ccirone2/LoRa-GateLink/docs/development.md

# Development

How changes are made, verified and released. The behavioural invariants that every change must keep are in
[CLAUDE.md](../CLAUDE.md), and how each firmware layer and the web console are built (and why) in
[architecture.md](architecture.md); read both before touching the firmware.

## Toolchain

`arduino-cli` (not PlatformIO). CI builds with these versions; match them locally when chasing a build
difference:

| Package | Version |
|---|---|
| `arduino-cli` | 1.5.1 |
| `arduino:samd` core | 1.8.14 |
| `arduino:avr` core (GateSim) | 1.8.8 |
| `LoRa` (sandeepmistry) | 0.8.0 |
| `Crypto` (rweather) | 0.4.0 |
| `FlashStorage` (cmaglie) | 1.0.0 |
| `ArduinoJson` | 7.4.3 |

When updating one, change it here, in `.github/workflows/ci.yml` (every job), `release.yml`, `fuzz.yml` and
`mutate.yml` (arduino-cli: each `setup-arduino-cli` step's `version`), and in `tools/agent/cloud_setup.sh`
(arduino-cli with its SHA-256; `tests/tools/test_agent_tooling.py` checks the last against the workflows and this
table).

The formal verification (`tools/verify`, [architecture.md](architecture.md#verification)) runs on these, as CI's
`verify` job installs them; `tools/verify/docker/Dockerfile` has them all for a machine without them (Windows,
macOS). Change a version there, in `ci.yml` (with its SHA-256) and here together (`tests/tools/test_verify.py`
checks):

| Tool | Version |
|---|---|
| ESBMC | 8.5 |
| TLC (`tla2tools.jar`) | 1.7.4 |
| Java | the runner's (17 or newer) |

The web console is plain JS (ES modules) with no build step; its lint and tests need Node.js 22 and `npm ci`
(`package.json`).

The Python tools, their tests and the bench suite share one environment, locked with hashes so every machine and CI
run the same versions: `pyproject.toml` lists the dependencies (ruff 0.17.0 in its `dev` group) and `uv.lock` pins
them. Install uv 0.12.24 or newer ([docs.astral.sh/uv](https://docs.astral.sh/uv/); `pyproject.toml` refuses an
older one), then:

```sh
uv sync                        # builds .venv from uv.lock (Python 3.12, from .python-version; uv fetches it if needed)
uv run pytest tests/tools -q   # any command, run in that environment (syncing it first)
uv add 'pkg>=1.2'              # a new dependency; `uv add --dev` for tooling. Both update uv.lock: commit it
uv lock --upgrade-package pkg  # a newer version within the bounds (Dependabot proposes these weekly)
```

`uv run` is how the commands in these docs are meant to be run; with `.venv` activated they also run as written
(`pytest ...`, `python tools/...`). The tools that use only the standard library (`docgen.py`, `check_contract.py`,
`release_evidence.py`, `fw_size.py`, `bench-wiring/serve.py`, the agent hooks) run under any Python 3.10 or newer
too; `gatelink.py` and `flash.py` need the environment (pyserial), and so does `logic.py` for its `--at` actions.

## Other commands

The routine ones (compile, flash, tests, the bench suite, `tools/gatelink.py` essentials) are in
[CLAUDE.md](../CLAUDE.md). The rest:

```sh
arduino-cli upload --fqbn arduino:samd:mkrwan1310 -p COMx firmware/GateLink   # plain upload (uv run tools/flash.py bounds the waits)
arduino-cli compile --fqbn arduino:avr:uno --warnings all tools/GateSim   # bench opener simulator (tools/GateSim/README.md)
python -m http.server 8000 -d web              # serve the web console at http://localhost:8000 (Chrome/Edge; not from file://)
GATELINK_HA_URL=https://<ha>:8123 uv run pytest tests/e2e -m power   # real power cuts through the power rig (LiPo in or out; tests chosen per state)
uv run tools/gatelink.py house hist --csv f.csv   # link quality history (hourly buckets) as CSV
uv run tools/gatelink.py rftest                # radio preflight for a new MKR board (bench-testing.md)
python tools/bench-wiring/serve.py             # the bench wiring record at http://localhost:8001 (never another server)
```

`make -C tests/native` needs g++ (without it, the Docker recipe in `tests/native/README.md`), and the fuzz targets
clang (`tests/native/fuzz/README.md`).

## Where things are tracked

| What | Where |
|---|---|
| Released changes (changelog) | [GitHub Releases](https://github.com/ccirone2/LoRa-GateLink/releases), one per firmware version |
| Open bugs, investigations, bench and field tasks | [TODO.md](../TODO.md) |
| Desired features and ideas | [ROADMAP.md](../ROADMAP.md) |
| Work in progress | A branch and pull request per change |

When an item is done, remove it from TODO.md / ROADMAP.md and describe it in the pull request; the release notes
are built from the pull requests since the last tag.

## Making a change

1. Branch from `main`.
2. Make the change. Things that must change together:
   - Console protocol (`console.cpp`) ↔ the web console (`web/js/`, and the fake board in `tests/web/`) ↔
     `tools/gatelink_client/` and `tests/e2e/` ↔ [docs/console.md](console.md).
   - Log events (`log.h`/`log.cpp`) ↔ the suite ↔ docs/console.md.
   - STATUS/DIAG wire format (`roles.h`) ↔ `role_house.cpp` / `console.cpp`; both boards need the new firmware.
   - Pins or role behaviour (`pins.h`) ↔ the `WIRING` table in `web/js/wiring.js` ↔ [docs/hardware.md](hardware.md).
   - A new setting: field in `Config` + default + `PARAMS` row with a new, never reused id + group, help text and
     label in `web/js/settings.js`, then `python tools/docgen.py --write` ([config.md](config.md)). Saved config is
     stored by param id, so a changed meaning or unit needs a new id; bump `CFG_VERSION` (it only guards the
     program-flash fallback) if the struct layout changes.
3. Bump `FW_VERSION` in `firmware/GateLink/config.h` for any firmware change (see Versioning).
4. Verify:
   ```sh
   arduino-cli compile --fqbn arduino:samd:mkrwan1310 --warnings all firmware/GateLink   # no warnings in GateLink/
   npm ci && npm test         # web console: lint, unit tests, browser tests (tests/web/README.md)
   uv run ruff check tests tools     # rules in ruff.toml
   uv run tools/check_contract.py   # firmware enums, log events and console commands vs the suite and docs
   python tools/docgen.py     # reference docs vs the source (--write regenerates the generated tables)
   make -C tests/native       # host tests: link/config, and both boards' firmware in a simulated site (tests/native/README.md)
   make -C tests/native cppcheck tidy coverage   # static analysis and coverage (in Docker on Windows, as the README says)
   uv run pytest tests/tools -q   # unit tests for the tools (release_evidence.py, docgen.py, the agent hooks, key backups, the bench suite's LiPo check)
   uv run pytest tests/e2e -v        # on the bench; see tests/e2e/README.md
   ```
5. Open a pull request with a summary and the bench results (suite pass count, anything new it found). CI
   compiles the firmware and GateSim (failing on warnings in project files) and checks the firmware's size budget
   (`tools/fw_size.py`: 160 KB flash, 24 KB static RAM; raising it is a decision for the pull request), runs the host
   unit tests, lints and tests the web console (ESLint, `node --test`, Playwright), installs the locked Python
   environment (`uv sync --locked`, which fails if `uv.lock` is out of step with `pyproject.toml`), byte-compiles and
   lints the Python (`uv run ruff check tests tools`), runs the tools' unit tests (`tests/tools`), collects the e2e suite (`pytest
   --collect-only`, which catches import and fixture errors without the bench), checks the docs against the source
   (`check_contract.py`, `docgen.py`), fails a pull request that changes the firmware without bumping `FW_VERSION`,
   lints the workflows (actionlint, with shellcheck), runs cppcheck and clang-tidy (`firmware/GateLink/.clang-tidy`)
   on the firmware and reports the host tests' coverage of it (failing below 85 % of lines; tests/native/README.md):
   `make -C tests/native cppcheck tidy coverage`.
6. Merge to `main`. Once CI has passed on `main`, the web console is deployed to GitHub Pages (`pages.yml`; also
   after each release build, to bundle its `.bin`, and by hand with `gh workflow run pages.yml`).

`main` is protected by a ruleset (repository settings): changes only through a pull request, merged as a merge
commit, with CI's `firmware`, `static`, `coverage`, `web`, `python` and `workflows` jobs passing; no force pushes or
deletion. The required checks are listed by job name in the ruleset, not here: rename or split one of those jobs and
every pull request waits for the old name until the ruleset is changed with it. The fuzz and mutation jobs aren't
required (they run only when their paths change). `v*` tags can't be moved or deleted (a second ruleset).

CI's actions are pinned by commit SHA and its runners by image (`ubuntu-24.04`); Dependabot
(`.github/dependabot.yml`) proposes action, npm and Python (`uv.lock`, ruff included) updates weekly, and the nightly deps-check routine
covers the Arduino cores and libraries, arduino-cli, uv and gcovr (CI runs gcovr 8.6).

## Test suites

- **Compile:** clean, with no warnings in project files (filter the output with `grep GateLink[\\/]`); CI fails on
  them.
- **Host tests** (`tests/native`, `make -C tests/native`, run by CI; [tests/native/README.md](../tests/native/README.md)):
  `link.cpp`, `config.cpp` and `histlog.cpp` against fakes, and the system tests: both boards' whole firmware in a
  simulated site (opener, controller, power, radio channel) with monitors that check every behavioural invariant
  each simulated millisecond, each test tagged with the invariants it covers. Extend them with any behaviour change,
  especially for paths the bench can't reach (replays, restarts, wraps, power cuts mid-save, races); `XFAIL_TEST`
  marks a known open bug.
- **Mutations:** `tests/native/mutations.json` breaks each invariant in a copy of the firmware and `tools/mutate.py`
  (weekly in CI) checks a test catches it; a firmware change that moves a mutation's text fails
  `tests/tools/test_mutate.py` until the catalog follows.
- **Fuzzing:** `tests/native/fuzz` fuzzes the frame, console and config parsers with the whole firmware under
  ASan/UBSan and the relay invariants; `make -C tests/native` replays its corpus, and `fuzz/crashes/` holds
  reproducers of known bugs that must keep crashing until fixed. CI (`fuzz.yml`) searches for new crashes a minute
  per target on pull requests that touch the firmware or `tests/native`, and half an hour per target nightly.
- **Bench end-to-end suite** (`tests/e2e`, pytest; [tests/e2e/README.md](../tests/e2e/README.md)): drives both
  boards, the GateSim and the Shelly (via Home Assistant) and checks the behavioural invariants after every scenario.
  It parses console replies, log event names/values and status fields (`tests/e2e/gatelink/`, and the console client
  `tools/gatelink_client/` it shares with `tools/gatelink.py`: `board.py`, `timeline.py`, wire enums in `wire.py`), so
  change it together with `console.cpp`/`log.cpp`/`roles.h`, like the web console; `tools/check_contract.py` (run by
  CI) checks the enums, log event names and console commands against the suite and [console.md](console.md).
  Scenario timings assume its test profile (`tests/e2e/gatelink/bench.py`).

## Reference docs from source

`tools/docgen.py` keeps the reference docs provably in step with the code (stdlib Python; it reads the web
console's tables by importing `web/js/settings.js`, `wiring.js` and `logdecode.js` in Node.js):

```sh
python tools/docgen.py           # check, as CI does: exit 1 listing every drift and how to fix it
python tools/docgen.py --write   # regenerate the generated sections in place, then check the rest
```

- **Generated** (between `<!-- docgen:NAME begin -->` and `<!-- docgen:NAME end -->`; edit the source, never the
  section): [config.md](config.md), every setting with its id, range, default, when it applies and its help text
  (`PARAMS`, `configDefaults()`, `paramValid()` in `config.cpp`; `GROUPS`, `HELP`, `MUST_MATCH`, `SELECTS` in
  `web/js/settings.js`; a setting missing from `GROUPS` or `HELP` fails, as the Config tab would hide it); and the
  message types, ACK results, STATUS and DIAG layouts in [protocol.md](protocol.md) "Wire formats" (`link.h`,
  `roles.h`). Descriptions `roles.h` lacks are in `ST_MEANING`/`STI_MEANING` in `docgen.py`.
- **Checked** (hand-written, compared with the source): the status fields `appFillStatus`, `houseStatus` and
  `gateStatus` write and the console events' fields, against [console.md](console.md), with the names an
  enumerated field can take; the link history fields (`FIELDS`); each command's arguments (`req["..."]`), the
  keys its reply carries and whether it is house or gate only, and the commands held while a relay pulses
  (`blocksLoop()`, also in CLAUDE.md); log events in `log.h` order, `log.cpp` and `logdecode.js` (and against
  console.md in `check_contract.py`); pins (`pins.h`) against every doc, the bench wiring record and
  `WIRING`/`IO_LABELS`; the frame layout; the radio settings that must match; the e2e profile's "firmware
  defaults". Every backticked snake_case name in the docs (`ctrl_confirm_ms`, `link_up`,
  `test_power_loss_at_rest`) must still be a setting, field, argument, log event, e2e test or release criterion,
  so a rename can't live on in the prose (`OTHER_NAMES` in `docgen.py` takes any other kind).
- **Facts:** `FACTS` in `docgen.py` lists the constants and setting defaults the docs quote (`INTERLOCK_MS`,
  `BOOT_SETTLE_MS`, the watchdog, the radio defaults, toolchain versions, ...). Each reads its value from the
  source with one regex and finds every quote of it with another, converting units (`s` turns ms into s). Two
  kinds of quote are checked without an entry: a setting's default ("`setting` (default X)", "`setting`, default
  on", "`setting` is X by default", "`setting` defaults to X", "the default `setting` of X") against
  `configDefaults()`, and a time constant next to its name ("`INTERLOCK_MS` (100 ms)", "100 ms (`INTERLOCK_MS`)").
  When a doc quotes a new value another way, add a fact next to the similar ones:

  ```python
  D("TXQ_LEN", f"{FW}/link.cpp", Q(PRO, r"queued (\w+) deep"), Q(ARCH, r"wait in a (\d+)-deep queue")),
  ```

  A space in a doc pattern matches any whitespace, line breaks included; a quote's first group is the value
  (digits, `0x..`, or a word such as "four"). A reworded doc fails with "no quote of ...": fix the pattern.

## Versioning

`FW_VERSION` is `MAJOR.MINOR.PATCH`, reported by `info`, `status` and the remote diagnostics.

- **PATCH:** fixes and small additions that keep the config layout and the radio wire format.
- **MINOR:** a new feature or input, a `CFG_VERSION` bump, or a change that needs both boards updated together
  (STATUS/DIAG layout, frame format).
- **MAJOR:** reserved for a protocol break with no upgrade path, or 1.0 at the install.

Saved config survives uploads (from 0.5.0) and is matched by param id, so an added setting takes its default
and a removed one is ignored (log event `cfg`, b; from 0.13.3 an older firmware's saves keep it in the record,
so it's back after the next upgrade). Say so in the release notes when that happens, and when a
config exported from the old version may not import cleanly.

## Releasing

After the pull request carrying a new `FW_VERSION` is merged (`/release` in Claude Code walks through this):

1. Run the bench on the merged version as [release-criteria.md](release-criteria.md) asks for its kind (PATCH:
   the full suite and a soak; MINOR adds the power runs with LiPos out and in, a 60-minute long soak and a full
   suite at 17 dBm; MAJOR adds a 24-hour soak and the install checks).
2. `python tools/release_evidence.py collect vX.Y.Z` writes the evidence, `docs/releases/vX.Y.Z.md`, from the
   runs' `summary.json` (exit 1 while a criterion is unmet). Merge it in a pull request with the bench results in
   its body.
3. Once CI has passed on that merge commit, `python tools/release_evidence.py check vX.Y.Z --ci`, then create a
   draft release with notes on the merge commit and run the release workflow:
   ```sh
   gh release create vX.Y.Z --draft --target <merge-commit-sha> --title "vX.Y.Z — <one-line summary>" --notes-file notes.md
   gh workflow run release.yml -f tag=vX.Y.Z
   ```
   Releases are immutable once published (a repository setting since v0.17.0): the tag can't move, and files can't be
   added, replaced or removed. So a release is never published by hand while its files aren't attached.
4. The `release` workflow checks the draft (its target a full SHA on `main`, the tag still free), `FW_VERSION` and
   the evidence (`check --ci`), builds the firmware at that commit with a read-only token, attaches
   `GateLink-vX.Y.Z.bin`, `GateLink-vX.Y.Z.bin.sha256` and the evidence as `GateLink-vX.Y.Z-evidence.md` to the draft,
   and publishes it, which creates the tag. GitHub attests an immutable release (`gh release verify`). Anything that
   fails before it publishes leaves the draft unpublished; it is fixed and the workflow started again. When it succeeds the `pages` workflow checks the `.bin` against that `.sha256` and redeploys the
   web console with it and a `firmware/latest.json` (version, file, sha256, size) bundled in (the page can't fetch release assets from github.com: no CORS), so **Board →
   Firmware update** offers it. They are never committed (`web/firmware/` is ignored).

The web console flashes over Web Serial by speaking the Arduino SAM-BA bootloader protocol itself (`SamBa` in
`web/js/samba.js`, driven by `web/js/firmware.js`): a 1200-baud open/close resets the board into the bootloader (USB PID 0x0059, a separate port
grant), then erase from 0x2000 (`X`), 4 KB chunks staged in RAM and written (`S` + `Y`), CRC-16 check (`Z`)
and a reset. The touch itself erases the application's first flash row (the vector table: the SAMD core's `banzai()`
in `Reset.cpp`, so the bootloader stays in charge), so a board reset into its bootloader that way boots again only
once an image is written; a double-tap of the reset button enters it without erasing anything. It recognises GateLink images by the `GATELINK_FW=x.y.z` marker (`FW_MARKER`, `config.cpp`; the
version reported by `info`/`status` is read from it so the linker keeps it).

Release notes template:

```markdown
**Upgrade:** <flash both boards | gate only | ...>. <Config layout changed (CFG_VERSION n): re-apply config.>

## Firmware
- ...

## Web console
- ...

## Tests and tools
- ...

## Bench results
<KIND> release, all criteria met: [evidence](https://github.com/ccirone2/LoRa-GateLink/blob/vX.Y.Z/docs/releases/vX.Y.Z.md).
- Full suite: N passed. Soak: 20 cycles, <latencies>. <Power, long soak, 17 dBm runs for MINOR.> <Reruns.>
  <Anything notable.>

PRs: #n
```

## Claude Code skills

Project skills live in `.claude/skills/` (`/implement`, `/flash`, `/bench`, `/release`, `/doc-audit`,
`/pr-followup`); [agent-tooling.md](agent-tooling.md) describes each, with the hooks and the nightly routines.
