ccirone2/LoRa-GateLink/docs/config.md

# Settings reference

Every setting a board keeps in its saved config, by the name `config.get` returns and `config.set` and
`remote.set` take ([console.md](console.md)), in the groups of the web console's Config tab. Values are integers
in the unit the name ends with (`_ms`, `_s`, `_hz`; `tx_power` in dBm); a 0/1 setting is an off/on toggle. Apply
sets a value at once and Save keeps it across reboots. The saved config survives firmware uploads and is stored
by id, so an id is never reused: a setting whose meaning or unit changes gets a new one.

The tables below are generated from the firmware (`PARAMS[]`, `configDefaults()` and `paramValid()` in
`firmware/GateLink/config.cpp`) and the Config tab's own tables (`web/js/settings.js`) by `tools/docgen.py`.

<!-- docgen:params begin -->
<!-- Generated by tools/docgen.py from firmware/GateLink/config.cpp (PARAMS, configDefaults, paramValid) and web/js/settings.js (GROUPS, HELP, MUST_MATCH, SELECTS): edit the source, then run python tools/docgen.py --write. -->

**Range** is what `config.set` accepts. **Applies:** *at once*; *radio restart* (applied at once, the radio
re-initialises); *after reboot* (the board keeps running as before until it restarts). *remote*: the house can
write the gate's over LoRa (`remote.set`). *both boards*: must be the same on both boards (marked * on the Config
tab). **What it does** is the Config tab's help text.

## General

| Setting | Id | Range | Default | Applies | What it does |
|---|---|---|---|---|---|
| `role` | 1 | 0 (unset), 1 (house), 2 (gate) | 0 (unset) | after reboot | Which end this board is: house (next to the controller) or gate (at the opener). Takes effect after Save and reboot. |
| `net_id` | 2 | 0–255 | 66 (0x42) | at once, both boards | Both boards must match. Change it only if another GateLink pair shares the channel nearby. |

## Radio

| Setting | Id | Range | Default | Applies | What it does |
|---|---|---|---|---|---|
| `freq_hz` | 3 | 862000000–928000000 (862–928 MHz) | 915000000 (915 MHz) | radio restart, both boards | Both boards must match. US 902–928 MHz, EU 863–870 MHz. Move off the default only if Link history shows a high noise floor. |
| `sf` | 4 | 7–12 | 9 | radio restart, both boards | Both boards must match. Raise it a step at a time if the link is weak or drops; each step roughly doubles airtime, so replies get slower. Lower it for faster replies on a strong link. |
| `bw_hz` | 5 | 125000 (125 kHz), 250000 (250 kHz), 500000 (500 kHz) | 500000 (500 kHz) | radio restart, both boards | Both boards must match. Keep 500 kHz in the US (keeps a single-channel link within FCC rules). Narrower reaches further but every frame takes longer. |
| `cr` | 6 | 5–8 | 5 | radio restart, both boards | Both boards must match. Extra error correction, 4/5 to 4/8. Raise it if Link history shows CRC errors with a decent signal; frames get longer. |
| `tx_power` | 7 | 2–20 | 17 | radio restart | Transmit power in dBm; may differ between the boards. Lower it on USB power or at short range (full power can brown out a weak supply); raise it if the link is marginal. |
| `sync_word` | 8 | 0–255 | 18 (0x12) | radio restart, both boards | Both boards must match. Rarely changed: it filters out other LoRa networks on the same channel. |

## Link

| Setting | Id | Range | Default | Applies | What it does |
|---|---|---|---|---|---|
| `retries` | 9 | 0–10 | 8 | at once, remote | Resends of an unacknowledged message, spread over its lifetime. Raise it on a lossy link; lower it to keep the channel quieter. |
| `heartbeat_s` | 10 | 5–3600 | 30 | at once, remote | Gate: how often it reports status when nothing changes. Shorter spots a dead link sooner but uses more airtime. The house waits at least 2.5 heartbeats before calling the link lost. |
| `link_timeout_s` | 11 | 15–10800 | 100 | at once, remote | House: no status report from the gate this long = link lost (the contact sensor then reads open). Raise it if short dropouts cause false alarms; it is never shorter than 2.5 gate heartbeats. Gate: nothing heard from the house this long (at least 2.5 of its own heartbeats) = link down, for its LED and fault output. |
| `cmd_ttl_s` | 12 | 2–120 | 10 | at once | House: how long a gate command keeps being retried before it is dropped (never fired late). Raise it if commands give up during short dropouts; lower it so a stale command isn’t delivered seconds later. |

## Inputs

| Setting | Id | Range | Default | Applies | What it does |
|---|---|---|---|---|---|
| `debounce_ms` | 13 | 10–1000 | 50 | at once, remote | How long an input must hold steady before it counts. Raise it if long field wires or a bouncy contact show up as flicker in the log. |

## Gate node

| Setting | Id | Range | Default | Applies | What it does |
|---|---|---|---|---|---|
| `pulse_ms` | 16 | 100–5000 (0.1–5 s) | 500 (0.5 s) | at once, remote | Gate: how long the OPEN/CLOSE contact closes. Raise it if the opener misses short presses; keep it short, as other devices share these inputs. |
| `travel_timeout_s` | 17 | 5–300 | 60 | at once, remote | Longest a full open or close should take. Set it a little above your gate’s real travel time; past it, the gate counts as stuck. Set it on the gate (here or with a remote write): the house follows the gate’s value. |
| `power_sense` | 26 | 0–1 | 1 (on) | at once, remote | Gate: IN3 watches the AC-powered 24 V supply. Without AC, commands run only while a limit reads; a limit that still reads (the opener runs on its battery) is trusted, and with none the gate reads “no power” instead of between. Turn off only if IN3 isn’t wired. |
| `closed_sense` | 34 | 0–1 | 0 (off) | at once | Gate: IN4 is a second closed sensor on the gate leaf (a magnetic contact), so a failed closed-limit relay can’t make an open gate read closed. The gate reads closed only while the sensor and the closed limit agree; if they disagree for 5 s it reads fault. Turn on only once the sensor is fitted and wired: without one the gate never reads closed. |

## House node

| Setting | Id | Range | Default | Applies | What it does |
|---|---|---|---|---|---|
| `ctrl_sync` | 18 | 0–1 | 1 (on) | at once | House: K1 drives the controller’s switch input so the controller always shows the real gate state. Turn off only if the controller has no switch input. |
| `sync_window_ms` | 19 | 500–10000 (0.5–10 s) | 3000 (3 s) | at once | House: after K1 changes, controller changes count as its echo, not a command, for this long. Raise it if a slow controller’s echo turns into an unwanted gate command. |
| `resync_ms` | 20 | 200–5000 (0.2–5 s) | 1000 (1 s) | at once | House: how long K1 is released when re-syncing a controller that is out of step. Raise it if the controller doesn’t notice a short blip. |
| `mismatch_timeout_s` | 21 | 10–600 | 75 | at once | House: how long the controller may disagree with the gate before K1 re-syncs it (at once after boot or power return). Lower it for faster correction; raise it if re-syncs fight someone using the controller. |
| `sensor_invert` | 22 | 0–1 | 0 (off) | at once | House: flips the contact sensor output (K2). Use it if the alarm shows open while the gate is closed. |
| `linkloss_open` | 23 | 0–1 | 1 (on) | at once | House: the contact sensor reads open while the link is lost, so the alarm never trusts a stale “closed”. Turn off only if dropouts cause too many false alerts. |
| `ctrl_power_sense` | 27 | 0–1 | 1 (on) | at once | House: IN2 watches the controller’s supply, so a power cut (which drops its relay) isn’t mistaken for a close command. Turn off only if IN2 isn’t wired. |
| `ctrl_power_pmic` | 31 | 0–1 | 1 (on) | at once | House: the board’s own supply counts as controller power too, since both run off the same supply (the board through its 5 V converter). It notices a cut or a short dip within milliseconds, before the controller’s relay drops, where the IN2 opto lags ~1.7 s and can miss short dips. Turn off if the board has its own supply, or while it runs on a USB cable that carries power. |
| `ctrl_confirm_ms` | 28 | 0–5000 (0–5 s) | 500 (0.5 s) | at once | House: a controller switch-OFF waits this long before it becomes a CLOSE, so one caused by the controller losing power (its relay drops before the power sense notices) can be discarded. Switch-ON (OPEN) goes at once: a power loss can’t cause it. With `ctrl_power_pmic` the board’s supply drops first, so 0.5 s is plenty; with IN2 alone keep it above the opto’s lag (~1.7 s on the bench, so 3000). |
| `ctrl_settle_ms` | 29 | 0–60000 (0–60 s) | 10000 (10 s) | at once | House: after the controller powers up (or the house boots), its changes count as sync for at least this long. Raise it if the controller takes longer to settle after power returns. |

## Fault output

| Setting | Id | Range | Default | Applies | What it does |
|---|---|---|---|---|---|
| `fault_out` | 32 | 0–1 | 0 (off) | at once | Use D5 as a “needs attention” output for the alarm system: high while this board is healthy (radio working, link up and, as the gate sees or reports it, AC power present, no limit fault and no reboot loop), low otherwise, and low after a restart until the board has started up. A dead board or a cut wire reads as a fault too. 3.3 V, a few mA: wire it to an opto or a relay module input, never a relay coil. Off: D5 stays an unused input. Takes effect at once; set it on each board that has D5 wired. |
| `fault_hold_s` | 33 | 0–600 | 10 | at once, remote | How long a problem must last before D5 goes low, so a short dropout or blip doesn’t trip the alarm. Recovery raises D5 at once. 0 = low as soon as a problem appears. |

## Advanced

| Setting | Id | Range | Default | Applies | What it does |
|---|---|---|---|---|---|
| `in1_invert` | 14 | 0–1 | 0 (off) | at once | IN1 (house: controller output; gate: open limit). Leave off. Inverted, a dead opto or cut wire reads as active; fix a reversed signal in the wiring instead. |
| `in2_invert` | 15 | 0–1 | 0 (off) | at once | IN2 (house: controller power; gate: closed limit). Leave off. Inverted, a dead opto or cut wire reads as active; fix a reversed signal in the wiring instead. |
| `in3_invert` | 24 | 0–1 | 0 (off) | at once | IN3 (house: spare; gate: AC power). Leave off. Inverted, a dead opto or cut wire reads as active; fix a reversed signal in the wiring instead. |
| `in4_invert` | 25 | 0–1 | 0 (off) | at once | IN4 (house: spare; gate: closed sensor, or spare). Leave off. Inverted, a dead opto or cut wire reads as active; fix a reversed signal in the wiring instead. |
| `uart_console` | 30 | 0–1 | 0 (off) | at once | Also run this console on the board’s serial pins (13 RX, 14 TX; 3.3 V, 250 kbaud) for a USB-to-UART adapter. Bench power testing only: the adapter keeps its port while the board is unpowered. Leave off at the install. |

<!-- docgen:params end -->
