ccirone2/LoRa-GateLink/docs/releases/v0.20.7.md

# GateLink v0.20.7: release evidence

**PATCH** release (previous release: v0.20.1), commit `63a90f0810`, firmware tree `34c4a9f282`. Written by `python tools/release_evidence.py collect v0.20.7` on 2026-10-30; the criteria are in [docs/release-criteria.md](../release-criteria.md).

**All criteria for this release are met.**

## Criteria

| Criterion | Required for | Met | Evidence |
|---|---|---|---|
| `ci`: CI green on the release commit (all jobs) | every release | yes | [ci.yml run](https://github.com/ccirone2/LoRa-GateLink/actions/runs/41081198402): success (coverage success, verify success, static success, web success, python success, workflows success, firmware success) |
| `full_suite`: Full suite: default selection, GATELINK_KEY set, the bench's own tx_power | every release | yes | run 20261030-080208: 70 passed |
| `soak`: Soak: -m soak, at least 20 cycles | every release | yes | run 20261030-082420: 1 passed |
| `power_lipo_out`: Power: -m power with both LiPos out | MINOR, MAJOR | no (not required) | no run yet: `pytest tests/e2e -m power` |
| `power_lipo_in`: Power: -m power with both LiPos in | MINOR, MAJOR | no (not required) | no run yet: `pytest tests/e2e -m power` |
| `longsoak_60m`: Long soak: -m longsoak, at least 60 min | MINOR, MAJOR | no (not required) | no run yet: `pytest tests/e2e -m longsoak --soak-minutes 60` |
| `full_suite_17dbm`: Full suite at --tx-power 17 on the install-like supplies | MINOR, MAJOR | no (not required) | no run yet: `GATELINK_KEY=<key> pytest tests/e2e -v --tx-power 17`; other runs of its tests: 20261030-080208 |
| `longsoak_24h`: Long soak: -m longsoak, at least 24 h | MAJOR | no (not required) | no run yet: `pytest tests/e2e -m longsoak --soak-minutes 1440` |
| `install_rf`: Real RF at the install site (TODO.md: Real RF) | MAJOR | no (not required) | not ticked in the install notes (`- [x] install_rf: <what was done, when, numbers>`) |
| `install_full_power`: Full power at the install for days (TODO.md: Full power at the install) | MAJOR | no (not required) | not ticked in the install notes (`- [x] install_full_power: <what was done, when, numbers>`) |

## Runs

### 20261030-080208

- **When:** 2026-10-30 08:02 to 08:24 -0500 (22 min)
- **Command:** `pytest tests/e2e -v`
- **Options:** the boards' saved tx_power (5 dBm or less), GATELINK_KEY set
- **Commit:** `986732ab3f`, firmware tree `34c4a9f282`
- **Boards:** house 0.20.7 (…183013, COM5), gate 0.20.7 (…0C301C, COM21)
- **Results:** 70 passed
- **Counts for:** full_suite
- **Facts:**
  - consoles: house USB COM5 + UART tap COM17, gate USB COM21 + UART tap COM12
  - controller power: wired (in2_invert fakes a loss)
  - key id: 16b5da85
  - firmware: 0.20.7
  - config store: house spi, gate spi
  - free_ram after hist.get, config.get and log.get (house): 2267 B
  - free_ram after hist.get, config.get and log.get (gate): 2267 B
  - ping RTT: 152 ms
  - RSSI/SNR at house: -45 dBm / 7.5 dB
  - RSSI/SNR at gate: -44 dBm / 5 dB
  - controller SW mode: follows the SW level
  - closest relay interlock gap (ms): 100
  - noise floor (house / gate): -104 / -103 dBm
- **Anomalies:** none

### 20261030-082420

- **When:** 2026-10-30 08:24 to 08:32 -0500 (8 min)
- **Command:** `pytest tests/e2e -m soak --cycles 20 -v`
- **Options:** the boards' saved tx_power (5 dBm or less), --cycles 20, no GATELINK_KEY
- **Commit:** `986732ab3f`, firmware tree `34c4a9f282`
- **Boards:** house 0.20.7 (…183013, COM5), gate 0.20.7 (…0C301C, COM21)
- **Results:** 1 passed
- **Counts for:** soak
- **Facts:**
  - consoles: house USB COM5 + UART tap COM17, gate USB COM21 + UART tap COM12
  - controller power: wired (in2_invert fakes a loss)
- **Anomalies:** none

## Install notes

<!-- notes:start -->
Hand-written, and kept when the file is collected again: anything a reviewer should know.
<!-- notes:end -->

<!-- release-evidence
{
 "version": "0.20.7",
 "kind": "patch",
 "previous": "0.20.1",
 "commit": "63a90f0810767cfd521c10463e4b180c60cb3afb",
 "firmware_tree": "34c4a9f282c5740eae42be06d689e2ec99d66b49",
 "collected": "2026-10-30T15:23:36-05:00",
 "schema": 1,
 "criteria": [
  {
   "id": "ci",
   "title": "CI green on the release commit (all jobs)",
   "required_for": "patch",
   "required": true,
   "manual": false,
   "met": true,
   "evidence": "[ci.yml run](https://github.com/ccirone2/LoRa-GateLink/actions/runs/41081198402): success (coverage success, verify success, static success, web success, python success, workflows success, firmware success)",
   "runs": []
  },
  {
   "id": "full_suite",
   "title": "Full suite: default selection, GATELINK_KEY set, the bench's own tx_power",
   "required_for": "patch",
   "required": true,
   "manual": false,
   "met": true,
   "evidence": "run 20261030-080208: 70 passed",
   "runs": [
    "20261030-080208"
   ]
  },
  {
   "id": "soak",
   "title": "Soak: -m soak, at least 20 cycles",
   "required_for": "patch",
   "required": true,
   "manual": false,
   "met": true,
   "evidence": "run 20261030-082420: 1 passed",
   "runs": [
    "20261030-082420"
   ]
  },
  {
   "id": "power_lipo_out",
   "title": "Power: -m power with both LiPos out",
   "required_for": "minor",
   "required": false,
   "manual": false,
   "met": false,
   "evidence": "no run yet: `pytest tests/e2e -m power`",
   "runs": []
  },
  {
   "id": "power_lipo_in",
   "title": "Power: -m power with both LiPos in",
   "required_for": "minor",
   "required": false,
   "manual": false,
   "met": false,
   "evidence": "no run yet: `pytest tests/e2e -m power`",
   "runs": []
  },
  {
   "id": "longsoak_60m",
   "title": "Long soak: -m longsoak, at least 60 min",
   "required_for": "minor",
   "required": false,
   "manual": false,
   "met": false,
   "evidence": "no run yet: `pytest tests/e2e -m longsoak --soak-minutes 60`",
   "runs": []
  },
  {
   "id": "full_suite_17dbm",
   "title": "Full suite at --tx-power 17 on the install-like supplies",
   "required_for": "minor",
   "required": false,
   "manual": false,
   "met": false,
   "evidence": "no run yet: `GATELINK_KEY=<key\u003e pytest tests/e2e -v --tx-power 17`; other runs of its tests: 20261030-080208",
   "runs": []
  },
  {
   "id": "longsoak_24h",
   "title": "Long soak: -m longsoak, at least 24 h",
   "required_for": "major",
   "required": false,
   "manual": false,
   "met": false,
   "evidence": "no run yet: `pytest tests/e2e -m longsoak --soak-minutes 1440`",
   "runs": []
  },
  {
   "id": "install_rf",
   "title": "Real RF at the install site (TODO.md: Real RF)",
   "required_for": "major",
   "required": false,
   "manual": true,
   "met": false,
   "evidence": "not ticked in the install notes (`- [x] install_rf: <what was done, when, numbers\u003e`)",
   "runs": []
  },
  {
   "id": "install_full_power",
   "title": "Full power at the install for days (TODO.md: Full power at the install)",
   "required_for": "major",
   "required": false,
   "manual": true,
   "met": false,
   "evidence": "not ticked in the install notes (`- [x] install_full_power: <what was done, when, numbers\u003e`)",
   "runs": []
  }
 ],
 "reruns": [],
 "runs": [
  {
   "run": "20261030-080208",
   "start": "2026-10-30T08:02:04-05:00",
   "end": "2026-10-30T08:24:14-05:00",
   "minutes": 22.2,
   "command": "pytest tests/e2e -v",
   "selection": {
    "markexpr": "not soak and not longsoak and not rf and not power",
    "keyword": "",
    "paths": [
     "tests/e2e"
    ]
   },
   "commit": "986732ab3fbe94ba0d7cdb67ad7f618ca40e0768",
   "firmware_tree": "34c4a9f282c5740eae42be06d689e2ec99d66b49",
   "dirty_paths": [],
   "boards": {
    "gate": {
     "fw": "0.20.7",
     "usb_serial": "B86085DB5031344E432E3120FF0C301C",
     "port": "COM21",
     "cfg_store": "spi",
     "flash_id": "ef4015"
    },
    "house": {
     "fw": "0.20.7",
     "usb_serial": "066322EE5030534D4D2E3120FF183013",
     "port": "COM5",
     "cfg_store": "spi",
     "flash_id": "ef4015"
    }
   },
   "options": {
    "tx_power": null,
    "cycles": 20,
    "soak_minutes": 120,
    "rf_cycles": 5,
    "gatelink_key": true,
    "ha_power_entity": null,
    "no_uart": false
   },
   "counts": {
    "passed": 70
   },
   "counts_for": [
    "full_suite"
   ],
   "failed": [],
   "skipped": [],
   "latencies": [
    {
     "name": "controller edge -\u003e power sense drop (must be < ctrl_confirm_ms)",
     "n": 1,
     "min": 0.10699999999999932,
     "median": 0.10699999999999932,
     "max": 0.10699999999999932
    },
    {
     "name": "IN2 dark -\u003e health ctrl_sense (30 s)",
     "n": 1,
     "min": 30.235460499301553,
     "median": 30.235460499301553,
     "max": 30.235460499301553
    },
    {
     "name": "outage -\u003e house link_down",
     "n": 1,
     "min": 11.211250200763345,
     "median": 11.211250200763345,
     "max": 11.211250200763345
    },
    {
     "name": "link restored -\u003e house link_up",
     "n": 1,
     "min": 4.964531700506825,
     "median": 4.964531700506825,
     "max": 4.964531700506825
    },
    {
     "name": "cmd_sent -\u003e cmd_dropped (dead link)",
     "n": 1,
     "min": 10.009999999999991,
     "median": 10.009999999999991,
     "max": 10.009999999999991
    },
    {
     "name": "cmd_sent -\u003e gate cmd_rx (after short outage)",
     "n": 1,
     "min": 2.36099999999999,
     "median": 2.36099999999999,
     "max": 2.36099999999999
    },
    {
     "name": "cmd_sent -\u003e gate cmd_rx (after 4 s outage)",
     "n": 1,
     "min": 4.126999999999953,
     "median": 4.126999999999953,
     "max": 4.126999999999953
    },
    {
     "name": "link restored -\u003e house learns missed move",
     "n": 1,
     "min": 4.703220000177623,
     "median": 4.703220000177623,
     "max": 4.703220000177623
    },
    {
     "name": "link restored -\u003e house shows the hidden move",
     "n": 1,
     "min": 4.676850800655757,
     "median": 4.676850800655757,
     "max": 4.676850800655757
    },
    {
     "name": "missed move: K2 open (polled)",
     "n": 1,
     "min": 5.272418799556817,
     "median": 5.272418799556817,
     "max": 5.272418799556817
    },
    {
     "name": "replayed HELLO -\u003e held command released",
     "n": 1,
     "min": 1.3999999999999773,
     "median": 1.3999999999999773,
     "max": 1.3999999999999773
    },
    {
     "name": "controller -\u003e house cmd_sent",
     "n": 2,
     "min": 0.2794953002854754,
     "median": 0.3257570000365604,
     "max": 0.3257570000365604
    },
    {
     "name": "cmd_sent -\u003e gate pulse (LoRa)",
     "n": 2,
     "min": 0.12400000000002365,
     "median": 0.1710000000000491,
     "max": 0.1710000000000491
    },
    {
     "name": "gate pulse -\u003e opener moving",
     "n": 2,
     "min": 0.03099999999994907,
     "median": 0.12400000000002365,
     "max": 0.12400000000002365
    },
    {
     "name": "gate state -\u003e house state (LoRa)",
     "n": 2,
     "min": 0.06700000000000728,
     "median": 0.10900000000003729,
     "max": 0.10900000000003729
    },
    {
     "name": "controller -\u003e house shows open (incl. 8s travel)",
     "n": 1,
     "min": 8.643495300285508,
     "median": 8.643495300285508,
     "max": 8.643495300285508
    },
    {
     "name": "controller -\u003e house shows closed (incl. 8s travel)",
     "n": 1,
     "min": 8.57975700003658,
     "median": 8.57975700003658,
     "max": 8.57975700003658
    },
    {
     "name": "command -\u003e travel timeout reported",
     "n": 1,
     "min": 15.02800000000002,
     "median": 15.02800000000002,
     "max": 15.02800000000002
    },
    {
     "name": "travel timeout -\u003e house resync",
     "n": 1,
     "min": 0.17000000000007276,
     "median": 0.17000000000007276,
     "max": 0.17000000000007276
    },
    {
     "name": "gate reboot -\u003e session re-established",
     "n": 1,
     "min": 3.175450200214982,
     "median": 3.175450200214982,
     "max": 3.175450200214982
    },
    {
     "name": "house reboot -\u003e controller resynced",
     "n": 1,
     "min": 13.621373599395156,
     "median": 13.621373599395156,
     "max": 13.621373599395156
    }
   ],
   "facts": {
    "consoles": "house USB COM5 + UART tap COM17, gate USB COM21 + UART tap COM12",
    "controller power": "wired (in2_invert fakes a loss)",
    "key id": "16b5da85",
    "firmware": "0.20.7",
    "config store": "house spi, gate spi",
    "free_ram after hist.get, config.get and log.get (house)": "2267 B",
    "free_ram after hist.get, config.get and log.get (gate)": "2267 B",
    "ping RTT": "152 ms",
    "RSSI/SNR at house": "-45 dBm / 7.5 dB",
    "RSSI/SNR at gate": "-44 dBm / 5 dB",
    "controller SW mode": "follows the SW level",
    "closest relay interlock gap (ms)": "100",
    "noise floor (house / gate)": "-104 / -103 dBm"
   },
   "anomalies": []
  },
  {
   "run": "20261030-082420",
   "start": "2026-10-30T08:24:17-05:00",
   "end": "2026-10-30T08:32:25-05:00",
   "minutes": 8.1,
   "command": "pytest tests/e2e -m soak --cycles 20 -v",
   "selection": {
    "markexpr": "soak",
    "keyword": "",
    "paths": [
     "tests/e2e"
    ]
   },
   "commit": "986732ab3fbe94ba0d7cdb67ad7f618ca40e0768",
   "firmware_tree": "34c4a9f282c5740eae42be06d689e2ec99d66b49",
   "dirty_paths": [],
   "boards": {
    "gate": {
     "fw": "0.20.7",
     "usb_serial": "B86085DB5031344E432E3120FF0C301C",
     "port": "COM21",
     "cfg_store": "spi",
     "flash_id": "ef4015"
    },
    "house": {
     "fw": "0.20.7",
     "usb_serial": "066322EE5030534D4D2E3120FF183013",
     "port": "COM5",
     "cfg_store": "spi",
     "flash_id": "ef4015"
    }
   },
   "options": {
    "tx_power": null,
    "cycles": 20,
    "soak_minutes": 120,
    "rf_cycles": 5,
    "gatelink_key": false,
    "ha_power_entity": null,
    "no_uart": false
   },
   "counts": {
    "passed": 1
   },
   "counts_for": [
    "soak"
   ],
   "failed": [],
   "skipped": [],
   "latencies": [
    {
     "name": "controller -\u003e house cmd_sent",
     "n": 40,
     "min": 0.16959969979524203,
     "median": 0.3231089997664043,
     "max": 0.6480593000575823
    },
    {
     "name": "cmd_sent -\u003e gate pulse (LoRa)",
     "n": 40,
     "min": 0.014999999999986358,
     "median": 0.047000000000025466,
     "max": 0.1560000000000059
    },
    {
     "name": "gate pulse -\u003e opener moving",
     "n": 40,
     "min": 0.03099999999994907,
     "median": 0.10899999999999466,
     "max": 0.1260000000000332
    },
    {
     "name": "gate state -\u003e house state (LoRa)",
     "n": 40,
     "min": 0.047000000000025466,
     "median": 0.09200000000001296,
     "max": 0.15000000000000568
    },
    {
     "name": "controller -\u003e house shows open (incl. 8s travel)",
     "n": 20,
     "min": 8.510963299661881,
     "median": 8.547267199330037,
     "max": 8.678418900102372
    },
    {
     "name": "controller -\u003e house shows closed (incl. 8s travel)",
     "n": 20,
     "min": 8.424632199645032,
     "median": 8.5553572996929,
     "max": 8.908059300057573
    }
   ],
   "facts": {
    "consoles": "house USB COM5 + UART tap COM17, gate USB COM21 + UART tap COM12",
    "controller power": "wired (in2_invert fakes a loss)"
   },
   "anomalies": []
  }
 ],
 "not_counted": []
}
-->
