ccirone2/LoRa-GateLink/docs/releases/v0.17.0.md

# GateLink v0.17.0: release evidence

**MINOR** release (previous release: v0.15.2), commit `9a053cc3de`, firmware tree `430bcbeca7`. Written by `python tools/release_evidence.py collect v0.17.0` on 2026-10-14; the criteria are in [docs/release-criteria.md](../release-criteria.md).

**All criteria for this release are met.**

## Criteria

| Criterion | Required for | Met | Evidence |
|---|---|---|---|
| `ci`: CI green on the release commit (all jobs) | every release | yes | [ci.yml run](https://github.com/ccirone2/LoRa-GateLink/actions/runs/38679564495): success (static success, firmware success, coverage success, web success, python success, workflows success) |
| `full_suite`: Full suite: default selection, GATELINK_KEY set, the bench's own tx_power | every release | yes | run 20261014-074854: 67 passed |
| `soak`: Soak: -m soak, at least 20 cycles | every release | yes | run 20261014-080901: 1 passed |
| `power_lipo_out`: Power: -m power with both LiPos out | MINOR, MAJOR | yes | run 20261014-081726: 24 passed, 6 skipped |
| `power_lipo_in`: Power: -m power with both LiPos in | MINOR, MAJOR | yes | run 20261014-230651: 6 passed, 24 skipped |
| `longsoak_60m`: Long soak: -m longsoak, at least 60 min | MINOR, MAJOR | yes | run 20261014-205704: 1 passed |
| `full_suite_17dbm`: Full suite at --tx-power 17 on the install-like supplies | MINOR, MAJOR | yes | run 20261014-231116: 66 passed, 1 failed; `test_history_outage` failed (AssertionError: gate down_s 0); passed its one rerun 20261014-233421 |
| `longsoak_24h`: Long soak: -m longsoak, at least 24 h | MAJOR | no (not required) | no run yet: `pytest tests/e2e -m longsoak --soak-minutes 1440`; other runs of its tests: 20261014-205704 |
| `install_rf`: Real RF at the install site (TODO.md: Real RF) | MAJOR | no (not required) | not ticked in the install notes (`- [x] install_rf: <what was done, when, numbers>`) |
| `install_full_power`: Full power at the install for days (TODO.md: Full power at the install) | MAJOR | no (not required) | not ticked in the install notes (`- [x] install_full_power: <what was done, when, numbers>`) |

## Reruns

One failed scenario per criterion may be rerun once (docs/release-criteria.md).

| Run | Scenario | Failure | Rerun |
|---|---|---|---|
| 20261014-231116 | `test_history.py::test_history_outage` | AssertionError: gate down_s 0 | 20261014-233421 |

## Runs

### 20261014-074854

- **When:** 2026-10-14 07:48 to 08:08 -0500 (20 min)
- **Command:** `pytest tests/e2e -v`
- **Options:** the boards' saved tx_power (5 dBm or less), GATELINK_KEY set
- **Commit:** `d0a71983c0`, firmware tree `430bcbeca7`
- **Boards:** house 0.17.0 (…183013, COM5), gate 0.17.0 (…0C301C, COM21)
- **Results:** 67 passed
- **Counts for:** full_suite
- **Facts:**
  - consoles: house USB COM5 + UART tap COM17, gate USB COM21 + UART tap COM12
  - controller power: wired (in2_invert fakes a loss)
  - key id: 16b5da85
  - firmware: 0.17.0
  - config store: house spi, gate spi
  - free_ram after hist.get and config.get (house): 1587 B
  - free_ram after hist.get and config.get (gate): 1587 B
  - ping RTT: 153 ms
  - RSSI/SNR at house: -46 dBm / 7.75 dB
  - RSSI/SNR at gate: -46 dBm / 8 dB
  - controller SW mode: follows the SW level
  - noise floor (house / gate): -106 / -109.75 dBm
- **Anomalies:** none

### 20261014-080901

- **When:** 2026-10-14 08:08 to 08:17 -0500 (8 min)
- **Command:** `pytest tests/e2e -m soak --cycles 20 -v`
- **Options:** the boards' saved tx_power (5 dBm or less), --cycles 20, GATELINK_KEY set
- **Commit:** `d0a71983c0`, firmware tree `430bcbeca7`
- **Boards:** house 0.17.0 (…183013, COM5), gate 0.17.0 (…0C301C, COM21)
- **Results:** 1 passed
- **Counts for:** soak
- **Facts:**
  - consoles: house USB COM5 + UART tap COM17, gate USB COM21 + UART tap COM12
  - controller power: wired (in2_invert fakes a loss)
- **Anomalies:** none

### 20261014-081726

- **When:** 2026-10-14 08:17 to 08:28 -0500 (11 min)
- **Command:** `pytest tests/e2e -m power -v`
- **Options:** the boards' saved tx_power (5 dBm or less), GATELINK_KEY set
- **Commit:** `d0a71983c0`, firmware tree `430bcbeca7`
- **Boards:** house 0.17.0 (…183013, COM5), gate 0.17.0 (…0C301C, COM21)
- **Results:** 24 passed, 6 skipped
  - skipped: `test_gate_supply_cut_rides_through` (needs the gate LiPo plugged in)
  - skipped: `test_ac_loss_board_on_ac_supply` (needs the gate LiPo plugged in)
  - skipped: `test_opener_dead_board_on_accessory_supply` (needs the gate LiPo plugged in)
  - skipped: `test_house_supply_cut_rides_through` (needs the house LiPo plugged in)
  - skipped: `test_house_supply_dips_ride_through` (needs the house LiPo plugged in)
  - skipped: `test_both_supplies_cut_ride_through` (needs the gate LiPo plugged in)
- **Counts for:** power_lipo_out
- **Facts:**
  - consoles: house USB COM5 + UART tap COM17, gate USB COM21 + UART tap COM12
  - controller power: wired (in2_invert fakes a loss)
  - LiPos: gate out, house out
- **Anomalies:** none

### 20261014-205704

- **When:** 2026-10-14 20:57 to 21:57 -0500 (61 min)
- **Command:** `pytest tests/e2e -m longsoak --soak-minutes 60 -v`
- **Options:** the boards' saved tx_power (5 dBm or less), --soak-minutes 60.0, GATELINK_KEY set
- **Commit:** `84e2ef3bd9`, firmware tree `430bcbeca7`
- **Boards:** house 0.17.0 (…183013, COM5), gate 0.17.0 (…0C301C, COM21)
- **Results:** 1 passed
- **Counts for:** longsoak_60m
- **Facts:**
  - consoles: house USB COM5 + UART tap COM17, gate USB COM21 + UART tap COM12
  - controller power: wired (in2_invert fakes a loss)
  - long soak: 168 scenarios in 60 min, counters in soak_counters.csv
- **Anomalies:** none

### 20261014-230651

- **When:** 2026-10-14 23:06 to 23:10 -0500 (4 min)
- **Command:** `pytest tests/e2e -m power -v`
- **Options:** the boards' saved tx_power (5 dBm or less), GATELINK_KEY set
- **Commit:** `9a053cc3de`, firmware tree `430bcbeca7`
- **Boards:** house 0.17.0 (…183013, COM5), gate 0.17.0 (…0C301C, COM21)
- **Results:** 6 passed, 24 skipped
  - skipped: `test_gate_power_cut_at_rest` (needs the gate LiPo out)
  - skipped: `test_gate_power_cut_beyond_link_timeout` (needs the gate LiPo out)
  - skipped: `test_gate_power_cut_mid_pulse` (needs the gate LiPo out)
  - skipped: `test_gate_power_bounce` (needs the gate LiPo out)
  - skipped: `test_gate_power_cut_during_config_save[450]` (needs the gate LiPo out)
  - skipped: `test_gate_power_cut_during_config_save[400]` (needs the gate LiPo out)
  - skipped: `test_gate_power_cut_during_config_save[350]` (needs the gate LiPo out)
  - skipped: `test_gate_power_cut_during_config_save[300]` (needs the gate LiPo out)
  - skipped: `test_gate_power_cut_during_config_save[150]` (needs the gate LiPo out)
  - skipped: `test_gate_power_cut_during_config_save[0]` (needs the gate LiPo out)
  - skipped: `test_gate_power_cut_keeps_history` (needs the gate LiPo out)
  - skipped: `test_gate_unpowered_opener_moved_by_hand[back_mid_travel]` (needs the gate LiPo out)
  - skipped: `test_gate_unpowered_opener_moved_by_hand[beyond_link_timeout]` (needs the gate LiPo out)
  - skipped: `test_ac_loss_board_on_ac_supply_no_lipo` (needs the gate LiPo out)
  - skipped: `test_house_power_cut_with_command_pending` (needs the house LiPo out)
  - skipped: `test_house_power_cut_during_config_save[-40]` (needs the house LiPo out)
  - skipped: `test_house_power_cut_during_config_save[0]` (needs the house LiPo out)
  - skipped: `test_house_power_cut_during_config_save[40]` (needs the house LiPo out)
  - skipped: `test_house_power_cut_during_config_save[80]` (needs the house LiPo out)
  - skipped: `test_house_power_cut_during_config_save[150]` (needs the house LiPo out)
  - skipped: `test_house_power_cut_during_config_save[300]` (needs the house LiPo out)
  - skipped: `test_house_power_cut_gate_open` (needs the house LiPo out)
  - skipped: `test_house_supply_dips` (needs the house LiPo out)
  - skipped: `test_both_sites_power_cut` (needs the gate LiPo out)
- **Counts for:** power_lipo_in
- **Facts:**
  - consoles: house USB COM5 + UART tap COM17, gate USB COM21 + UART tap COM12
  - controller power: wired (in2_invert fakes a loss)
  - LiPos: gate in, house in
- **Anomalies:** none

### 20261014-231116

- **When:** 2026-10-14 23:11 to 23:30 -0500 (20 min)
- **Command:** `pytest tests/e2e -v --tx-power 17`
- **Options:** tx_power 17 dBm (--tx-power), GATELINK_KEY set
- **Commit:** `9a053cc3de`, firmware tree `430bcbeca7`
- **Boards:** house 0.17.0 (…183013, COM5), gate 0.17.0 (…0C301C, COM21)
- **Results:** 66 passed, 1 failed
  - failed: `test_history_outage` (AssertionError: gate down_s 0)
- **Counts for:** full_suite_17dbm
- **Facts:**
  - consoles: house USB COM5 + UART tap COM17, gate USB COM21 + UART tap COM12
  - controller power: wired (in2_invert fakes a loss)
  - key id: 16b5da85
  - firmware: 0.17.0
  - config store: house spi, gate spi
  - tx_power: 17 dBm (--tx-power)
  - free_ram after hist.get and config.get (house): 1587 B
  - free_ram after hist.get and config.get (gate): 1587 B
  - ping RTT: 153 ms
  - RSSI/SNR at house: -36 dBm / 8.25 dB
  - RSSI/SNR at gate: -36 dBm / 8 dB
  - controller SW mode: follows the SW level
  - noise floor (house / gate): -106.25 / -107 dBm
- **Anomalies:** none

### 20261014-233421

- **When:** 2026-10-14 23:34 to 23:34 -0500 (1 min)
- **Command:** `pytest tests/e2e -k test_history_outage -v --tx-power 17`
- **Options:** tx_power 17 dBm (--tx-power), GATELINK_KEY set
- **Commit:** `9a053cc3de`, firmware tree `430bcbeca7`
- **Boards:** house 0.17.0 (…183013, COM5), gate 0.17.0 (…0C301C, COM21)
- **Results:** 1 passed
- **Counts for:** full_suite_17dbm
- **Facts:**
  - consoles: house USB COM5 + UART tap COM17, gate USB COM21 + UART tap COM12
  - controller power: wired (in2_invert fakes a loss)
- **Anomalies:** none

### Not counted

| Run | Why |
|---|---|
| 20261014-074709 | local changes in tests/e2e/README.md, tests/e2e/test_link_faults.py |

## Install notes

<!-- notes:start -->
Hand-written, and kept when the file is collected again: anything a reviewer should know.
<!-- notes:end -->

<!-- release-evidence
{
 "version": "0.17.0",
 "kind": "minor",
 "previous": "0.15.2",
 "commit": "9a053cc3def988b54de4d3dd30fedfe13e259952",
 "firmware_tree": "430bcbeca7eb76a452f2b256b55205bad5178717",
 "collected": "2026-10-14T23:35:22-05:00",
 "schema": 1,
 "criteria": [
  {
   "id": "ci",
   "title": "CI green on the release commit (all jobs)",
   "required_for": "patch",
   "required": true,
   "manual": false,
   "met": true,
   "evidence": "[ci.yml run](https://github.com/ccirone2/LoRa-GateLink/actions/runs/38679564495): success (static success, firmware success, coverage success, web success, python success, workflows success)",
   "runs": []
  },
  {
   "id": "full_suite",
   "title": "Full suite: default selection, GATELINK_KEY set, the bench's own tx_power",
   "required_for": "patch",
   "required": true,
   "manual": false,
   "met": true,
   "evidence": "run 20261014-074854: 67 passed",
   "runs": [
    "20261014-074854"
   ]
  },
  {
   "id": "soak",
   "title": "Soak: -m soak, at least 20 cycles",
   "required_for": "patch",
   "required": true,
   "manual": false,
   "met": true,
   "evidence": "run 20261014-080901: 1 passed",
   "runs": [
    "20261014-080901"
   ]
  },
  {
   "id": "power_lipo_out",
   "title": "Power: -m power with both LiPos out",
   "required_for": "minor",
   "required": true,
   "manual": false,
   "met": true,
   "evidence": "run 20261014-081726: 24 passed, 6 skipped",
   "runs": [
    "20261014-081726"
   ]
  },
  {
   "id": "power_lipo_in",
   "title": "Power: -m power with both LiPos in",
   "required_for": "minor",
   "required": true,
   "manual": false,
   "met": true,
   "evidence": "run 20261014-230651: 6 passed, 24 skipped",
   "runs": [
    "20261014-230651"
   ]
  },
  {
   "id": "longsoak_60m",
   "title": "Long soak: -m longsoak, at least 60 min",
   "required_for": "minor",
   "required": true,
   "manual": false,
   "met": true,
   "evidence": "run 20261014-205704: 1 passed",
   "runs": [
    "20261014-205704"
   ]
  },
  {
   "id": "full_suite_17dbm",
   "title": "Full suite at --tx-power 17 on the install-like supplies",
   "required_for": "minor",
   "required": true,
   "manual": false,
   "met": true,
   "evidence": "run 20261014-231116: 66 passed, 1 failed; `test_history_outage` failed (AssertionError: gate down_s 0); passed its one rerun 20261014-233421",
   "runs": [
    "20261014-231116",
    "20261014-233421"
   ]
  },
  {
   "id": "longsoak_24h",
   "title": "Long soak: -m longsoak, at least 24 h",
   "required_for": "major",
   "required": false,
   "manual": false,
   "met": false,
   "evidence": "no run yet: `pytest tests/e2e -m longsoak --soak-minutes 1440`; other runs of its tests: 20261014-205704",
   "runs": []
  },
  {
   "id": "install_rf",
   "title": "Real RF at the install site (TODO.md: Real RF)",
   "required_for": "major",
   "required": false,
   "manual": true,
   "met": false,
   "evidence": "not ticked in the install notes (`- [x] install_rf: <what was done, when, numbers\u003e`)",
   "runs": []
  },
  {
   "id": "install_full_power",
   "title": "Full power at the install for days (TODO.md: Full power at the install)",
   "required_for": "major",
   "required": false,
   "manual": true,
   "met": false,
   "evidence": "not ticked in the install notes (`- [x] install_full_power: <what was done, when, numbers\u003e`)",
   "runs": []
  }
 ],
 "reruns": [
  {
   "run": "20261014-231116",
   "test": "test_history.py::test_history_outage",
   "reason": "AssertionError: gate down_s 0",
   "rerun": "20261014-233421"
  }
 ],
 "runs": [
  {
   "run": "20261014-074854",
   "start": "2026-10-14T07:48:51-05:00",
   "end": "2026-10-14T08:08:30-05:00",
   "minutes": 19.6,
   "command": "pytest tests/e2e -v",
   "selection": {
    "markexpr": "not soak and not longsoak and not rf and not power",
    "keyword": "",
    "paths": [
     "tests/e2e"
    ]
   },
   "commit": "d0a71983c095778849f06efad93d05f1da4a121a",
   "firmware_tree": "430bcbeca7eb76a452f2b256b55205bad5178717",
   "dirty_paths": [],
   "boards": {
    "gate": {
     "fw": "0.17.0",
     "usb_serial": "B86085DB5031344E432E3120FF0C301C",
     "port": "COM21",
     "cfg_store": "spi",
     "flash_id": "ef4015"
    },
    "house": {
     "fw": "0.17.0",
     "usb_serial": "066322EE5030534D4D2E3120FF183013",
     "port": "COM5",
     "cfg_store": "spi",
     "flash_id": "ef4015"
    }
   },
   "options": {
    "tx_power": null,
    "cycles": 20,
    "soak_minutes": 120,
    "rf_cycles": 5,
    "gatelink_key": true,
    "ha_power_entity": null,
    "no_uart": false
   },
   "counts": {
    "passed": 67
   },
   "counts_for": [
    "full_suite"
   ],
   "failed": [],
   "skipped": [],
   "latencies": [
    {
     "name": "controller edge -\u003e power sense drop (must be < ctrl_confirm_ms)",
     "n": 1,
     "min": 0.1110000000000042,
     "median": 0.1110000000000042,
     "max": 0.1110000000000042
    },
    {
     "name": "outage -\u003e house link_down",
     "n": 1,
     "min": 11.680254100151387,
     "median": 11.680254100151387,
     "max": 11.680254100151387
    },
    {
     "name": "link restored -\u003e house link_up",
     "n": 1,
     "min": 5.026806500006444,
     "median": 5.026806500006444,
     "max": 5.026806500006444
    },
    {
     "name": "cmd_sent -\u003e cmd_dropped (dead link)",
     "n": 1,
     "min": 9.98599999999999,
     "median": 9.98599999999999,
     "max": 9.98599999999999
    },
    {
     "name": "cmd_sent -\u003e gate cmd_rx (after short outage)",
     "n": 1,
     "min": 2.680999999999983,
     "median": 2.680999999999983,
     "max": 2.680999999999983
    },
    {
     "name": "cmd_sent -\u003e gate cmd_rx (after 4 s outage)",
     "n": 1,
     "min": 5.317000000000007,
     "median": 5.317000000000007,
     "max": 5.317000000000007
    },
    {
     "name": "link restored -\u003e house learns missed move",
     "n": 1,
     "min": 4.667963899791232,
     "median": 4.667963899791232,
     "max": 4.667963899791232
    },
    {
     "name": "link restored -\u003e house shows the hidden move",
     "n": 1,
     "min": 4.657624899856728,
     "median": 4.657624899856728,
     "max": 4.657624899856728
    },
    {
     "name": "missed move: K2 open (polled)",
     "n": 1,
     "min": 5.194223199989665,
     "median": 5.194223199989665,
     "max": 5.194223199989665
    },
    {
     "name": "replayed HELLO -\u003e held command released",
     "n": 1,
     "min": 1.6289999999999623,
     "median": 1.6289999999999623,
     "max": 1.6289999999999623
    },
    {
     "name": "controller -\u003e house cmd_sent",
     "n": 2,
     "min": 0.32395740008723806,
     "median": 0.32622170004253803,
     "max": 0.32622170004253803
    },
    {
     "name": "cmd_sent -\u003e gate pulse (LoRa)",
     "n": 2,
     "min": 0.014999999999986358,
     "median": 0.21699999999998454,
     "max": 0.21699999999998454
    },
    {
     "name": "gate pulse -\u003e opener moving",
     "n": 2,
     "min": 0.06200000000001182,
     "median": 0.12399999999990996,
     "max": 0.12399999999990996
    },
    {
     "name": "gate state -\u003e house state (LoRa)",
     "n": 2,
     "min": 0.047000000000025466,
     "median": 0.09299999999996089,
     "max": 0.09299999999996089
    },
    {
     "name": "controller -\u003e house shows open (incl. 8s travel)",
     "n": 1,
     "min": 8.664957400087246,
     "median": 8.664957400087246,
     "max": 8.664957400087246
    },
    {
     "name": "controller -\u003e house shows closed (incl. 8s travel)",
     "n": 1,
     "min": 8.528221700042536,
     "median": 8.528221700042536,
     "max": 8.528221700042536
    },
    {
     "name": "command -\u003e travel timeout reported",
     "n": 1,
     "min": 15.125,
     "median": 15.125,
     "max": 15.125
    },
    {
     "name": "travel timeout -\u003e house resync",
     "n": 1,
     "min": 0.20199999999999818,
     "median": 0.20199999999999818,
     "max": 0.20199999999999818
    },
    {
     "name": "gate reboot -\u003e session re-established",
     "n": 1,
     "min": 3.1551577001810074,
     "median": 3.1551577001810074,
     "max": 3.1551577001810074
    },
    {
     "name": "house reboot -\u003e controller resynced",
     "n": 1,
     "min": 13.976500999648124,
     "median": 13.976500999648124,
     "max": 13.976500999648124
    }
   ],
   "facts": {
    "consoles": "house USB COM5 + UART tap COM17, gate USB COM21 + UART tap COM12",
    "controller power": "wired (in2_invert fakes a loss)",
    "key id": "16b5da85",
    "firmware": "0.17.0",
    "config store": "house spi, gate spi",
    "free_ram after hist.get and config.get (house)": "1587 B",
    "free_ram after hist.get and config.get (gate)": "1587 B",
    "ping RTT": "153 ms",
    "RSSI/SNR at house": "-46 dBm / 7.75 dB",
    "RSSI/SNR at gate": "-46 dBm / 8 dB",
    "controller SW mode": "follows the SW level",
    "noise floor (house / gate)": "-106 / -109.75 dBm"
   },
   "anomalies": []
  },
  {
   "run": "20261014-080901",
   "start": "2026-10-14T08:08:58-05:00",
   "end": "2026-10-14T08:17:05-05:00",
   "minutes": 8.1,
   "command": "pytest tests/e2e -m soak --cycles 20 -v",
   "selection": {
    "markexpr": "soak",
    "keyword": "",
    "paths": [
     "tests/e2e"
    ]
   },
   "commit": "d0a71983c095778849f06efad93d05f1da4a121a",
   "firmware_tree": "430bcbeca7eb76a452f2b256b55205bad5178717",
   "dirty_paths": [],
   "boards": {
    "gate": {
     "fw": "0.17.0",
     "usb_serial": "B86085DB5031344E432E3120FF0C301C",
     "port": "COM21",
     "cfg_store": "spi",
     "flash_id": "ef4015"
    },
    "house": {
     "fw": "0.17.0",
     "usb_serial": "066322EE5030534D4D2E3120FF183013",
     "port": "COM5",
     "cfg_store": "spi",
     "flash_id": "ef4015"
    }
   },
   "options": {
    "tx_power": null,
    "cycles": 20,
    "soak_minutes": 120,
    "rf_cycles": 5,
    "gatelink_key": true,
    "ha_power_entity": null,
    "no_uart": false
   },
   "counts": {
    "passed": 1
   },
   "counts_for": [
    "soak"
   ],
   "failed": [],
   "skipped": [],
   "latencies": [
    {
     "name": "controller -\u003e house cmd_sent",
     "n": 40,
     "min": 0.20108669992163186,
     "median": 0.3112131996974341,
     "max": 0.3271462997756771
    },
    {
     "name": "cmd_sent -\u003e gate pulse (LoRa)",
     "n": 40,
     "min": 0.014000000000010004,
     "median": 0.045000000000001705,
     "max": 0.14000000000000057
    },
    {
     "name": "gate pulse -\u003e opener moving",
     "n": 40,
     "min": 0.03100000000000591,
     "median": 0.12299999999999045,
     "max": 0.1400000000000432
    },
    {
     "name": "gate state -\u003e house state (LoRa)",
     "n": 40,
     "min": 0.03100000000000591,
     "median": 0.07499999999998863,
     "max": 0.11100000000001842
    },
    {
     "name": "controller -\u003e house shows open (incl. 8s travel)",
     "n": 20,
     "min": 8.426294899739332,
     "median": 8.533433899804947,
     "max": 8.559630399953562
    },
    {
     "name": "controller -\u003e house shows closed (incl. 8s travel)",
     "n": 20,
     "min": 8.421531600013374,
     "median": 8.534571899943046,
     "max": 8.553696599826196
    }
   ],
   "facts": {
    "consoles": "house USB COM5 + UART tap COM17, gate USB COM21 + UART tap COM12",
    "controller power": "wired (in2_invert fakes a loss)"
   },
   "anomalies": []
  },
  {
   "run": "20261014-081726",
   "start": "2026-10-14T08:17:23-05:00",
   "end": "2026-10-14T08:28:06-05:00",
   "minutes": 10.7,
   "command": "pytest tests/e2e -m power -v",
   "selection": {
    "markexpr": "power",
    "keyword": "",
    "paths": [
     "tests/e2e"
    ]
   },
   "commit": "d0a71983c095778849f06efad93d05f1da4a121a",
   "firmware_tree": "430bcbeca7eb76a452f2b256b55205bad5178717",
   "dirty_paths": [],
   "boards": {
    "gate": {
     "fw": "0.17.0",
     "usb_serial": "B86085DB5031344E432E3120FF0C301C",
     "port": "COM21",
     "cfg_store": "spi",
     "flash_id": "ef4015"
    },
    "house": {
     "fw": "0.17.0",
     "usb_serial": "066322EE5030534D4D2E3120FF183013",
     "port": "COM5",
     "cfg_store": "spi",
     "flash_id": "ef4015"
    }
   },
   "options": {
    "tx_power": null,
    "cycles": 20,
    "soak_minutes": 120,
    "rf_cycles": 5,
    "gatelink_key": true,
    "ha_power_entity": null,
    "no_uart": false
   },
   "counts": {
    "passed": 24,
    "skipped": 6
   },
   "counts_for": [
    "power_lipo_out"
   ],
   "failed": [],
   "skipped": [
    {
     "test": "test_power.py::test_gate_supply_cut_rides_through",
     "reason": "needs the gate LiPo plugged in"
    },
    {
     "test": "test_power.py::test_ac_loss_board_on_ac_supply",
     "reason": "needs the gate LiPo plugged in"
    },
    {
     "test": "test_power.py::test_opener_dead_board_on_accessory_supply",
     "reason": "needs the gate LiPo plugged in"
    },
    {
     "test": "test_power.py::test_house_supply_cut_rides_through",
     "reason": "needs the house LiPo plugged in"
    },
    {
     "test": "test_power.py::test_house_supply_dips_ride_through",
     "reason": "needs the house LiPo plugged in"
    },
    {
     "test": "test_power.py::test_both_supplies_cut_ride_through",
     "reason": "needs the gate LiPo plugged in"
    }
   ],
   "latencies": [],
   "facts": {
    "consoles": "house USB COM5 + UART tap COM17, gate USB COM21 + UART tap COM12",
    "controller power": "wired (in2_invert fakes a loss)",
    "LiPos": "gate out, house out"
   },
   "anomalies": []
  },
  {
   "run": "20261014-205704",
   "start": "2026-10-14T20:57:02-05:00",
   "end": "2026-10-14T21:57:36-05:00",
   "minutes": 60.6,
   "command": "pytest tests/e2e -m longsoak --soak-minutes 60 -v",
   "selection": {
    "markexpr": "longsoak",
    "keyword": "",
    "paths": [
     "tests/e2e"
    ]
   },
   "commit": "84e2ef3bd9a1b41775fc79d318a5a807aca6c810",
   "firmware_tree": "430bcbeca7eb76a452f2b256b55205bad5178717",
   "dirty_paths": [],
   "boards": {
    "gate": {
     "fw": "0.17.0",
     "usb_serial": "B86085DB5031344E432E3120FF0C301C",
     "port": "COM21",
     "cfg_store": "spi",
     "flash_id": "ef4015"
    },
    "house": {
     "fw": "0.17.0",
     "usb_serial": "066322EE5030534D4D2E3120FF183013",
     "port": "COM5",
     "cfg_store": "spi",
     "flash_id": "ef4015"
    }
   },
   "options": {
    "tx_power": null,
    "cycles": 20,
    "soak_minutes": 60.0,
    "rf_cycles": 5,
    "gatelink_key": true,
    "ha_power_entity": null,
    "no_uart": false
   },
   "counts": {
    "passed": 1
   },
   "counts_for": [
    "longsoak_60m"
   ],
   "failed": [],
   "skipped": [],
   "latencies": [
    {
     "name": "controller -\u003e house cmd_sent",
     "n": 168,
     "min": 0.26171469987184537,
     "median": 0.32317039999367125,
     "max": 0.43343929970274075
    },
    {
     "name": "cmd_sent -\u003e gate pulse (LoRa)",
     "n": 168,
     "min": 0.01499999999987267,
     "median": 0.03199999999992542,
     "max": 0.14099999999984902
    },
    {
     "name": "gate pulse -\u003e opener moving",
     "n": 168,
     "min": 0.02999999999974534,
     "median": 0.12199999999995725,
     "max": 0.1390000000001237
    },
    {
     "name": "gate state -\u003e house state (LoRa)",
     "n": 168,
     "min": 0.03099999999994907,
     "median": 0.07300000000032014,
     "max": 0.3709999999998672
    },
    {
     "name": "controller -\u003e house shows open (incl. 8s travel)",
     "n": 84,
     "min": 8.50968680009246,
     "median": 8.53713469964623,
     "max": 8.848208499863631
    },
    {
     "name": "controller -\u003e house shows closed (incl. 8s travel)",
     "n": 84,
     "min": 8.51014799999075,
     "median": 8.537028799660504,
     "max": 8.613439299702577
    }
   ],
   "facts": {
    "consoles": "house USB COM5 + UART tap COM17, gate USB COM21 + UART tap COM12",
    "controller power": "wired (in2_invert fakes a loss)",
    "long soak": "168 scenarios in 60 min, counters in soak_counters.csv"
   },
   "anomalies": []
  },
  {
   "run": "20261014-230651",
   "start": "2026-10-14T23:06:48-05:00",
   "end": "2026-10-14T23:10:53-05:00",
   "minutes": 4.1,
   "command": "pytest tests/e2e -m power -v",
   "selection": {
    "markexpr": "power",
    "keyword": "",
    "paths": [
     "tests/e2e"
    ]
   },
   "commit": "9a053cc3def988b54de4d3dd30fedfe13e259952",
   "firmware_tree": "430bcbeca7eb76a452f2b256b55205bad5178717",
   "dirty_paths": [],
   "boards": {
    "gate": {
     "fw": "0.17.0",
     "usb_serial": "B86085DB5031344E432E3120FF0C301C",
     "port": "COM21",
     "cfg_store": "spi",
     "flash_id": "ef4015"
    },
    "house": {
     "fw": "0.17.0",
     "usb_serial": "066322EE5030534D4D2E3120FF183013",
     "port": "COM5",
     "cfg_store": "spi",
     "flash_id": "ef4015"
    }
   },
   "options": {
    "tx_power": null,
    "cycles": 20,
    "soak_minutes": 120,
    "rf_cycles": 5,
    "gatelink_key": true,
    "ha_power_entity": null,
    "no_uart": false
   },
   "counts": {
    "skipped": 24,
    "passed": 6
   },
   "counts_for": [
    "power_lipo_in"
   ],
   "failed": [],
   "skipped": [
    {
     "test": "test_power.py::test_gate_power_cut_at_rest",
     "reason": "needs the gate LiPo out"
    },
    {
     "test": "test_power.py::test_gate_power_cut_beyond_link_timeout",
     "reason": "needs the gate LiPo out"
    },
    {
     "test": "test_power.py::test_gate_power_cut_mid_pulse",
     "reason": "needs the gate LiPo out"
    },
    {
     "test": "test_power.py::test_gate_power_bounce",
     "reason": "needs the gate LiPo out"
    },
    {
     "test": "test_power.py::test_gate_power_cut_during_config_save[450]",
     "reason": "needs the gate LiPo out"
    },
    {
     "test": "test_power.py::test_gate_power_cut_during_config_save[400]",
     "reason": "needs the gate LiPo out"
    },
    {
     "test": "test_power.py::test_gate_power_cut_during_config_save[350]",
     "reason": "needs the gate LiPo out"
    },
    {
     "test": "test_power.py::test_gate_power_cut_during_config_save[300]",
     "reason": "needs the gate LiPo out"
    },
    {
     "test": "test_power.py::test_gate_power_cut_during_config_save[150]",
     "reason": "needs the gate LiPo out"
    },
    {
     "test": "test_power.py::test_gate_power_cut_during_config_save[0]",
     "reason": "needs the gate LiPo out"
    },
    {
     "test": "test_power.py::test_gate_power_cut_keeps_history",
     "reason": "needs the gate LiPo out"
    },
    {
     "test": "test_power.py::test_gate_unpowered_opener_moved_by_hand[back_mid_travel]",
     "reason": "needs the gate LiPo out"
    },
    {
     "test": "test_power.py::test_gate_unpowered_opener_moved_by_hand[beyond_link_timeout]",
     "reason": "needs the gate LiPo out"
    },
    {
     "test": "test_power.py::test_ac_loss_board_on_ac_supply_no_lipo",
     "reason": "needs the gate LiPo out"
    },
    {
     "test": "test_power.py::test_house_power_cut_with_command_pending",
     "reason": "needs the house LiPo out"
    },
    {
     "test": "test_power.py::test_house_power_cut_during_config_save[-40]",
     "reason": "needs the house LiPo out"
    },
    {
     "test": "test_power.py::test_house_power_cut_during_config_save[0]",
     "reason": "needs the house LiPo out"
    },
    {
     "test": "test_power.py::test_house_power_cut_during_config_save[40]",
     "reason": "needs the house LiPo out"
    },
    {
     "test": "test_power.py::test_house_power_cut_during_config_save[80]",
     "reason": "needs the house LiPo out"
    },
    {
     "test": "test_power.py::test_house_power_cut_during_config_save[150]",
     "reason": "needs the house LiPo out"
    },
    {
     "test": "test_power.py::test_house_power_cut_during_config_save[300]",
     "reason": "needs the house LiPo out"
    },
    {
     "test": "test_power.py::test_house_power_cut_gate_open",
     "reason": "needs the house LiPo out"
    },
    {
     "test": "test_power.py::test_house_supply_dips",
     "reason": "needs the house LiPo out"
    },
    {
     "test": "test_power.py::test_both_sites_power_cut",
     "reason": "needs the gate LiPo out"
    }
   ],
   "latencies": [],
   "facts": {
    "consoles": "house USB COM5 + UART tap COM17, gate USB COM21 + UART tap COM12",
    "controller power": "wired (in2_invert fakes a loss)",
    "LiPos": "gate in, house in"
   },
   "anomalies": []
  },
  {
   "run": "20261014-231116",
   "start": "2026-10-14T23:11:13-05:00",
   "end": "2026-10-14T23:30:57-05:00",
   "minutes": 19.7,
   "command": "pytest tests/e2e -v --tx-power 17",
   "selection": {
    "markexpr": "not soak and not longsoak and not rf and not power",
    "keyword": "",
    "paths": [
     "tests/e2e"
    ]
   },
   "commit": "9a053cc3def988b54de4d3dd30fedfe13e259952",
   "firmware_tree": "430bcbeca7eb76a452f2b256b55205bad5178717",
   "dirty_paths": [],
   "boards": {
    "gate": {
     "fw": "0.17.0",
     "usb_serial": "B86085DB5031344E432E3120FF0C301C",
     "port": "COM21",
     "cfg_store": "spi",
     "flash_id": "ef4015"
    },
    "house": {
     "fw": "0.17.0",
     "usb_serial": "066322EE5030534D4D2E3120FF183013",
     "port": "COM5",
     "cfg_store": "spi",
     "flash_id": "ef4015"
    }
   },
   "options": {
    "tx_power": 17,
    "cycles": 20,
    "soak_minutes": 120,
    "rf_cycles": 5,
    "gatelink_key": true,
    "ha_power_entity": null,
    "no_uart": false
   },
   "counts": {
    "passed": 66,
    "failed": 1
   },
   "counts_for": [
    "full_suite_17dbm"
   ],
   "failed": [
    {
     "test": "test_history.py::test_history_outage",
     "reason": "AssertionError: gate down_s 0"
    }
   ],
   "skipped": [],
   "latencies": [
    {
     "name": "controller edge -\u003e power sense drop (must be < ctrl_confirm_ms)",
     "n": 1,
     "min": 0.10900000000000176,
     "median": 0.10900000000000176,
     "max": 0.10900000000000176
    },
    {
     "name": "outage -\u003e house link_down",
     "n": 1,
     "min": 11.59514449987563,
     "median": 11.59514449987563,
     "max": 11.59514449987563
    },
    {
     "name": "link restored -\u003e house link_up",
     "n": 1,
     "min": 4.557061100069461,
     "median": 4.557061100069461,
     "max": 4.557061100069461
    },
    {
     "name": "cmd_sent -\u003e cmd_dropped (dead link)",
     "n": 1,
     "min": 9.96999999999997,
     "median": 9.96999999999997,
     "max": 9.96999999999997
    },
    {
     "name": "cmd_sent -\u003e gate cmd_rx (after short outage)",
     "n": 1,
     "min": 2.647000000000048,
     "median": 2.647000000000048,
     "max": 2.647000000000048
    },
    {
     "name": "cmd_sent -\u003e gate cmd_rx (after 4 s outage)",
     "n": 1,
     "min": 5.13900000000001,
     "median": 5.13900000000001,
     "max": 5.13900000000001
    },
    {
     "name": "link restored -\u003e house learns missed move",
     "n": 1,
     "min": 4.655743700176458,
     "median": 4.655743700176458,
     "max": 4.655743700176458
    },
    {
     "name": "link restored -\u003e house shows the hidden move",
     "n": 1,
     "min": 4.6831230999380296,
     "median": 4.6831230999380296,
     "max": 4.6831230999380296
    },
    {
     "name": "missed move: K2 open (polled)",
     "n": 1,
     "min": 5.214693099871283,
     "median": 5.214693099871283,
     "max": 5.214693099871283
    },
    {
     "name": "replayed HELLO -\u003e held command released",
     "n": 1,
     "min": 1.728999999999985,
     "median": 1.728999999999985,
     "max": 1.728999999999985
    },
    {
     "name": "controller -\u003e house cmd_sent",
     "n": 2,
     "min": 0.29277479992811095,
     "median": 0.32277929990743814,
     "max": 0.32277929990743814
    },
    {
     "name": "cmd_sent -\u003e gate pulse (LoRa)",
     "n": 2,
     "min": 0.04499999999995907,
     "median": 0.34199999999998454,
     "max": 0.34199999999998454
    },
    {
     "name": "gate pulse -\u003e opener moving",
     "n": 2,
     "min": 0.06299999999998818,
     "median": 0.125,
     "max": 0.125
    },
    {
     "name": "gate state -\u003e house state (LoRa)",
     "n": 2,
     "min": 0.09300000000007458,
     "median": 0.1169999999999618,
     "max": 0.1169999999999618
    },
    {
     "name": "controller -\u003e house shows open (incl. 8s travel)",
     "n": 1,
     "min": 8.790779299907399,
     "median": 8.790779299907399,
     "max": 8.790779299907399
    },
    {
     "name": "controller -\u003e house shows closed (incl. 8s travel)",
     "n": 1,
     "min": 8.533774799928096,
     "median": 8.533774799928096,
     "max": 8.533774799928096
    },
    {
     "name": "command -\u003e travel timeout reported",
     "n": 1,
     "min": 15.103000000000065,
     "median": 15.103000000000065,
     "max": 15.103000000000065
    },
    {
     "name": "travel timeout -\u003e house resync",
     "n": 1,
     "min": 0.23200000000008458,
     "median": 0.23200000000008458,
     "max": 0.23200000000008458
    },
    {
     "name": "gate reboot -\u003e session re-established",
     "n": 1,
     "min": 3.7589211999438703,
     "median": 3.7589211999438703,
     "max": 3.7589211999438703
    },
    {
     "name": "house reboot -\u003e controller resynced",
     "n": 1,
     "min": 13.266564299818128,
     "median": 13.266564299818128,
     "max": 13.266564299818128
    }
   ],
   "facts": {
    "consoles": "house USB COM5 + UART tap COM17, gate USB COM21 + UART tap COM12",
    "controller power": "wired (in2_invert fakes a loss)",
    "key id": "16b5da85",
    "firmware": "0.17.0",
    "config store": "house spi, gate spi",
    "tx_power": "17 dBm (--tx-power)",
    "free_ram after hist.get and config.get (house)": "1587 B",
    "free_ram after hist.get and config.get (gate)": "1587 B",
    "ping RTT": "153 ms",
    "RSSI/SNR at house": "-36 dBm / 8.25 dB",
    "RSSI/SNR at gate": "-36 dBm / 8 dB",
    "controller SW mode": "follows the SW level",
    "noise floor (house / gate)": "-106.25 / -107 dBm"
   },
   "anomalies": []
  },
  {
   "run": "20261014-233421",
   "start": "2026-10-14T23:34:18-05:00",
   "end": "2026-10-14T23:34:50-05:00",
   "minutes": 0.5,
   "command": "pytest tests/e2e -k test_history_outage -v --tx-power 17",
   "selection": {
    "markexpr": "not soak and not longsoak and not rf and not power",
    "keyword": "test_history_outage",
    "paths": [
     "tests/e2e"
    ]
   },
   "commit": "9a053cc3def988b54de4d3dd30fedfe13e259952",
   "firmware_tree": "430bcbeca7eb76a452f2b256b55205bad5178717",
   "dirty_paths": [],
   "boards": {
    "gate": {
     "fw": "0.17.0",
     "usb_serial": "B86085DB5031344E432E3120FF0C301C",
     "port": "COM21",
     "cfg_store": "spi",
     "flash_id": "ef4015"
    },
    "house": {
     "fw": "0.17.0",
     "usb_serial": "066322EE5030534D4D2E3120FF183013",
     "port": "COM5",
     "cfg_store": "spi",
     "flash_id": "ef4015"
    }
   },
   "options": {
    "tx_power": 17,
    "cycles": 20,
    "soak_minutes": 120,
    "rf_cycles": 5,
    "gatelink_key": true,
    "ha_power_entity": null,
    "no_uart": false
   },
   "counts": {
    "passed": 1
   },
   "counts_for": [
    "full_suite_17dbm"
   ],
   "failed": [],
   "skipped": [],
   "latencies": [],
   "facts": {
    "consoles": "house USB COM5 + UART tap COM17, gate USB COM21 + UART tap COM12",
    "controller power": "wired (in2_invert fakes a loss)"
   },
   "anomalies": []
  }
 ],
 "not_counted": [
  {
   "run": "20261014-074709",
   "why": [
    "local changes in tests/e2e/README.md, tests/e2e/test_link_faults.py"
   ]
  }
 ]
}
-->
