ccirone2/LoRa-GateLink/firmware/GateLink/config.cpp

#include "config.h"
#include "crc32.h"
#include "extflash.h"
#include "histlog.h"
#include "radio.h"
#include <FlashStorage.h>
#include <SHA256.h>

// Config is kept in the on-board SPI flash, which firmware uploads don't touch. It's stored as (param id,
// value) pairs plus the key, so a firmware with added, removed or reordered settings still loads every
// setting it knows (the rest take their defaults). PARAMS ids are therefore permanent: if a setting's
// meaning or units change, give it a new id. Only if the SPI flash doesn't answer does config fall back to
// program flash (FlashStorage, a struct image checked against CFG_VERSION), which every upload erases.

#define CFG_MAGIC 0x47544C4Bu  // "GTLK"
#define CFG_VERSION 7

const char FW_MARKER[] = FW_MARKER_PREFIX FW_VERSION;
Config cfg;
int32_t activeRole = ROLE_UNSET;
FlashStorage(cfgStore, Config);
static uint8_t source = CFG_DEFAULTS;
static int32_t dropped = 0;

const ParamDef PARAMS[] = {
  { 1, "role", &Config::role, 0, 2, P_REBOOT },
  { 2, "net_id", &Config::net_id, 0, 255, 0 },
  { 3, "freq_hz", &Config::freq_hz, 862000000, 928000000, P_RADIO },
  { 4, "sf", &Config::sf, 7, 12, P_RADIO },
  { 5, "bw_hz", &Config::bw_hz, 125000, 500000, P_RADIO },
  { 6, "cr", &Config::cr, 5, 8, P_RADIO },
  { 7, "tx_power", &Config::tx_power, 2, 20, P_RADIO },
  { 8, "sync_word", &Config::sync_word, 0, 255, P_RADIO },
  { 9, "retries", &Config::retries, 0, 10, P_REMOTE },
  { 10, "heartbeat_s", &Config::heartbeat_s, 5, 3600, P_REMOTE },
  { 11, "link_timeout_s", &Config::link_timeout_s, 15, 10800, P_REMOTE },
  { 12, "cmd_ttl_s", &Config::cmd_ttl_s, 2, 120, 0 },  // house only
  { 13, "debounce_ms", &Config::debounce_ms, 10, 1000, P_REMOTE },
  // Not remote: inverted, a dead opto or cut wire reads active (e.g. a closed limit). Keep at 0.
  { 14, "in1_invert", &Config::in1_invert, 0, 1, 0 },
  { 15, "in2_invert", &Config::in2_invert, 0, 1, 0 },
  { 16, "pulse_ms", &Config::pulse_ms, 100, 5000, P_REMOTE },
  { 17, "travel_timeout_s", &Config::travel_timeout_s, 5, 300, P_REMOTE },
  { 18, "ctrl_sync", &Config::ctrl_sync, 0, 1, 0 },
  { 19, "sync_window_ms", &Config::sync_window_ms, 500, 10000, 0 },
  { 20, "resync_ms", &Config::resync_ms, 200, 5000, 0 },
  { 21, "mismatch_timeout_s", &Config::mismatch_timeout_s, 10, 600, 0 },
  { 22, "sensor_invert", &Config::sensor_invert, 0, 1, 0 },
  { 23, "linkloss_open", &Config::linkloss_open, 0, 1, 0 },
  { 24, "in3_invert", &Config::in3_invert, 0, 1, 0 },
  { 25, "in4_invert", &Config::in4_invert, 0, 1, 0 },
  { 26, "power_sense", &Config::power_sense, 0, 1, P_REMOTE },
  { 27, "ctrl_power_sense", &Config::ctrl_power_sense, 0, 1, 0 },
  { 28, "ctrl_confirm_ms", &Config::ctrl_confirm_ms, 0, 5000, 0 },
  { 29, "ctrl_settle_ms", &Config::ctrl_settle_ms, 0, 60000, 0 },
  { 31, "ctrl_power_pmic", &Config::ctrl_power_pmic, 0, 1, 0 },
  { 30, "uart_console", &Config::uart_console, 0, 1, 0 },
  // Not remote: whether D5 drives anything is a decision about the install's wiring.
  { 32, "fault_out", &Config::fault_out, 0, 1, 0 },
  { 33, "fault_hold_s", &Config::fault_hold_s, 0, 600, P_REMOTE },
};
const size_t PARAM_COUNT = sizeof(PARAMS) / sizeof(PARAMS[0]);

// SPI flash record, written to one page of sector 0 or 1 alternately (the newer seq wins), so losing power
// mid-save leaves the previous record:
//   magic(4) fmt(1) count(1) seq(4) crc(4, over the rest) key(16) key_set(1) count x { id(1) value(4) }
#define REC_MAGIC 0x31434C47u  // "GLC1"
#define REC_FMT 1
#define REC_HDR 31
#define REC_MAX_PARAMS ((EXTFLASH_PAGE - REC_HDR) / 5)
#define REC_SECTORS 2
static_assert(sizeof(PARAMS) / sizeof(PARAMS[0]) <= REC_MAX_PARAMS, "config record outgrew one flash page");
// Flash access holds the radio module in reset, which resets the radio: it's re-initialised afterwards (about
// 0.5 s off the air, in LoRa.begin()'s reset delays). Saves are rare (console, remote writes, a history bucket).
FlashAccess::FlashAccess() {
  if (extFlashPresent()) extFlashHoldModem();
}

FlashAccess::~FlashAccess() {
  if (extFlashPresent()) radioRestart();
}
// Settings in the record that this firmware doesn't know (saved by a newer one, before a downgrade). Every save
// writes them back, so going back to the newer firmware finds them again, as many as fit the page after its own.
#define EXTRAS_MAX (REC_MAX_PARAMS - sizeof(PARAMS) / sizeof(PARAMS[0]))
struct Extras {
  uint8_t n;
  uint8_t id[EXTRAS_MAX];
  uint32_t value[EXTRAS_MAX];
};
// What reading the SPI flash found: the newest valid record's sector (-1 = none), its seq, its unknown settings,
// and how many settings it held that this firmware didn't accept.
struct SpiRecord {
  int8_t sector;
  uint32_t seq;
  int32_t skipped;
  Extras extras;
};
static int8_t spiSector = -1;  // sector holding the newest valid record (-1 = none)
static uint32_t spiSeq = 0;
static Extras extras;  // the newest record's

static uint32_t configCrc(const Config &c) {
  return crc32(&c, offsetof(Config, crc));
}

static void put32(uint8_t *p, uint32_t v) {
  for (int i = 0; i < 4; i++) p[i] = v >> (8 * i);
}

static uint32_t get32(const uint8_t *p) {
  return p[0] | (uint32_t)p[1] << 8 | (uint32_t)p[2] << 16 | (uint32_t)p[3] << 24;
}

static size_t encode(const Config &c, uint32_t seq, uint8_t *buf) {
  put32(buf, REC_MAGIC);
  buf[4] = REC_FMT;
  put32(buf + 6, seq);
  memcpy(buf + 14, c.key, 16);
  buf[30] = c.key_set ? 1 : 0;
  uint8_t *p = buf + REC_HDR;
  for (size_t i = 0; i < PARAM_COUNT; i++, p += 5) {
    p[0] = PARAMS[i].id;
    put32(p + 1, (uint32_t)(c.*(PARAMS[i].field)));
  }
  for (uint8_t i = 0; i < extras.n; i++, p += 5) {
    p[0] = extras.id[i];
    put32(p + 1, extras.value[i]);
  }
  buf[5] = (p - buf - REC_HDR) / 5;
  size_t len = p - buf;
  put32(buf + 10, crc32(buf + 14, len - 14));
  return len;
}

// Applies a record on top of c (which holds the defaults). Returns false if buf holds no valid record.
static bool decode(const uint8_t *buf, Config &c, uint32_t &seq, int32_t &skipped, Extras &x) {
  if (get32(buf) != REC_MAGIC || buf[4] != REC_FMT || buf[5] > REC_MAX_PARAMS) return false;
  size_t len = REC_HDR + 5 * buf[5];
  if (get32(buf + 10) != crc32(buf + 14, len - 14)) return false;
  seq = get32(buf + 6);
  memcpy(c.key, buf + 14, 16);
  c.key_set = buf[30] ? 1 : 0;
  skipped = 0;
  x.n = 0;
  for (const uint8_t *p = buf + REC_HDR; p < buf + len; p += 5) {
    const ParamDef *d = paramById(p[0]);
    int32_t v = (int32_t)get32(p + 1);
    if (d && paramValid(d, v)) {
      c.*(d->field) = v;
      continue;
    }
    skipped++;  // setting unknown here, or its range shrank (then it's dropped: this firmware saves its own value)
    if (!d && x.n < EXTRAS_MAX) {
      x.id[x.n] = p[0];
      x.value[x.n++] = v;
    }
  }
  return true;
}

// Loads the newest valid record from SPI flash on top of the defaults. Leaves the cached sector and seq alone.
static bool spiRead(Config &c, SpiRecord &r) {
  uint8_t buf[EXTFLASH_PAGE];
  r.sector = -1;
  r.seq = 0;
  r.skipped = 0;
  r.extras.n = 0;
  for (int8_t s = 0; s < REC_SECTORS; s++) {
    Config t;
    configDefaults(t);
    uint32_t seq;
    int32_t sk;
    Extras x;
    extFlashRead(s * EXTFLASH_SECTOR, buf, sizeof(buf));
    if (!decode(buf, t, seq, sk, x)) continue;
    if (r.sector >= 0 && (int32_t)(seq - r.seq) <= 0) continue;
    r.sector = s;
    r.seq = seq;
    r.skipped = sk;
    r.extras = x;
    c = t;
  }
  return r.sector >= 0;
}

static void adopt(const SpiRecord &r) {
  spiSector = r.sector;
  spiSeq = r.seq;
  extras = r.extras;
}

// The record in the other sector, the one before, holds the key as it was: after a key change, the old key, which
// would stay readable from the chip until the next save. Overwrite it with zeros (programming only clears bits, so
// that record can't come out newer; it then fails its CRC, and a power cut midway leaves the new record standing).
static void scrubOldKey(int8_t sector, const uint8_t key[16]) {
  uint8_t old[16];
  uint32_t addr = sector * EXTFLASH_SECTOR + 14;
  extFlashRead(addr, old, sizeof(old));
  bool erased = true;
  for (uint8_t b : old) erased &= b == 0xFF;
  if (erased || !memcmp(old, key, sizeof(old))) return;
  memset(old, 0, sizeof(old));
  extFlashProgram(addr, old, sizeof(old));
}

// Writes into the sector not holding the newest record, then reads it back.
static bool spiWrite(const Config &c) {
  uint8_t buf[EXTFLASH_PAGE], check[EXTFLASH_PAGE];
  uint32_t seq = spiSector >= 0 ? spiSeq + 1 : 1;
  int8_t sector = spiSector == 0 ? 1 : 0;
  uint32_t addr = sector * EXTFLASH_SECTOR;
  size_t len = encode(c, seq, buf);
  if (!extFlashEraseSector(addr) || !extFlashProgram(addr, buf, len)) return false;
  extFlashRead(addr, check, len);
  if (memcmp(buf, check, len)) return false;
  spiSector = sector;
  spiSeq = seq;
  scrubOldKey(1 - sector, c.key);
  return true;
}

static bool valid(const Config &c) {
  return c.magic == CFG_MAGIC && c.version == CFG_VERSION && c.crc == configCrc(c);
}

void configDefaults(Config &c) {
  memset(&c, 0, sizeof(c));
  c.magic = CFG_MAGIC;
  c.version = CFG_VERSION;
  c.role = ROLE_UNSET;
  c.net_id = 0x42;
  c.freq_hz = 915000000;
  c.sf = 9;
  c.bw_hz = 500000;
  c.cr = 5;
  c.tx_power = 17;
  c.sync_word = 0x12;
  c.retries = 8;
  c.heartbeat_s = 30;
  c.link_timeout_s = 100;
  c.cmd_ttl_s = 10;
  c.debounce_ms = 50;
  c.power_sense = 1;
  c.pulse_ms = 500;
  c.travel_timeout_s = 60;
  c.ctrl_sync = 1;
  c.sync_window_ms = 3000;
  c.resync_ms = 1000;
  c.mismatch_timeout_s = 75;
  c.sensor_invert = 0;
  c.linkloss_open = 1;
  c.ctrl_power_sense = 1;
  c.ctrl_confirm_ms = 500;  // margin for ctrl_power_pmic (bench: power good drops ~0.2 s before the relay);
                            // > ~1.65 s (the IN2 opto's lag) if only IN2 senses the controller's power
  c.ctrl_settle_ms = 10000;
  c.ctrl_power_pmic = 1;
  c.uart_console = 0;
  c.fault_out = 0;
  c.fault_hold_s = 10;
  c.key_set = 0;
}

bool configLoad() {
  configDefaults(cfg);
  source = CFG_DEFAULTS;
  dropped = 0;
  Config c;
  if (extFlashBegin()) {
    SpiRecord r;
    bool found = spiRead(c, r);
    adopt(r);
    if (!found) return false;
    dropped = r.skipped;
  } else {
    cfgStore.read(&c);
    if (!valid(c)) return false;
  }
  cfg = c;
  source = extFlashPresent() ? CFG_FROM_SPI : CFG_FROM_INTERNAL;
  return true;
}

uint8_t configSource() {
  return source;
}

int32_t configDropped() {
  return dropped;
}

const char *configStoreName() {
  return extFlashPresent() ? "spi" : "internal";
}

static bool store(Config &c) {
  c.magic = CFG_MAGIC;
  c.version = CFG_VERSION;
  c.crc = configCrc(c);
  if (extFlashPresent()) return spiWrite(c);
  cfgStore.write(c);
  return true;
}

bool configSave() {
  FlashAccess fa;
  return store(cfg);
}

// What's saved, or the running config if nothing valid is saved yet (nothing to protect then). False if the
// read-back finds no record, or one older than the newest this boot has seen, although that one verified: a
// garbled read, or a newer record gone bad. Saving on top of it would lose settings, or be written with a seq
// that loses to the newer record at the next boot. One retry covers a transient garble.
static bool persisted(Config &c) {
  if (!extFlashPresent()) {
    cfgStore.read(&c);
    if (!valid(c)) c = cfg;
    return true;
  }
  for (int tries = 0; tries < 2; tries++) {
    SpiRecord r;
    if (!spiRead(c, r)) {
      if (spiSector >= 0) continue;
      c = cfg;
      return true;
    }
    if (spiSector >= 0 && (int32_t)(r.seq - spiSeq) < 0) continue;
    adopt(r);
    return true;
  }
  return false;
}

bool configSaveParam(const ParamDef *p) {
  FlashAccess fa;
  Config c;
  if (!persisted(c)) return false;
  c.*(p->field) = cfg.*(p->field);
  return store(c);
}

bool configSaveKey() {
  FlashAccess fa;
  Config c;
  if (!persisted(c)) return false;
  memcpy(c.key, cfg.key, sizeof(c.key));
  c.key_set = cfg.key_set;
  return store(c);
}

// Boot counter: append-only 4-byte slots in two sectors after the config record's, so a boot programs one slot
// and a sector is erased only every 1024 boots. A slot is written in two steps: the count with bit 31 set, read
// back, then bit 31 cleared (committed). A program cut short by a power loss leaves bits at 1 (it "can only read
// high"), so a torn slot has bit 31 set, whatever else it reads, and its count was never returned: such slots are
// skipped. The count is the largest committed value + 1. (Before 0.13.9 slots were written in one step and the count
// was the largest value + 1, so a torn slot reading 0xFFFFFFFD or more wrapped it to 1 for good. A torn slot from then
// with bit 31 set is skipped now too.) When the sector holding the largest value is full, the other one (all smaller
// values) is erased and continues; a power cut during that erase still leaves the largest value in place. Past
// BOOT_COUNT_MAX (2^31 boots, or an old torn slot that cleared bit 31 and read high) the counter has run out and
// returns 0, as without the chip, rather than repeat a count. So does a scan that reads a slot as 0 (garbled).
#define BOOT_SECTOR0 REC_SECTORS
static_assert(BOOT_SECTOR0 + 2 <= HLOG_SECTOR0, "the boot counter's sectors overlap the history log");
#define BOOT_UNCOMMITTED 0x80000000u
#define BOOT_COUNT_MAX 0x7FFFFFFEu  // uncommitted, 0x7FFFFFFF would read as an unwritten slot

uint32_t configCountBoot() {
  if (!extFlashPresent()) return 0;
  FlashAccess fa;
  uint8_t buf[EXTFLASH_PAGE];
  uint32_t maxV = 0;
  int8_t maxSector = 0;
  int32_t freeSlot[2] = { -1, -1 };  // first unwritten slot in each sector
  for (int8_t s = 0; s < 2; s++) {
    uint32_t base = (BOOT_SECTOR0 + s) * EXTFLASH_SECTOR;
    for (uint32_t off = 0; off < EXTFLASH_SECTOR && freeSlot[s] < 0; off += sizeof(buf)) {
      extFlashRead(base + off, buf, sizeof(buf));
      for (uint32_t i = 0; i < sizeof(buf); i += 4) {
        uint32_t v = get32(buf + i);
        if (v == 0xFFFFFFFFu) {
          freeSlot[s] = (off + i) / 4;
          break;
        }
        // No slot is ever written 0 (counts start at 1; one being written has bit 31 set): zeros are a read garbled
        // by the radio module's MCU (extflash.h). They could hide the largest count, which would come round again,
        // and with it the session ids drawn from it: no count this boot, and nothing written or erased.
        if (!v) return 0;
        if (!(v & BOOT_UNCOMMITTED) && v > maxV) {
          maxV = v;
          maxSector = s;
        }
      }
    }
  }
  if (maxV >= BOOT_COUNT_MAX) return 0;
  uint32_t count = maxV + 1;
  int8_t s = maxSector;
  int32_t slot = freeSlot[s];
  if (slot < 0) {
    s = 1 - s;
    if (!extFlashEraseSector((BOOT_SECTOR0 + s) * EXTFLASH_SECTOR)) return 0;
    slot = 0;
  }
  uint32_t addr = (BOOT_SECTOR0 + s) * EXTFLASH_SECTOR + slot * 4;
  uint8_t b[4], check[4];
  put32(b, count | BOOT_UNCOMMITTED);
  if (!extFlashProgram(addr, b, 4)) return 0;
  extFlashRead(addr, check, 4);
  if (memcmp(b, check, 4)) return 0;
  b[3] &= 0x7F;  // commit: bit 31 cleared
  if (!extFlashProgram(addr + 3, b + 3, 1)) return 0;
  extFlashRead(addr + 3, check + 3, 1);
  return check[3] == b[3] ? count : 0;
}

bool configFactoryReset() {
  configDefaults(cfg);
  if (!extFlashPresent()) return store(cfg);
  // Erase both records, so the old key doesn't linger in the older one.
  FlashAccess fa;
  bool ok = true;
  for (int8_t s = 0; s < REC_SECTORS; s++) ok &= extFlashEraseSector(s * EXTFLASH_SECTOR);
  spiSector = -1;
  extras.n = 0;
  return ok;
}

// The id's message can never be a frame (frames start with PROTO_VER, 1, and are longer), so the id is no tag the
// link would accept, and 4 bytes of an HMAC tell nothing about the key. It does confirm a guessed key, which is why
// key.set refuses guessable ones (configKeyWeak).
static const char KEY_ID_LABEL[] = "GateLink key id v1";

void configKeyId(const uint8_t key[16], char out[9]) {
  uint8_t mac[4];
  SHA256 h;
  h.resetHMAC(key, 16);
  h.update(KEY_ID_LABEL, sizeof(KEY_ID_LABEL) - 1);
  h.finalizeHMAC(key, 16, mac, sizeof(mac));
  for (int i = 0; i < 4; i++) snprintf(out + 2 * i, 3, "%02x", mac[i]);
}

bool configKeyWeak(const uint8_t key[16]) {
  bool up = true, down = true;
  for (int i = 1; i < 16; i++) {
    up &= (uint8_t)(key[i] - key[i - 1]) == 1;
    down &= (uint8_t)(key[i - 1] - key[i]) == 1;
  }
  int distinct = 0;  // all bytes equal is 1
  for (int i = 0; i < 16; i++) {
    bool seen = false;
    for (int j = 0; j < i && !seen; j++) seen = key[j] == key[i];
    distinct += !seen;
  }
  return up || down || distinct <= 8;
}

const ParamDef *paramByName(const char *name) {
  for (size_t i = 0; i < PARAM_COUNT; i++)
    if (strcmp(PARAMS[i].name, name) == 0) return &PARAMS[i];
  return nullptr;
}

const ParamDef *paramById(uint8_t id) {
  for (size_t i = 0; i < PARAM_COUNT; i++)
    if (PARAMS[i].id == id) return &PARAMS[i];
  return nullptr;
}

bool paramValid(const ParamDef *p, int32_t value) {
  if (!p || value < p->minV || value > p->maxV) return false;
  if (p->field == &Config::bw_hz && value != 125000 && value != 250000 && value != 500000) return false;
  // No heartbeat_s vs link_timeout_s check here: only the gate uses heartbeat_s, and both boards stretch their link
  // timeout to 2.5 of the gate's heartbeats (houseLinkTimeoutMs, gateLinkTimeoutMs).
  return true;
}

bool paramSet(const ParamDef *p, int32_t value) {
  if (!paramValid(p, value)) return false;
  cfg.*(p->field) = value;
  return true;
}

uint8_t myNodeId() {
  return activeRole == ROLE_GATE ? NODE_GATE : NODE_HOUSE;
}

uint8_t peerNodeId() {
  return activeRole == ROLE_GATE ? NODE_HOUSE : NODE_GATE;
}
