ccirone2/LoRa-GateLink/firmware/GateLink/role_gate.cpp

// Gate node: pulses the CSW24UL OPEN/CLOSE inputs and reports gate position.
//
// The opener's inputs are shared with other controllers (AES Prime Edge, siren
// sensor), so outputs are only ever pulsed and gate state always comes from the
// limit inputs, never from our own last command.
#include "roles.h"
#include "config.h"
#include "log.h"
#include "radio.h"
#include "history.h"
#include "app.h"
#include "board.h"

#define STATUS_TTL_MS 10000
// After boot, the first STATUS waits until the inputs have been steady this long (at most BOOT_SETTLE_MAX_MS): the
// opener may be restarting with us (a power blip at the gate) and its limits come back after we do. Reporting them
// early made the house show not-closed for a moment: the contact sensor opening, K1 flicking.
#define BOOT_SETTLE_MS 3000
#define BOOT_SETTLE_MAX_MS 10000
// A move into `between` waits this long before it's reported (only with power_sense): when the 24 V that wets the
// inputs fails, a limit's opto can drop before IN3's (bench, 2026-10-06), and a moment of between/external was
// logged before no_power. If no_power (or a limit) follows within it, that is reported instead. Out of no_power the
// wait is BOOT_SETTLE_MS: on power return IN3 can come back before the limits (the opener restarting). A move into
// closed waits too, the time over for each reading: the closed limit's NC contact reads closed until a restarting
// opener energizes its AUX2 relay, and IN3 may settle after it. On battery that costs a close 3 s of reading not closed.
#define BETWEEN_HOLD_MS 500

static uint8_t state = GS_UNKNOWN;
static uint8_t cause = CAUSE_NONE;
static uint8_t lastResult = TR_NONE;
static uint8_t target = GS_UNKNOWN;  // state we're waiting to reach after our pulse
static uint8_t leaving = GS_UNKNOWN;  // limit our pulse is moving the gate off (it may be the target after a reversal)
static uint32_t targetSince = 0;
static bool haveCmd = false;
static uint16_t lastCmdId = 0;
static uint32_t lastCmdSeq = 0;  // the link seq the last command taken came in (this house session: haveCmd)
static uint8_t lastCmdAck = RES_OK;
static uint8_t leftClosed = 0;  // times the reported state has left closed since boot (ST_LEFT_CLOSED)
static uint32_t lastStatusAt = 0;
static int32_t reportedHeartbeat = 0;  // heartbeat_s in our last STATUS
static bool reportedRebootLoop = false;  // STI_REBOOTS in our last STATUS
static uint32_t houseSession = 0;  // the house session we last reported to
static bool houseVerified = false;  // the link had verified the house at the last pass
static bool settling = true;  // after boot: tracking the inputs silently, see BOOT_SETTLE_MS
static uint32_t bootAt = 0, steadySince = 0;
// While the state is between: since when, or since our last pulse (a reversal, or a move from a stop), whichever is
// later; kept at most STAMP_CAP_MS old (link.h). gateStuck times it.
static uint32_t stuckSince = 0;
static uint32_t heldAt = 0;  // when the inputs started reading a held move (heldTo) we don't report yet (0 = not)
static uint8_t heldTo = GS_UNKNOWN;
// Both limits have read at once since the open limit last read alone: the closed limit isn't trusted (fault). It comes
// from the AUX2 relay's NC contact, which reads closed whenever that relay isn't energized: a failed relay or driver, or
// the opener's AUX setting wrong. With it stuck, the gate reads fault only while at its open limit and closed everywhere
// else, mid-travel included; held, a stuck closed limit is fault from the first full opening on. The open limit
// reading alone (wetted by the same 24 V) shows the closed one released. Held only once both have read for
// BOTH_LIMITS_HOLD_MS: a stuck one reads both at the open limit for as long as the gate stays there, and a shorter
// overlap (a glitch, the relays switching over on a controller reset) is only a moment's fault, not one held until the
// gate next opens fully. A closed limit straight after open, the gate never between (fromOpen), is fault too, not held:
// no travel is that quick, but the opener's controller restarting drops its AUX relays, releasing the open limit and
// letting the closed one's NC contact read, for as long as the restart takes. The hold is kept through a crash (a
// watchdog or brown-out reset, appKeep): unattended, the gate part-open would read closed again. A deliberate restart
// (the console's reboot, the reset pin, an upload) clears it, the installer's way to clear it after a repair with the
// gate closed, and a power-on can't keep it.
#define BOTH_LIMITS_HOLD_MS 500
static bool closedUnproven = false;
static uint32_t bothSince = 0;  // when both limits started reading (0 = they don't)
static bool fromOpen = false;  // the open limit read alone, and neither has read for BETWEEN_HOLD_MS since
static uint32_t neitherSince = 0;  // when neither limit started reading (0 = one does)
// closed_sense: IN4 is a second closed sensor on the leaf (a reed and magnet, F12), which doesn't depend on the
// opener's AUX2 relay. Closed reads only while it and the closed limit both do; either alone is no closed limit (the
// state is whatever the others read). Once they have disagreed for CLOSED_DISAGREE_MS it's fault until they agree: in
// normal travel they part only between their switching points, a second or two near closed with the sensor mounted to
// read in the last inches, while a failed limit relay, a sensor knocked off or a cut wire disagrees for good. Before
// the fault the gate already reads not closed, so the wait costs only the diagnosis.
#define CLOSED_DISAGREE_MS 5000
static bool disagreed = false;
static uint32_t disagreeSince = 0;  // when the closed limit and the sensor started to disagree (0 = they agree)
static bool rebootAfterCmd = false;  // debug: next pulsed command reboots us before its ACK (a power cut)
static uint32_t rebootAt = 0;

static void drainCfgQueue();

// Our clock: millis() extended to 64 bits so it never wraps (millis() does every 49.7 days), from a random origin drawn
// at boot. STATUS carries it, and the house stamps every command with a deadline in it: a command kept from us and
// played back later is refused however long it stays inside the replay window, no wrap brings an old one back into
// date, and a deadline reckoned in another boot's clock (a house kept from seeing us restart) lands nowhere near ours.
static uint64_t clockBase;    // the latest millis() seen, extended: gateLoop reads the clock every pass
static uint64_t clockOrigin;  // this boot's: 47 random bits, so the clock (48 bits in STATUS) can't overflow

static uint64_t uptimeMs(uint32_t ms) {
  int32_t d = (int32_t)(ms - (uint32_t)clockBase);  // a little negative for the loop's `now` after a handler's millis()
  uint64_t t = clockBase + (int64_t)d;
  if (d > 0) clockBase = t;
  return t - bootAt;
}

static uint64_t gateClock(uint32_t ms) {
  return clockOrigin + uptimeMs(ms);
}

// IN3 = AC power (the 24 V supply on mains). The opener has battery backup, so it keeps running without AC.
static bool acPower() {
  return !cfg.power_sense || in3.active();
}

static uint8_t readState() {
  bool open = in1.active(), limit = in2.active();
  bool closed = limit && (!cfg.closed_sense || in4.active());
  if ((limit && (open || closedUnproven || fromOpen)) || disagreed) return GS_FAULT;
  if (closed) return GS_CLOSED;
  if (open) return GS_OPEN;
  // Without AC a limit that reads can still be trusted (the opener runs on its battery), but none reading may
  // mean the opener's battery is dead too (its AUX limit relays drop), not a gate between limits: unknown.
  if (!acPower()) return GS_NO_POWER;
  return GS_BETWEEN;
}

static void sendStatus(uint32_t now) {
  if (settling) return;  // the first one goes out once the inputs have settled
  uint8_t p[ST_LEN];
  p[ST_STATE] = state;
  reportedRebootLoop = appRebootLoop();
  p[ST_INPUTS] = (in1.active() ? STI_IN1 : 0) | (in2.active() ? STI_IN2 : 0) | (k1.on() ? STI_K1 : 0)
                 | (k2.on() ? STI_K2 : 0) | (in3.active() ? STI_IN3 : 0) | (in4.active() ? STI_IN4 : 0)
                 | (acPower() ? 0 : STI_AC_LOST) | (reportedRebootLoop ? STI_REBOOTS : 0);
  p[ST_CAUSE] = cause;
  p[ST_RESULT] = lastResult;
  putU16(p + ST_CMD_ID, lastCmdId);
  putU32(p + ST_UPTIME, (uint32_t)(uptimeMs(now) / 1000));
  // Every authenticated frame from the house counts, ACKs included (most of what it sends).
  const LinkStats &st = linkStats();
  putU16(p + ST_RSSI, st.lastRxAt ? (uint16_t)st.lastRssi : 0);
  p[ST_SNR] = st.lastRxAt ? (uint8_t)(int8_t)st.lastSnr : 0;
  p[ST_TARGET] = target;
  putU16(p + ST_HEARTBEAT, cfg.heartbeat_s);
  putU16(p + ST_RETRIES, (uint16_t)st.retries);
  putU16(p + ST_GIVEUPS, (uint16_t)st.giveups);
  putU16(p + ST_CRC, (uint16_t)radioCrcErrors());
  int8_t noise, noiseMax;
  histNoiseTake(noise, noiseMax);
  p[ST_NOISE] = (uint8_t)noise;
  p[ST_NOISE_MAX] = (uint8_t)noiseMax;
  putU16(p + ST_TRAVEL, cfg.travel_timeout_s);
  putU48(p + ST_CLOCK, gateClock(now));
  p[ST_LEFT_CLOSED] = leftClosed;
  reportedHeartbeat = cfg.heartbeat_s;
  // Retries spread over the TTL: cap it so a lost status is retried within a fraction of a second even with a
  // long heartbeat (the next heartbeat supersedes it anyway).
  uint32_t ttl = (uint32_t)cfg.heartbeat_s * 1000;
  linkSendReliable(SLOT_STATUS, MSG_STATUS, p, ST_LEN, ttl < STATUS_TTL_MS ? ttl : STATUS_TTL_MS);
  lastStatusAt = now;
}

// Our pulse should take the gate to `want`: track it, so the movement it causes is attributed to us.
static void setTarget(uint8_t want, uint32_t now) {
  // When reversing before the gate left its limit, the earlier pulse is still what moves it off that limit.
  if (state != want && (state == GS_OPEN || state == GS_CLOSED)) leaving = state;
  target = want;
  targetSince = stuckSince = now;
  lastResult = TR_NONE;
}

static void clearTarget() {
  target = GS_UNKNOWN;
  leaving = GS_UNKNOWN;
}

// Interlock: never both. Releasing one relay and energizing the other in the same instant isn't enough (a contact
// can make before the other has broken: the bench opener saw OPEN and CLOSE together), so wait for the release.
// That holds when the other relay released by itself just before, too (its pulse ended a few ms ago).
#define INTERLOCK_MS 100

static void interlockedPulse(Relay &r, Relay &other, uint32_t now, uint32_t ms) {
  bool wasOn = other.on() || other.pulsing();
  other.set(false);
  r.pulse(now, ms, wasOn ? INTERLOCK_MS : other.gapLeft(now, INTERLOCK_MS));
}

static void pulse(Relay &r, Relay &other, uint8_t which, uint32_t now) {
  interlockedPulse(r, other, now, cfg.pulse_ms);
  logEvent(EV_PULSE, which, cfg.pulse_ms);
}

void gateBegin() {
  closedUnproven = appKept() & KEEP_CLOSED_UNPROVEN;  // kept through a crash; a deliberate restart clears it
  state = readState();
  cause = CAUSE_NONE;
  settling = true;
  bootAt = steadySince = stuckSince = millis();
  clockBase = bootAt;
  clockOrigin = ((uint64_t)radioRandom32() << 15 ^ radioRandom32()) & ((1ULL << 47) - 1);
}

void gateLoop(uint32_t now) {
  uptimeMs(now);  // keeps the clock's base within 2^31 ms of millis()
  if (rebootAt && elapsed(now, rebootAt, 0)) boardReset();
  in1.update(now, cfg.debounce_ms, cfg.in1_invert);
  in2.update(now, cfg.debounce_ms, cfg.in2_invert);
  if (!in1.active() || !in2.active()) {
    bothSince = 0;
    if (in1.active()) closedUnproven = false;
  } else if (!bothSince) {
    bothSince = now | 1;
  } else if (elapsed(now, bothSince, BOTH_LIMITS_HOLD_MS)) {
    closedUnproven = true;  // a stamp that ages past 2^31 ms only sets it again
  }
  appKeep(closedUnproven ? KEEP_CLOSED_UNPROVEN : 0);  // a crash mustn't drop it with the gate part-open
  // Only a real move clears fromOpen, neither limit reading for BETWEEN_HOLD_MS: relays dropping together pass
  // through both or neither for a moment.
  if (in1.active() || in2.active()) {
    neitherSince = 0;
    if (!in2.active()) fromOpen = true;
  } else if (!neitherSince) {
    neitherSince = now | 1;
  } else if (elapsed(now, neitherSince, BETWEEN_HOLD_MS)) {
    fromOpen = false;  // a stamp that ages past 2^31 ms only clears it again
  }
  bool spareChanged = updateSpareInputs(now);  // before readState(): IN3 is the power sense, IN4 the closed sensor
  if (!cfg.closed_sense || in2.active() == in4.active()) {
    disagreeSince = 0;
    disagreed = false;
  } else if (!disagreeSince) {
    disagreeSince = now | 1;
  } else if (elapsed(now, disagreeSince, CLOSED_DISAGREE_MS)) {
    disagreed = true;  // a stamp that ages past 2^31 ms only sets it again
  }

  uint8_t s = readState();
  // `leaving` holds only while our pulse may still be what moves the gate off that limit: with both relays released
  // for debounce_ms (the inputs' own lag) and the gate still reading it, the pulse didn't move it (the siren holding
  // OPEN, say), and a later move off that limit is someone else's.
  if (leaving != GS_UNKNOWN && s == leaving && !appRelaysPulsing() && !k1.gapLeft(now, cfg.debounce_ms)
      && !k2.gapLeft(now, cfg.debounce_ms))
    leaving = GS_UNKNOWN;
  bool held = s != state && (s == GS_BETWEEN || (s == GS_CLOSED && state == GS_NO_POWER));
  if (!held) {
    heldAt = 0;
  } else if (!heldAt || s != heldTo) {
    heldAt = now | 1;  // a held reading that changes starts over: closed after between out of no_power gets it all
    heldTo = s;
  }
  bool holdMove = heldAt && cfg.power_sense
                  && !elapsed(now, heldAt, state == GS_NO_POWER ? BOOT_SETTLE_MS : BETWEEN_HOLD_MS);
  if (settling) {
    // Follow the inputs without reporting (no cause: nothing is attributed to a boot), until they hold still.
    if (s != state) {
      state = s;
      steadySince = now;
    }
    if (elapsed(now, steadySince, BOOT_SETTLE_MS) || elapsed(now, bootAt, BOOT_SETTLE_MAX_MS)) {
      settling = false;
      sendStatus(now);
    }
  } else if (s != state && !holdMove) {
    // Into or out of no_power there's no telling a movement from the power changing (on battery the gate may
    // have moved while no limit read; on AC return the limits and IN3 settle in either order): no cause.
    bool power = s == GS_NO_POWER || state == GS_NO_POWER;
    uint8_t prev = state;
    state = s;
    if (prev == GS_CLOSED) leftClosed++;
    // Ours only while our pulse is still heading somewhere and the gate moves that way: reaching the target,
    // or leaving a limit toward it (or the limit our pulse is moving it off). Anything else (a local button,
    // the other controllers, an override to the far limit) is external.
    bool ours = target != GS_UNKNOWN
                && (s == target || (s == GS_BETWEEN && (prev != target || prev == leaving)));
    cause = power ? CAUSE_NONE : ours ? CAUSE_LORA : CAUSE_EXTERNAL;
    if (s == GS_BETWEEN) leaving = GS_UNKNOWN;
    if (target != GS_UNKNOWN && state == target) {
      lastResult = TR_REACHED;
      clearTarget();
    } else if (target != GS_UNKNOWN && (state == GS_OPEN || state == GS_CLOSED)) {
      // Overridden to the other limit (siren, AES, local button): our command is over, and reporting it as
      // a timeout makes the house resync its controller at once.
      lastResult = TR_TIMEOUT;
      clearTarget();
    }
    logEvent(EV_GATE_STATE, state, cause);
    sendStatus(now);
  } else if (spareChanged) {
    sendStatus(now);
  }
  if (state != GS_BETWEEN) stuckSince = now;
  else if (elapsed(now, stuckSince, STAMP_CAP_MS)) stuckSince = now - STAMP_CAP_MS;

  // The house verified: a new session (it rebooted: its command ids restart, so forget the last one), or ours started
  // over (a key or radio setting) and verified it again. Report now either way, so the house restores K1/K2 and has our
  // clock to date its commands in without waiting for the next heartbeat.
  bool verified = linkPeerVerified();
  if (verified && (!houseVerified || linkPeerSession() != houseSession)) {
    if (linkPeerSession() != houseSession) haveCmd = false;
    houseSession = linkPeerSession();
    sendStatus(now);
  }
  houseVerified = verified;

  if (target != GS_UNKNOWN && elapsed(now, targetSince, (uint32_t)cfg.travel_timeout_s * 1000)) {
    // A reversal pulsed before the gate left its limit never sees a state change: it's there already.
    if (state == target) {
      lastResult = TR_REACHED;
    } else {
      logEvent(EV_TRAVEL_TIMEOUT, target);
      lastResult = TR_TIMEOUT;
    }
    clearTarget();
    sendStatus(now);
  }

  // A new heartbeat_s goes out at once: the house sizes its link timeout from it, and waiting for the next
  // (longer) heartbeat would let its old timeout expire first. So does the end of a reboot loop (STATUS bit 7): the
  // house holds its D5 low for it until it hears.
  if (elapsed(now, lastStatusAt, (uint32_t)cfg.heartbeat_s * 1000) || cfg.heartbeat_s != reportedHeartbeat
      || appRebootLoop() != reportedRebootLoop) {
    sendStatus(now);
  }

  drainCfgQueue();
}

static void handleCmd(const RxMsg &m, uint32_t now) {
  if (m.len < CMD_LEN) {
    linkAck(m.seq, RES_BAD);
    return;
  }
  uint16_t id = getU16(m.payload);
  uint8_t action = m.payload[2];
  if (haveCmd && id == lastCmdId) {
    logEvent(EV_CMD_DUP, id);
    linkAck(m.seq, lastCmdAck);
    return;
  }
  // Framed before the last command taken: the replay window takes a lower seq it hasn't seen, so this is one kept from
  // us and played back after the owner's later command (the house never frames a command again once a later one has
  // replaced it in its slot). Running it, inside its deadline still, would undo the owner's last word, or run a
  // renumbered resend of a command already run a second time. Refused, as late.
  if (haveCmd && m.seq < lastCmdSeq) {
    logEvent(EV_REPLAY, (int32_t)m.seq, (int32_t)lastCmdSeq);
    linkAck(m.seq, RES_LATE);
    return;
  }
  if (action != ACT_OPEN && action != ACT_CLOSE) {
    linkAck(m.seq, RES_BAD);
    return;
  }
  // Past its deadline by our clock: kept from us (jammed here while it was recorded) and played back, or so late that
  // the house has given it up. Or a deadline further ahead than any cmd_ttl_s makes it: a clock reckoned wrong, or
  // another boot's (a house kept from seeing us restart dates commands in our last boot's clock). The
  // house's reckoning lags ours by a STATUS's time on the air at least (the clock is read as it's built), and the
  // command takes its own to get here: at SF12/125 kHz seconds each, so the slack covers them as well.
  int64_t late = (int64_t)(gateClock(now) - getU48(m.payload + CMD_DEADLINE));
  int64_t slack = CMD_LATE_SLACK_MS + radioAirtimeMs(LINK_OVERHEAD + ST_LEN) + radioAirtimeMs(LINK_OVERHEAD + CMD_LEN);
  if (late > slack || late < -(int64_t)CMD_AHEAD_MAX_MS) {
    logEvent(EV_CMD_LATE, id, late > INT32_MAX ? INT32_MAX : late < INT32_MIN ? INT32_MIN : (int32_t)late);
    linkAck(m.seq, RES_LATE);
    return;
  }
  logEvent(EV_CMD_RX, action, id);
  haveCmd = true;
  lastCmdId = id;
  lastCmdSeq = m.seq;
  uint8_t want = action == ACT_OPEN ? GS_OPEN : GS_CLOSED;
  // Bound first, not `(action == ACT_OPEN ? k1 : k2).pulsing()`: ESBMC 8.5 calls a method on a conditional's other
  // operand (tools/verify).
  const Relay &mine = action == ACT_OPEN ? k1 : k2;
  // Still at this limit, but our last pulse is heading for the other one: pulse to reverse it.
  bool reversing = target != GS_UNKNOWN && target != want;
  // Without AC the opener runs on its battery, so a command still goes while a limit reads: the owner asked for it,
  // and cutting the AC mustn't keep an open gate open. So does one while our pulse is still under way (no limit reads
  // on battery mid-travel, but the opener just ran: a reversal). Otherwise with none reading (no_power, where the
  // opener may be dead) or both (fault) the position can't be verified: refused.
  if (!acPower() && state != GS_OPEN && state != GS_CLOSED && (state != GS_NO_POWER || target == GS_UNKNOWN)) {
    logEvent(EV_CMD_REFUSED, action, id);
    lastCmdAck = RES_NO_POWER;
  } else if (state == want && !reversing) {
    lastResult = TR_ALREADY;
    lastCmdAck = RES_ALREADY;
  } else if (mine.pulsing()) {
    // That relay is pulsing already (or waiting out the interlock to start): a second command the same way, such as
    // the switch flicked off and on inside ctrl_confirm_ms. It's the same press: ACK it as done. A running pulse is
    // never restarted, which would hold the opener's input for the gap plus pulse_ms.
    if (target != want) setTarget(want, now);
    lastCmdAck = RES_OK;
  } else {
    if (action == ACT_OPEN) pulse(k1, k2, 1, now);
    else pulse(k2, k1, 2, now);
    setTarget(want, now);
    lastCmdAck = RES_OK;
    if (rebootAfterCmd) {
      // Bench fault injection: the pulse runs, then we reset without ACKing, as a power cut right after it would.
      rebootAfterCmd = false;
      rebootAt = (now + cfg.pulse_ms + 100) | 1;
      return;
    }
  }
  linkAck(m.seq, lastCmdAck);
  sendStatus(now);
}

// Remote writes waiting for the relays: a save blocks the loop (sector erase, then radioRestart: ~1 s), and
// Relay::update doesn't run meanwhile, so a pulse in progress would be held that much longer. They are accepted
// at once (linkAckLater) and applied, saved and ACKed once no pulse is running or waiting for its interlock start;
// the house's CFG slot keeps retrying meanwhile, and its retransmits are held, not answered. One arriving with the
// queue full isn't taken at all (linkRefuse): the house's slot resends it, and its TTL outlasts any pulse.
#define CFG_QUEUE 4
struct QueuedCfg {
  uint32_t seq;
  const ParamDef *p;
  int32_t v;
};
static QueuedCfg cfgQueue[CFG_QUEUE];
static uint8_t cfgQueued = 0;

static void applyCfgSet(const QueuedCfg &q) {
  paramSet(q.p, q.v);  // checked on arrival
  bool saved = configSaveParam(q.p);  // not configSave(): that would also persist unsaved console edits
  logEvent(EV_CFG_REMOTE, q.p->id, q.v);
  linkAck(q.seq, saved ? RES_OK : RES_NOT_SAVED);
}

static void handleCfgSet(const RxMsg &m) {
  if (m.len < 5) {
    linkAck(m.seq, RES_BAD);
    return;
  }
  const ParamDef *p = paramById(m.payload[0]);
  int32_t v = (int32_t)getU32(m.payload + 1);
  if (!p || !(p->flags & P_REMOTE) || !paramValid(p, v)) {
    linkAck(m.seq, RES_BAD);
    return;
  }
  QueuedCfg q = { m.seq, p, v };
  if (!cfgQueued && !appRelaysPulsing()) {
    applyCfgSet(q);
  } else if (cfgQueued < CFG_QUEUE) {
    cfgQueue[cfgQueued++] = q;
    linkAckLater(m.seq);
  } else {
    // Full: the house sends one at a time, but its resends are renumbered whenever it answers a HELLO (replayed ones
    // too), so copies of one write can fill the queue. Saving now would hold the relay ~0.5 s long: don't take it,
    // nor ACK it, and its resend is taken once there's room.
    linkRefuse(m.seq);
  }
}

// One queued write per loop pass, in order, while no pulse runs (a command may start one between them).
static void drainCfgQueue() {
  if (!cfgQueued || appRelaysPulsing()) return;
  QueuedCfg q = cfgQueue[0];
  memmove(cfgQueue, cfgQueue + 1, --cfgQueued * sizeof(QueuedCfg));
  applyCfgSet(q);
}

static void sendDiag() {
  // Layout: DIAG_* in roles.h.
  uint8_t p[100];
  const char *v = fwVersion();  // "x.y.z"
  for (int i = 0; i < 3; i++) {
    uint8_t x = 0;
    while (*v >= '0' && *v <= '9') x = x * 10 + (*v++ - '0');
    p[DIAG_FW + i] = x;
    if (*v == '.') v++;
  }
  putU32(p + DIAG_UPTIME, (uint32_t)(uptimeMs(millis()) / 1000));
  const LinkStats &st = linkStats();
  uint32_t counters[DC_COUNT];
  counters[DC_TX] = st.tx;
  counters[DC_RX] = st.rx;
  counters[DC_MAC_FAIL] = st.macFail;
  counters[DC_REPLAY] = st.replay;
  counters[DC_RETRIES] = st.retries;
  counters[DC_GIVEUPS] = st.giveups;
  for (int i = 0; i < DC_COUNT; i++) putU16(p + DIAG_COUNTERS + 2 * i, counters[i] > 0xFFFF ? 0xFFFF : counters[i]);
  uint8_t n = DIAG_HDR;
  for (size_t i = 0; i < PARAM_COUNT && n + 5u <= sizeof(p); i++) {
    if (!(PARAMS[i].flags & P_REMOTE)) continue;
    p[n++] = PARAMS[i].id;
    putU32(p + n, (uint32_t)(cfg.*(PARAMS[i].field)));
    n += 4;
  }
  linkSend(MSG_DIAG, p, n);
}

void gateOnRx(const RxMsg &m) {
  uint32_t now = millis();
  switch (m.type) {
    case MSG_CMD: handleCmd(m, now); break;
    case MSG_CFG_SET: handleCfgSet(m); break;
    case MSG_DIAG_REQ: sendDiag(); break;
    default: break;
  }
}

void gateOnAck(Slot, uint8_t, bool, uint8_t) {}

void gateStatus(JsonObject o) {
  o["gate"] = gateStateName(state);
  o["cause"] = causeName(cause);
  o["last_result"] = resultName(lastResult);
  o["target"] = target == GS_UNKNOWN ? "" : gateStateName(target);
  o["last_cmd_id"] = lastCmdId;
  o["power_sense"] = (bool)cfg.power_sense;
  o["ac_power"] = acPower();
  o["settling"] = settling;
}

// The house answers each of our STATUS reports (heartbeat_s apart, or sooner) and sends nothing else unasked, so a
// working link may be quiet for a heartbeat: the timeout covers 2.5 of them whatever link_timeout_s says, as the house's
// does (houseLinkTimeoutMs; a heartbeat_s past link_timeout_s / 2.5 would read as a link that keeps dropping).
uint32_t gateLinkTimeoutMs() {
  uint32_t ms = (uint32_t)cfg.link_timeout_s * 1000;
  uint32_t hb = (uint32_t)cfg.heartbeat_s * 2500;
  return hb > ms ? hb : ms;
}

bool gateDecided() {
  return !settling;  // settling ends with the first STATUS sent (gateLoop)
}

uint8_t gateCurrentState() {
  return state;
}

bool gateAcPresent() {
  return acPower();
}

bool gateStuck(uint32_t now) {
  return state == GS_BETWEEN && elapsed(now, stuckSince, (uint32_t)cfg.travel_timeout_s * 1000);
}

void gateDebugRebootAfterCmd() {
  rebootAfterCmd = true;
}

bool gateRelayTest(uint8_t k, uint32_t ms) {
  uint32_t now = millis();
  Relay &r = k == 1 ? k1 : k2;
  Relay &other = k == 1 ? k2 : k1;
  if (r.pulsing()) return false;  // running, or waiting out the interlock: never restarted (the console says busy)
  interlockedPulse(r, other, now, ms);
  // Track it like a command so the resulting movement is attributed to us, not external. A gate already at
  // that limit won't move for it, so there's nothing to attribute (a later move off it is someone else's).
  // With no AC and no limit reading the opener may be dead: the pulse is only a wiring check, and the limit read
  // when power returns isn't ours.
  uint8_t want = k == 1 ? GS_OPEN : GS_CLOSED;
  if (state != want && state != GS_NO_POWER) setTarget(want, now);
  logEvent(EV_PULSE, k, ms);
  return true;
}
