ccirone2/LoRa-GateLink/firmware/GateLink/app.h

#pragma once
#include <Arduino.h>
#include <ArduinoJson.h>

// The application around the roles: boot, the main loop, PING/PONG, dispatch by role, the status LED and the
// status report (app.cpp). GateLink.ino only adds the watchdog and the chip registers.
void appRelaysBegin();  // first thing at boot: relays (and the LED) off
// The rest of the boot, once the watchdog runs. resetCause: PM->RCAUSE; serial: the chip's 128-bit serial number.
void appSetup(uint8_t resetCause, const uint32_t serial[4]);
void appLoop();  // one pass of the main loop

// Used by the console.
void appFillStatus(JsonObject o);
bool appPing();
bool appRelayTest(uint8_t k, uint32_t ms);  // false: on the gate, that relay is pulsing already (busy)
// A relay pulse is running or waiting for its interlock start. Flash saves and radio restarts block the loop for
// up to ~1 s, and Relay::update doesn't run meanwhile, so they wait until this is false (the pulse would stretch):
// console requests (console.cpp blocksLoop), remote config writes (role_gate.cpp), radio recovery and the history's
// writes to the flash (appLoop).
bool appRelaysPulsing();
void appRestartRadio();
void appIdentify(uint32_t ms);  // strobe the LED so the board can be picked out on the bench
uint32_t appBootCount();  // this boot's number (configCountBoot); 0 if the flash chip didn't answer or it ran out
// Heard from the peer within the link timeout: the house, a STATUS taken (houseStatusAt) within houseLinkTimeoutMs();
// the gate, any authenticated frame within link_timeout_s.
bool appLinkUp(uint32_t now);
