ccirone2/LoRa-GateLink/tests/native/test_system_gate_state.cpp

// Gate state, cause, boot settle, the between hold and AC power (CLAUDE.md "Behavioural invariants"), through the
// whole simulated site (world.h): both boards' firmware, the opener, the controller and the radio between them.
//
// Timings below are exact where the firmware makes them so: the gate's loop runs every simulated millisecond, inputs
// debounce for debounce_ms (50) from the pass that first sees them change, and the gate stamps the start of a
// between with `now | 1`.
#include <Arduino.h>
#include <limits.h>
#include <stdio.h>
#include <exception>
#include "world.h"

namespace {

enum { CAUSE_NONE_ = 0, CAUSE_LORA_ = 1, CAUSE_EXTERNAL_ = 2 };  // roles.h Cause
enum { ACT_OPEN_ = 1, ACT_CLOSE_ = 2 };                          // roles.h Action
enum { MSG_STATUS_ = 5 };                                        // link.h MsgType
enum { RES_NO_POWER_ = 4 };                                      // link.h AckResult
const uint32_t MISMATCH_MS = 75000;                              // mismatch_timeout_s default
const int ANY = INT_MIN;

// The site, failing the test (not aborting the run) on a monitor breach. world.cpp hands the breaches of a World to an
// after-test hook that throws them outside the runner's try block, so a test that also failed a CHECK terminated the
// whole program; here they are reported in the test, and printed when it has already failed.
struct Site : World {
  ~Site() noexcept(false) {
    if (violations.empty()) return;
    std::string all = "invariant monitors:";
    for (const std::string &v : violations) all += "\n        " + v;
    violations.clear();
    if (std::uncaught_exceptions()) {
      printf("      %s\n", all.c_str());
      return;
    }
    throw Failure(all);
  }
};

struct Found {
  bool ok = false;
  LogEv e{};
};

// The first `ev` on b since log index `from` (with a, and b, if given).
Found find(const Board &b, const char *ev, size_t from, int a = ANY, int bv = ANY) {
  Found f;
  for (size_t i = from; i < b.logs.size(); i++) {
    const LogEv &e = b.logs[i];
    if (e.ev == ev && (a == ANY || e.a == a) && (bv == ANY || e.b == bv)) {
      f.ok = true;
      f.e = e;
      return f;
    }
  }
  return f;
}

int countSince(const Board &b, const char *ev, size_t from, int a = ANY, int bv = ANY) {
  int n = 0;
  for (size_t i = from; i < b.logs.size(); i++) {
    const LogEv &e = b.logs[i];
    n += e.ev == ev && (a == ANY || e.a == a) && (bv == ANY || e.b == bv);
  }
  return n;
}

Found waitFor(World &w, Board &b, const char *ev, size_t from, uint32_t maxMs, int a = ANY, int bv = ANY) {
  Found f;
  w.runUntil([&] {
    f = find(b, ev, from, a, bv);
    return f.ok;
  }, maxMs);
  return f;
}

// Runs `ms`, checking `ok` every millisecond; returns the world time it first failed (0 = never).
uint32_t watch(World &w, uint32_t ms, const std::function<bool()> &ok) {
  uint32_t bad = 0;
  for (uint32_t i = 0; i < ms; i++) {
    w.step();
    if (!bad && !ok()) bad = w.now;
  }
  return bad;
}

std::string str(const JsonDocument &d, const char *k) {
  return d[k].isNull() ? "(null)" : d[k].as<std::string>();
}

#define CHECK_STR(expr, want) \
  do { \
    std::string got_ = (expr), want_ = (want); \
    if (got_ != want_) \
      throw Failure(where(__FILE__, __LINE__, "CHECK_STR(" #expr "): \"" + got_ + "\" != \"" + want_ + "\"")); \
  } while (0)

// First frame of `type` the board put on the air at or after world time `at` (nullptr if none).
const AirFrame *firstSent(const World &w, const Board &b, uint8_t type, uint32_t at) {
  for (const AirFrame &f : w.air)
    if (f.from == b.idx && f.type() == type && (int32_t)(f.start - at) >= 0) return &f;
  return nullptr;
}

// The user opens the gate from Alarm.com and it gets there (our command, cause lora); then the sync window K1 opened
// runs out, so a later user action counts.
void openByUser(World &w) {
  size_t g0 = w.gate.logs.size();
  w.user(true);
  Found op = waitFor(w, w.gate, "gate_state", g0, 15000, GS_OPEN_);
  CHECK(op.ok);
  CHECK_EQ(op.e.b, CAUSE_LORA_);
  CHECK(w.runUntil([&] { return w.houseSees() == GS_OPEN_; }, 3000));
  w.run(4000);
}

// Waits for the gate to report a state (its own log) and the house to have it too.
void waitBoth(World &w, int gs, uint32_t maxMs) {
  CHECK(w.runUntil([&] { return w.gateSees() == gs && w.houseSees() == gs; }, maxMs));
}

// Steps the world with the opener deaf to its OPEN input (the pulse arrives, nothing happens): while gate K1 is on, the
// opener's debounced OPEN input already reads pressed, so it never sees an edge.
uint32_t runDeafToOpen(World &w, uint32_t ms, const std::function<bool()> &ok) {
  uint32_t bad = 0;
  for (uint32_t i = 0; i < ms; i++) {
    if (w.gate.coil(1)) w.opener.open.raw = w.opener.open.stable = true;
    w.step();
    if (!bad && !ok()) bad = w.now;
  }
  return bad;
}

}  // namespace

// ---------------------------------------------------------------------------------------------------------------
// [state-from-limits]

// [state-from-limits] [cause]
TEST(gate_state_command_reports_limits_not_the_command) {
  Site w;
  w.commission();
  size_t g0 = w.gate.logs.size();
  w.user(true);
  Found p = waitFor(w, w.gate, "pulse", g0, 3000, 1);
  CHECK(p.ok);
  // Leaving the closed limit: between, ours.
  Found btw = waitFor(w, w.gate, "gate_state", g0, 3000);
  CHECK(btw.ok);
  CHECK_EQ(btw.e.a, GS_BETWEEN_);
  CHECK_EQ(btw.e.b, CAUSE_LORA_);
  // Mid-travel the command is known, but the gate is between and says so.
  w.run(3000);
  CHECK(!w.opener.atOpen() && !w.opener.atClosed());
  JsonDocument s = w.gate.status();
  CHECK_STR(str(s, "gate"), "between");
  CHECK_STR(str(s, "target"), "open");
  CHECK_EQ(countSince(w.gate, "gate_state", g0, GS_OPEN_), 0);
  // Open only once the open limit has read for the debounce.
  uint32_t reachedAt = 0;
  CHECK(w.runUntil([&] {
    if (!reachedAt && w.opener.in(1)) reachedAt = w.now;
    return find(w.gate, "gate_state", g0, GS_OPEN_).ok;
  }, 10000));
  Found op = find(w.gate, "gate_state", g0, GS_OPEN_);
  CHECK(reachedAt != 0);
  CHECK_IN(op.e.at - reachedAt, 50, 52);  // debounce_ms 50
  CHECK_EQ(op.e.b, CAUSE_LORA_);
  s = w.gate.status();
  CHECK_STR(str(s, "gate"), "open");
  CHECK_STR(str(s, "last_result"), "reached");
  CHECK_STR(str(s, "target"), "");
  CHECK_EQ(countSince(w.gate, "gate_state", g0), 2);
}

// [state-from-limits] [cause]
TEST(gate_state_deaf_opener_stays_closed_until_travel_timeout) {
  // The opener ignores our OPEN pulse: the gate keeps reporting closed (its limit) and the contact sensor stays closed
  // the whole time; the command ends in a travel timeout, and the house puts the controller back off at once.
  Site w;
  w.commission();
  size_t g0 = w.gate.logs.size(), h0 = w.house.logs.size();
  w.user(true);
  auto closedAll = [&] { return w.opener.atClosed() && w.sensorClosed() && !w.house.coil(1); };
  CHECK_EQ(runDeafToOpen(w, 3000, closedAll), 0);
  Found p = find(w.gate, "pulse", g0, 1);
  CHECK(p.ok);
  CHECK(w.opener.presses[0].size() == 1);  // the pulse reached the input
  JsonDocument s = w.gate.status();
  CHECK_STR(str(s, "gate"), "closed");
  CHECK_STR(str(s, "target"), "open");
  CHECK_EQ(runDeafToOpen(w, p.e.at + 59900 - w.now, closedAll), 0);
  CHECK_EQ(countSince(w.gate, "travel_timeout", g0), 0);
  // (K1 may cycle from here on: the resync)
  CHECK_EQ(runDeafToOpen(w, 300, [&] { return w.opener.atClosed() && w.sensorClosed(); }), 0);
  Found tt = find(w.gate, "travel_timeout", g0);
  CHECK(tt.ok);
  CHECK_EQ(tt.e.a, GS_OPEN_);
  CHECK_IN(tt.e.at - p.e.at, 60000, 60002);  // travel_timeout_s 60
  CHECK_EQ(countSince(w.gate, "gate_state", g0), 0);
  CHECK_EQ(countSince(w.house, "gate_state", h0), 0);
  s = w.gate.status();
  CHECK_STR(str(s, "gate"), "closed");
  CHECK_STR(str(s, "last_result"), "timeout");
  CHECK_STR(str(s, "target"), "");
  CHECK_STR(str(w.house.status(), "last_result"), "timeout");
  // Resync at once (mismatch_timeout_s is 75 s): the controller goes back off.
  Found rs = waitFor(w, w.house, "resync", h0, 2000);
  CHECK(rs.ok);
  CHECK_EQ(rs.e.a, 0);
  CHECK_IN(rs.e.at - tt.e.at, 0, 1000);
  CHECK(w.runUntil([&] { return !w.alarmSwitch(); }, 3000));
  CHECK(w.sensorClosed());
}
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
