ccirone2/LoRa-GateLink/(commit log)

2026-09-27 Add GateLink LoRa gate bridge firmware and web console
    Arduino MKR WAN 1310 firmware (one sketch, house/gate roles) that bridges an
    Alarm.com Shelly Wave 1 to a LiftMaster CSW24UL over authenticated point-to-point
    LoRa, plus a static Web Serial page for configuration and diagnostics.
2026-09-27 Pulse status LED as a heartbeat when the link is down
    Replace the fast 4 Hz blink with a PWM lub-dub heartbeat.
    [GateLink.ino]
2026-09-27 Breathe status LED while the link is up
2026-09-27 Auto-reconnect the web console after a board reboot or drop
    After a reboot (or unexpected disconnect) keep retrying the already-granted port for
    30 s, and take a granted port that reappears in that window as the returning board, so
    the user doesn't have to re-pair. A user-initiated Disconnect cancels this.
2026-09-27 Add Install tab with field wiring for each board
    Wiring diagram, terminal table and notes for the house and gate boards, using generic
    controller naming. Opens on the connected board's role and works without a board.
    Also fix [hidden] elements being shown: button { display: inline-block } overrode the
    hidden attribute, so Disconnect showed while disconnected.
2026-09-27 Add spare inputs, identify, reset-cause logging and bounded radio TX
    - IN3/IN4 (A3/A4) as spare dry-contact inputs with pull-ups (no longer floating):
    in3_invert/in4_invert params, logged as 'input' events, shown in status, sent to
    the house in STATUS bits 4-5, and listed on the Install tab. No behaviour yet.
    CFG_VERSION 2.
    - identify console command + Identify button: strobes the LED for 6 s.
    - Record PM->RCAUSE at boot (boot log + status reset_cause, shown in the Board card).
    - radioSend waits for TX done with a deadline and re-initialises the radio on a stuck
    or reset radio (logged as radio_fail, counted in radio_faults) instead of hanging
    until the watchdog fires.
    - README: ben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
    [GateLink.ino, app.h, config.cpp, config.h, console.cpp, log.cpp, log.h, pins.h]
2026-09-27 Tune status LED: dim, faster pulses that never go fully dark
    Breathing (link up) 2.5 s between 2 and 40; heartbeat (no link) 0.85 s lub-dub
    between 2 and 15/7, so neither reads as the solid no-role light.
2026-09-27 Update docs for recent console, firmware and bench changes
    README: status LED table, Identify/auto-reconnect/controller naming in the web console,
    spare inputs, power and antenna notes, troubleshooting. CLAUDE.md: bounded radio TX,
    LED/spare inputs/reset cause, web console notes and naming rule, bench testing.
2026-09-28 Add opener power sense on gate IN3
    An unpowered CSW24UL drops its AUX limit relays, which read the same as a
    gate stopped between limits. Gate IN3 (opto across the opener's 24 V) now
    reports a no_power state that overrides the limits (cause none) and makes
    the gate refuse OPEN/CLOSE with RES_NO_POWER instead of pulsing. Controlled
    by the new remote-writable power_sense setting (default on).
    Bumps CFG_VERSION to 3 and firmware to 0.2.0; flash both boards together.
    Web console shows "no power", the refused result and opto wiring notes.
    Claude-Session: https://claude.ai/code/session_016ESkN8YtFwAYerYr8Z165x
2026-09-29 Use pull-down inputs for PNP opto board; toggles for on/off settings
    The gate's field inputs go through a PNP-output (sourcing) opto board, so all
    four inputs now use the SAMD internal pull-down and read active when driven
    to 3.3 V. A dead opto, missing 24 V or cut wire still reads inactive. The
    house controller contact now switches 3.3 V instead of GND. Firmware 0.3.0.
    Web console: on/off parameters are toggle switches instead of dropdowns;
    Install tab shows the opto board wiring and 3.3 V contacts; "close limit"
    is renamed "closed limit" in the UI and docs.
    Claude-Session: https://claude.ai/code/session_016ESkN8YtFwAYer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
    [config.h, io.cpp, io.h, pins.h]
2026-09-29 Review docs and console copy for opto inputs and toggles
    README: bench checklist and setup cover the toggle switches and power_sense,
    diagram shows the opto-isolated gate inputs, long lines reflowed, house
    result wording matches the console. CLAUDE.md notes fieldValue/setField and
    the invert trick for bench scripts. Console: clearer Apply/Save text, gate
    IN3 shown as opener power. Firmware comments updated (no code change).
    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
    [pins.h, roles.h]
2026-09-29 Never turn K1-caused controller edges into commands
    The sync window was only opened when the Shelly was expected to move. A Shelly
    set to toggle on SW edges flips on every K1 change, so reaching a limit (or the
    second half of a resync) produced a reverse command, and resync looped sending
    CLOSE every mismatch_timeout. Every K1 change now opens the sync window.
    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
    [role_house.cpp]
2026-09-29 Tighten sync edge cases: reversals, reboot status, test pulses
    - Gate sends STATUS as soon as a new house session is verified, so a
    rebooted house restores K1/K2 without waiting for the heartbeat.
    - A command opposing one still in flight is no longer suppressed at the
    house or ACKed `already` at the gate; the gate pulses to reverse it.
    A target already reached at travel timeout reports `reached`.
    - The end of a K1 test pulse opens a sync window, so the Shelly edge it
    causes can't become a command if arming happened during the pulse.
    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
    [role_gate.cpp, role_house.cpp]
2026-09-29 Sense controller power on house IN2
    A Shelly losing power drops its relay, which looked like the user turning
    the switch off: the house sent CLOSE, then OPEN when the Shelly came back
    (confirmed on the bench). House IN2 now senses the Shelly supply through a
    PNP opto (ctrl_power_sense, default on):
    - While it's off, IN1 edges are logged (ctrl b=1) but never sent, and
    resync pauses.
    - Each IN1 edge waits ctrl_confirm_ms (500 ms) and is discarded if power
    drops meanwhile, since the relay can drop before the opto
    (ctrl_power a=0 b=action).
    - Power return and house boot open a settle window of ctrl_settle_ms
    (10 s); openSyncWindow no longer shortens an open window.
    Config layout change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
    [config.cpp, config.h, log.cpp, log.h, pins.h, role_house.cpp]
2026-09-30 Add a bench opener simulator for the gate board
    tools/GateSim is a bench-only Uno sketch that stands in for the CSW24UL:
    relays drive the open limit, closed limit and opener power through the
    gate's opto board, and it reads the gate's K1/K2 contacts to simulate
    travel, reversal and power loss. Serial commands add faults (stuck,
    both limits, flicker, deaf) and per-relay overrides for wiring checks.
    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
    [GateSim.ino]
2026-09-30 Attribute gate moves to LoRa only while our command is in progress
    The gate called any movement within travel_timeout_s of its last pulse
    "lora", so a local button or the AES controller shortly after one of our
    commands was reported as ours. A change now counts as ours only while a
    pulse still has a target and the gate moves toward it; relay tests set a
    target too. Docs cover the cause rule, why opener power loss shows
    not-closed, the simulator end-to-end checks, and bench notes on keys and
    the simulator's reset-on-open.
    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
    [role_gate.cpp]
2026-10-01 Add a bench end-to-end test suite
    pytest drives the real bench: both boards over the USB JSON console, the
    GateSim opener simulator and the controller via Home Assistant. Scenarios
    cover normal operation, opener faults, link outages, reboots and controller
    power faults, and check the behavioural invariants after every test. Each
    run writes per-test timelines and a summary with latencies.
    Claude-Session: https://claude.ai/code/session_015rfLYZnW9NE3fWbxBzAkZR
    [bench.py, board.py, controller.py, flows.py, gatesim.py]
2026-10-02 Fix duplicate RX frames, let the TTL govern retries, and extend the bench suite
    Firmware 0.3.2:
    - radio.cpp polls RX-single with its own register access and reads/clears the
    IRQ flags only once the radio is back in standby. The LoRa lib's
    parsePacket() cleared flags mid-packet; RX_DONE then sometimes survived and
    the same FIFO contents were returned twice (replay a == b). Measured: the
    SX127x packet counter didn't move on the duplicates.
    - Reliable slots spread their resends over the whole TTL with doubling gaps
    and give up only when it ends; STATUS's TTL is capped at 10 s. Slots hold
    until the peer is verified (at SF12 their retries starved the handshake).
    - The house resyncs an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
    [bench.py, config.h, controller.py, flows.py, link.cpp, radio.cpp, role_gate.cpp, role_house.cpp]
2026-10-02 Radio: RX continuous, listen-before-talk, self-retrying handshake (0.3.3)
    Measured on the bench first (SF9 and SF12 ping loss with debug counters):
    collisions explained the SF12 loss only; the background ~2 % came from
    RX-single timing out every 100 symbols and losing frames that straddled the
    re-arm. Not the turnaround, the channel, USB activity or the LED.
    - radio.cpp: RX continuous; flags touched only once RX_DONE is up; back to
    RX straight from radioSend(); radioChannelBusy() (RegModemStat & 0x0B).
    - link.cpp: clearToSend() for every frame. Responses go after the 25 ms
    turnaround; new frames wait the response slot plus a random backoff. A busy
    channel holds the frame (4-deep queue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
    [GateLink.ino, bench.py, config.h, link.cpp, link.h, log.cpp, log.h, radio.cpp]
2026-10-02 Link: replay-safe re-verification, async TX (0.3.4)
    - A newly verified peer session accepts only seqs above its HELLO_ACK, so
    frames recorded before a reboot can't be replayed. Answering a HELLO
    renumbers pending slots and queued frames; re-verifying the same session
    keeps its window and ACK memo.
    - A HELLO from an unknown session is challenged but no longer drops the
    verified session until the new one answers (replayed HELLOs can't take
    the link down).
    - TX is asynchronous: radioSend starts the frame, the DIO0 interrupt puts
    the radio back into RX, radioTxBusy polls as fallback and enforces the
    deadline (FSTX counts as transmitting). Turnaround moved into
    clearToSend. Gate p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
    [config.h, console.cpp, link.cpp, link.h, radio.cpp, radio.h]
2026-10-02 P2/P3 review fixes: radio recovery, gate cause, heartbeat-aware link timeout (0.3.5)
    Firmware
    - Radio: a reset seen in RX is logged (radio_fail a=2) and re-initialised;
    a failed init is retried every 5 s; a dead SPI bus isn't taken as TX done.
    - Gate cause follows the direction of travel (leaving the target limit is
    ours only when our pulse moves it off); reaching the opposite limit ends
    the command with timeout; relay tests set no target at that limit.
    - House settle window can't be ended early by a matching IN1 edge.
    - STATUS carries the gate heartbeat_s (ST_LEN 16) and is sent when it
    changes; house link timeout = max(link_timeout_s, 2.5 gate heartbeats).
    - inN_invert and cmd_ttl_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
    [GateLink.ino, GateSim.ino, bench.py, board.py, config.cpp, config.h, console.cpp, controller.py]
2026-10-02 Web console: small UI/UX fixes
    - Remember the selected tab in the URL hash; Escape dismisses the toast
    - Dim the status cards while disconnected so stale values don't read as live
    - Disable a clicked button until its request finishes (no double submits)
    - Config: Apply shows the number of pending edits; Reload asks before
    discarding them; warn before leaving the page with unapplied edits
    - Security: Generate/Copy work offline, Copy button, pasted keys may
    contain spaces/colons/dashes, live validation hint, Enter writes the key
    - Tools: relay pulse length validated (50-5000 ms) before sending; remote
    set shows the selected param's range and submits on Enter
    - Import accepts .json by ext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
2026-10-02 Reorganize docs; add trackers, CI, release workflow, bench CLI and skills
    - README trimmed to an overview that indexes the docs. Hardware, protocol,
    console reference, bench testing and development/release process move to
    docs/; the e2e suite and GateSim get their own READMEs.
    - TODO.md keeps only open items; fixed items moved into the GitHub release
    notes (v0.1.0-v0.3.5, now tagged). ROADMAP.md lists desired features.
    - CI compiles firmware and GateSim (fails on project warnings, pinned core
    and library versions) and syntax-checks web and Python; the release
    workflow attaches GateLink-<tag>.bin to each published release.
    - tools/gatelink.py: console requests from the shell, and co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
    [gatelink.py]
2026-10-03 Link quality history on each board (0.4.0)
    Each board keeps a RAM ring of hourly buckets (96 + the one in progress): frames, retries, giveups, CRC and MAC
    failures, LBT, sessions, radio faults, link-down seconds, RSSI/SNR min/avg and the noise floor. The house also
    records the gate's side from STATUS, which grows to 24 bytes (gate retries, giveups, CRC errors, noise; 16-byte
    STATUS still accepted). New console commands hist.get (paged) and hist.clear; status gains link.crc_err,
    link.noise, free_ram and the gate's counters under remote. tools/gatelink.py <board> hist dumps it as CSV.
    The gate's STATUS RSSI/SNR now come from its last authenticated frame from the house (ACKs included).
    Co-Aut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
    [GateLink.ino, app.h, board.py, config.h, console.cpp, gatelink.py, history.cpp, history.h]
2026-10-03 Web console: link history card on the Tools tab
    Pages hist.get and charts the board's hourly link record: summary tiles (link up %, worst SNR margin, resend
    rate, messages lost), then stacked panels on one time axis (received signal, SNR margin above the SF limit,
    noise floor, a problem heat strip) with a shared crosshair tooltip, arrow-key navigation, a table view and CSV
    download. The peer chart colour moves from violet to orange: blue/violet failed colour-blind separation (also
    in the ping chart).
    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
2026-10-03 Console: keep one cut line from losing the next (0.4.1)
    If the host doesn't take a USB packet within 70 ms, the SAMD core drops the rest of
    the write and the cut line has no newline, so the next reply ran into it and was lost
    too. This stopped the 120-minute soak after 18 minutes. send() now notes a short
    write and starts the next line with a newline.
    Suite: recover a whole line that follows a cut one (older firmware), and poll status
    inside waits with a 1.5 s timeout so one lost reply doesn't use up the wait.
    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
    [bench.py, board.py, config.h, console.cpp]
2026-10-03 TODO: long soak done; USB stalls cut console lines
    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
2026-10-03 README: narrow the overview wiring diagram for mobile
    Stack house and gate boards vertically (max 38 columns) instead of a
    ~110-column side-by-side layout, use ASCII arrowheads (some mobile fonts
    render ▶/◀ wide or as emoji), and move the shared-inputs note to prose.
    Claude-Session: https://claude.ai/code/session_011XheA7svzgBso2TS5GKaV1
2026-10-03 Web console: clearer feedback and fewer silent failures
    - Connect: cancelling the port chooser is no longer an error; a busy port
    (IDE monitor, upload) says so in a toast; initial-query and auto-reconnect
    failures show a toast, not just a log line
    - Status: if the board stops answering polls with the port still open, the
    header says "not responding" and the status cards dim until it recovers
    - Config: out-of-range numbers are flagged as typed; Enter applies; Save
    refuses while edits are unapplied (it writes the running config, so they
    would be left out); after Apply the Save button is marked until saved, and
    Reboot warns that applied-but-unsaved settings will be lost; import repo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
2026-10-03 Web console: setting tooltips, no text caret, phone-sized wiring diagram
    - Text no longer shows an I-beam or caret when clicked (still selectable);
    input fields keep theirs
    - Config: each setting shows just its name and an info icon; the tooltip
    (hover, keyboard focus, or tap to pin; Escape closes) says what it does
    and when you'd change it. Rewritten help text; rows stay on one line on
    phones now that the help text is gone
    - Install: compact diagram layout under 600 px (no sideways scroll at
    375 px); titles and hints wrap instead of running past their boxes
    Claude-Session: https://claude.ai/code/session_011XheA7svzgBso2TS5GK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
2026-10-03 Keep config and key across firmware uploads (0.5.0)
    Config now lives in the MKR WAN 1310's on-board SPI flash (W25Q16JV), which
    uploads don't touch, stored as (param id, value) pairs plus the key in two
    alternating sectors with a sequence number and CRC, read back after writing.
    A firmware with added/removed settings keeps every one it still knows
    (log event `cfg` counts the dropped ones). Falls back to program flash if the
    chip doesn't answer (status/info `cfg_store`).
    The chip shares SPI1/SERCOM4 with the radio, and the radio module's own MCU
    garbles flash traffic unless held in reset, which resets the SX1276 too: each
    flash access holds the module and re-initialises the radio after (~0.5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
    [GateLink.ino, config.cpp, config.h, console.cpp, extflash.cpp, extflash.h, gatelink.py, log.cpp]
2026-10-03 Flash firmware from the web console (0.5.1)
    Tools → Firmware update drives the board's Arduino SAM-BA bootloader over Web
    Serial: 1200-baud touch, erase from 0x2000, 4 KB chunks staged in RAM and
    written (S + Y), CRC-16 verify (Z), reset, then reconnect and check role and
    key survived. Install the latest release (bundled into the Pages deploy after
    each release build, since release assets have no CORS) or pick a .bin. A
    board already in its bootloader can be flashed without connecting first.
    Firmware embeds GATELINK_FW=<version> (FW_MARKER) so the page can recognise
    GateLink images and read their version; info/status report the version from
    it so the linker keeps it.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
    [GateLink.ino, config.cpp, config.h, console.cpp]
2026-10-03 Web console: list granted boards by role instead of Chrome's chooser
    Chrome's port chooser names both boards after the USB driver, so the
    Connect button now opens the page's own picker: each granted port is
    probed with info and shown as "LoRa GateLink – House/Gate/Unset" with
    fw and key state, plus Identify (LED strobe) and Forget. Add board…
    opens the chooser for a new board.
    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
2026-10-04 Report the radio's frequency error (0.5.2)
    Each good frame's frequency error (SX127x FEI, via LoRa.packetFrequencyError())
    is kept as the last value and reported as `fei` (Hz) in the status `link`
    object and in the `pong` event: the peer's carrier against ours, i.e. the two
    boards' crystal offset. Diagnostics only.
    TODO: record the house pong-loss investigation. Z-Wave, antennas, role,
    shield/wiring/USB and crystal offset are ruled out; the CRC errors follow one
    MKR board (COM6 on the bench).
    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
    [GateLink.ino, config.h, console.cpp, radio.cpp, radio.h]
2026-10-04 Web console: per-board tool results, non-overlapping status polls, state in tab title
    - Clear the ping chart, gate diagnostics and remote-set result when a
    different board connects (a reconnect of the same board keeps them).
    - Status polls time out within the poll interval and never overlap, so an
    unresponsive board no longer stacks requests; 'not responding' shows in ~4 s.
    - Tab title leads with the gate state (e.g. 'Closed · House · GateLink').
    - Back/forward and #tab links switch tabs (hashchange).
    - Cap the downloadable log buffer at 20000 lines; end the file with a newline.
    - Import no longer throws on JSON that isn't an object.
    - Format the gate-side SNR like the local one; repla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
2026-10-04 Docs: correct inaccuracies found by a full audit against the code
    console.md: config.reset semantics, missing reply/arg details, log a/b
    values. protocol.md: tx_power need not match, STATUS/CFG TTLs, where the
    DIAG layout lives. CLAUDE.md/README: DIAG layout, HELLO gap, button
    label, current example binary. e2e README and flash skill: test profile
    and ports/config.get details. Web: ctrl_settle_ms is a minimum. pages.yml
    uses actions/checkout@v5 like the other workflows.
    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
2026-10-04 Fix remote-write save reporting, unpowered relay tests, radio_fail logging (0.6.0)
    - Gate ACKs a remote config write it applied but couldn't save with the new
    RES_NOT_SAVED (5) instead of RES_OK; remote_set gains `applied`, and the
    web console says the value reverts on reboot.
    - A gate relay test while the opener is unpowered still pulses but sets no
    target, so the limit read when power returns isn't reached/timeout.
    - radioBegin() logs radio_fail a=0 with the fault count once per init
    failure (fault(), radioRestart() and setup were silent or logged b=0).
    - link.h: DIAG layout is in sendDiag(), not roles.h.
    - e2e: test_relay_test_without_power.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
    [GateLink.ino, config.h, console.cpp, link.h, log.h, radio.cpp, role_gate.cpp]
2026-10-04 Web console: mark only the settings that must match on both boards
    The Radio card claimed all its settings must match, tx_power included,
    but transmit power may differ (docs/protocol.md already says so). Now
    net_id, freq_hz, sf, bw_hz, cr and sync_word carry an asterisk, the card
    is just "Radio", the note above the form explains the asterisk (plus
    the link key), and tx_power's tooltip says it may differ.
    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
2026-10-04 Gate IN3 senses AC power: trust limits, refuse commands (0.7.0)
    At the install IN3 watches the AC-powered 24 V supply, and the CSW24UL has
    battery backup, so losing AC no longer means the opener is dead. While IN3
    is off the gate still refuses commands (RES_NO_POWER), but a limit that
    reads is trusted; with none reading it reports no_power instead of between
    (the opener's battery may be dead too). STATUS inputs bit 6 = AC lost;
    status `ac_power` on the gate and in the house's `remote`. Web console,
    docs and CLAUDE.md invariant updated.
    e2e: test_ac_loss_limits_trusted, test_ac_loss_mid_travel (GateSim relay 3
    forced off as AC loss with the opener on battery).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
    [config.h, gatesim.py, link.h, role_gate.cpp, role_house.cpp, roles.h]
2026-10-04 Optional console on Serial1 for bench power tests (0.8.0)
    New param uart_console (id 30, default 0, not remote): the same JSON
    console also runs on Serial1 (pins 13 RX / 14 TX, 1 Mbaud) for a 3.3 V
    USB-to-UART adapter, whose port survives the board losing power, so a
    power test sees the boot event at once. Each ConsolePort has its own
    request line; replies go to the asking port, events and log lines to
    both. RX is pulled up so an unplugged adapter reads idle. Applied at once
    and before the boot event. CFG_VERSION 5 (struct layout).
    Web console: new Board group. Host tools open ports at 1 Mbaud (USB CDC
    ignores it). Docs: console.md, hardware.md, CLAUDE.md.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
2026-10-04 UART console: start on a fresh line after power-up; 10 kΩ on adapter TX
    Bench power cut on the gate (VIN cut, FTDI adapter on COM12, no series
    resistor): the board powered down and came back with a clean power_on
    reset, but the adapter picked up its own TX bytes through the unpowered
    chip, and the boot event was glued onto that junk. The first UART line
    now starts with a newline. Docs recommend 10 kΩ in series (was 1 kΩ) to
    keep the current into the unpowered pins small.
    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
    [console.cpp]
2026-10-05 e2e: preflight fails on any saved input invert; IN2 wired to a live supply
    - test_bench_safe_settings fails if any inN_invert is 1 on either board at
    session start. The suite pins them to 0 during a run and puts the saved
    values back, so a stray invert (gate in2_invert 1 on the bench, which
    made the closed limit read inverted) never failed a scenario.
    - CtrlPower gains a "wired" mode: no HA plug, but the IN2 opto is on the
    controller's live 12 V, which the house board shares and so can't be cut.
    in2_invert 1 fakes the loss there (the "sim" mode assumed IN2 unwired,
    so it ran backwards). detect() picks the mode at session start; summary
    "controller power".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
    [controller.py]
2026-10-05 GateSim: closed limit through D3's NC contact, like the real AUX 2 relay
    The CSW24UL's closed-limit AUX relay energizes when NOT at the close limit,
    so the gate's IN2 is taken from its NC contact. The GateSim now drives D3's
    coil inverted with the opto wire on NC; `relay 2 on|off` and status
    `closed=` keep meaning the signal at gate IN2. Simulated power-off keeps
    D3 energized, standing in for the opener's accessory 24 V (which wets the
    contacts) disappearing. No firmware change: IN2 active is still the closed
    limit, and a dead opener, cut wire or dead opto still read not closed.
    Docs: hardware.md (wire AUX 2 NC, wet the limits from the accessory
    output), GateSim README, README diagram, web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
    [GateSim.ino]
2026-10-05 GateSim: AC and opener battery modelled apart; power rig channels
    - `ac on|off` (IN3 only: the opener carries on on its battery) and
    `battery on|off`; the opener is dead (no_power) only with neither.
    `power on|off` still sets both, so existing tests keep their meaning.
    - Power rig on D7–D10, all through NC contacts (a released coil, as
    during a Uno reset, means powered/connected): gate board supply, gate
    LiPo, house 12 V rail, house LiPo.
    - `supply none|acc|psu`: the gate board's buck fed from nothing
    modelled (explicit cuts only, the default), the opener's accessory
    output, or the AC supply.
    - `rail gate|house on|off|auto`, `rail gate|house cut <ms>` (timed on
    the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
    [GateSim.ino, bench.py, gatesim.py]
2026-10-05 e2e: drive boards over their UART console when found; flag opener presses without a gate pulse (WIP)
    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
2026-10-05 UART console at 250 kbaud: 1 Mbaud garbled ~4 % of requests (0.8.1)
    Hammering the gate's UART console with `info` requests through the FT232R
    adapter: at 1 Mbaud ~4 % came back `bad json` with the board idle (9 of
    234), and raising Serial1's interrupt priority above USB and the pin
    interrupts didn't change that. At 250 kbaud: 1 of ~690 idle and 1 of ~710
    while the gate's relay pulsed. A ~5 KB config.get reply now holds the loop
    for ~200 ms (was ~50 ms). Host tools open ports at 250 kbaud.
    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
    [board.py, config.h, console.cpp]
2026-10-05 e2e: UART consoles as read-only taps; requests stay on USB
    Driving the gate over its UART console failed the suite: ~1 % of requests
    reached the board garbled even at 250 kbaud with a 10 kΩ series resistor,
    some as still-valid JSON with a digit changed (replies came back to the
    wrong id, or "id":null), which no retry can make safe. The board-to-PC
    direction was clean. So:
    - UartTap listens on a board's UART console and records its events; it
    never sends. Each event line is recorded once, whichever console
    delivers it first (copies arrive within ms; the same event from another
    boot is seconds apart). Junk on the UART is kept as raw lines (via uart).
    - find_uarts sends only `info` on F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
    [board.py]
2026-10-05 Bench wiring page: every wire on the bench, editable by both of us
    tools/bench-wiring/wiring.json lists the devices (both boards, opto
    boards, bucks, supplies, FTDI adapter, GateSim, power rig, PC) and every
    wire as A-terminal → B-terminal with a signal, a status (connected /
    unverified / planned / open) and a note. index.html draws an overview
    (one line per device pair, coloured by its least-settled wire) and
    editable tables per site; Chrome/Edge save edits straight back to the
    file (File System Access), others can download. Seeded from the docs and
    today's bench work: wires the e2e suite exercises or the user confirmed
    are connected; the rest unverified or planned.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
2026-10-05 bench-testing.md: boards now run from bench bucks with power-blocked USB
    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
2026-10-05 Bench wiring: redo as a schematic
    Each device is a box with power terminals on top, inputs/outputs on its
    left and right, and comms (USB, UART) at the bottom. Common connections
    (+24 V, +12 V, 0 V/GND, +5 V, 3.3 V, LiPo) are horizontal buses above
    each site's row; signal wires run box to box, detouring through lanes
    under the row when a box is in the way; USB drops to a PC strip per
    site. Line style shows the status (solid connected, orange dashes
    unverified, blue dots planned, grey dots open). Click a wire to set its
    status or note; Chrome/Edge save straight back to wiring.json.
    Claude-Session: https://claude.ai/code/sess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
2026-10-05 Bench wiring: line colour is the wire's colour (dash = status); supply, buck, LiPo first in each row
    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
2026-10-05 Bench wiring: default wire colours per function, coloured buses
    Buses: +24/+12 V red, +5 V orange, 3.3 V yellow, ground black, LiPo pink;
    drops take their bus's colour. Signals keep one colour along their path:
    open limit green, closed limit blue, AC / controller power purple, OPEN
    pulse white, CLOSE pulse brown, UART per the FTDI cable, USB grey.
    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
2026-10-05 Bench wiring: clearer layout, rig cut markers, in-place save
    Layout
    - Site containers (Gate, House); names inside them drop the site prefix.
    - Relay contacts always on the right, each COM beside its NO/NC; power rig
    COM and NC are separate terminals.
    - Opto boards: "24 V / 12 V to 3.3 V Optocoupler" with the model
    (MT-301R4P-P) as a subtitle, and a +/- input pair per channel.
    - Side terminals line up across a row ("" spacer rows), so Uno D2-D4 ->
    relay IN1-IN3 and opto OUT1-4 -> MKR IN1-4 run straight; Uno pins evenly
    spaced.
    - Comms boxes (FTDI) are sized and placed so their wires drop straight.
    - Each wire leaving a box side gets its own slot in the gap; lanes run just
    under the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
2026-10-05 House drops a pending command when the gate restarts (0.9.0)
    If the gate pulsed for a command and then reset (power cut, crash) before
    its ACK reached the house, the house kept retrying; the rebooted gate,
    having lost its ACK memo and lastCmdId, accepted the renumbered command as
    new and pulsed again, seconds late. Reproduced on the bench: two OPEN
    presses 2.8 s apart. Now a HELLO from a new session after a verified one
    drops a pending CMD slot (house logs cmd_dropped); status and config
    writes are still renumbered and resent (safe to repeat). The house
    resyncs the controller to the real gate as for any dropped command.
    Bench fault injection: gate console `debug.reboot_after_cmd` (one-shot: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
    [config.h, console.cpp, link.cpp, role_gate.cpp, roles.h]
2026-10-05 Gate interlock: 100 ms dead time before reversing mid-pulse (0.9.1)
    When a pulse cut the other relay short (a reversal landing while the
    first pulse was on), K1 was released and K2 energized in the same
    instant; a contact can make before the other breaks, and the bench
    opener intermittently saw OPEN and CLOSE together (GateSim "pulse both",
    1 in 4 runs of the new test, and once in the full suite). Relay::pulse
    takes a start delay; interlockedPulse() (commands and relay tests) waits
    INTERLOCK_MS = 100 ms after releasing the other relay. Pulses with the
    other relay idle start at once, as before.
    e2e: test_gate_reversal_mid_pulse_never_overlaps.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
    [config.h, io.cpp, io.h, role_gate.cpp]
2026-10-06 Gate: first STATUS after boot waits for steady inputs (0.9.2)
    When the gate and the opener restart together (a power blip at the gate)
    the gate boots before the opener's limits come back, and its first STATUS
    said `between`: the house flashed not-closed (contact sensor open, K1
    flicking) and then reported the return to closed as an external move.
    Reproduced on the bench (~0.9 s). After boot the gate now follows its
    inputs silently and sends the first STATUS once they've been steady for
    3 s (at most 10 s after boot); status `settling`.
    GateSim: `restart <ms>` (the opener's controller rebooting: limits off,
    pulses ignored, AC stays). e2e: test_gate_boot_waits_for_opener_limits;
    Board.request_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
    [GateSim.ino, board.py, config.h, gatesim.py, role_gate.cpp]
2026-10-06 Serial opens give up after 8 s instead of hanging on a wedged port
    On the bench, after uploads, Windows twice wedged every USB serial port
    (both boards and the FTDI adapter) until the USB hub was replugged, and
    `gatelink.py ports`, `snapshot` and the e2e suite then hung in pyserial's
    open for minutes. open_serial() opens in a helper thread and raises
    SerialException after OPEN_TIMEOUT_S (8 s), which every caller already
    treats as an unavailable port; a port that opens after that is closed
    rather than left held. Used by Board.open/_reconnect and UartTap.open.
    Flash skill: one board at a time; replug the hub on "no answer within 8 s".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
2026-10-06 Bench: rig relay drive and both LiPos connected; house UART adapter on COM17; TODO for the between/external blip on a gate supply cut
    Checked 2026-10-06: rig relays all off at rest and CH1-CH4 respond to
    D7-D10 in order (contacts not wired yet). Both MKR boards rode through a
    bench-supply cut on their LiPos with no reset (after fixing swapped LiPo
    polarity on both); house on LiPo with the 12 V cut: ctrl_power 0, no
    command. House uart_console enabled (COM17).
    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
2026-10-06 Bench wiring: house adapter 10 kΩ confirmed; rig coils from the Uno 5 V
    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
2026-10-06 Bench wiring: rig CH1 (gate buck feed) and CH3 (house 12 V rail) wired and checked
    CH1 moved into the buck's IN+ branch after the split; a 10 s cut leaves
    the gate on its LiPo with its limits read as usual (the buck's caps hold
    its output ~10 s once the board is on the LiPo). CH3 cut: the house on
    its LiPo, ctrl_power 0 then 1, no command.
    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
2026-10-06 Bench: buck hold-up without LiPo (gate ~0.6 s, house ~0.1 s); USB ports also lost after power cuts
    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
2026-10-06 e2e: read-only requests fall back to the UART while USB is down
    After a real power cut a board's USB takes ~1 s longer than its UART to
    come back, and on the bench Windows twice lost both boards' USB ports
    until the hub was replugged while the boards ran fine. Requests that
    change nothing (status, info, log.get, hist.get, config.get) now go over
    the board's UART tap while its USB is down, after one quick reopen try;
    a garbled one (bad json, or a reply under a mangled id) is simply sent
    again. Commands still go only over USB, and a reconnect that fails says
    when the UART still hears the board (Windows lost the port: replug the
    hub). UartTap matches its own replies (ids from 1,000,000) and pas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
    [board.py]
2026-10-06 e2e: test_power.py, real power cuts through the bench power rig
    New `power` marker (excluded by default; `pytest tests/e2e -m power`),
    with rig CH1 (gate buck feed) and CH3 (house 12 V rail) wired and the
    LiPos out. Bench helpers power_cut() and wait_power_return() (boot from
    the UART tap, link, profile back on). Pulses a gate power cut overlapped
    are exempt from the pulse-length check; presses with no gate pulse still
    fail, which is what catches relay chatter at power-up.
    Tests: gate cut at rest, beyond the link timeout, mid-pulse, bounce,
    during a remote config save (6 lead times); house cut with the gate open;
    house 12 V dips; both sites at once.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
    [bench.py]
2026-10-07 House: only switch-OFF waits for the power sense, default 3 s (0.10.0)
    A real 12 V cut of the house rail (bench power rig, house on its LiPo)
    made the house send CLOSE: the controller's relay dropped ~0.46 s into
    the cut, but the IN2 opto only ~2.1 s in (the rail's capacitors keep it
    lit), so the 500 ms ctrl_confirm_ms expired first. 4 runs out of 4, gap
    1.64-1.66 s; the earlier test only simulated the order with in2_invert.
    A power loss can only drop the relay, which reads as OFF. So OFF edges
    (CLOSE) now wait ctrl_confirm_ms, default 3000 ms, and are discarded if
    IN2 drops meanwhile; ON edges (OPEN) are sent at once. Opening stays
    fast; closing starts ~3 s after the switch. Saved configs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
2026-10-07 e2e power tests: detect the LiPos by hand-plugged state; ride-through tests with them in
    The LiPos are plugged in or out by hand (rig CH2/CH4 unused). A module
    fixture gives each board a 1.5 s cut and sees whether it reboots; tests
    then run for that state and skip the rest. LiPo in: gate supply cut,
    AC loss with the board on the AC supply, opener dead with the board on
    the accessory output, house 12 V cut and dips (the controller's relay
    dropping before the IN2 opto), both at once. Wiring diagram and GateSim
    README: CH2/CH4 unused.
    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
2026-10-07 Bench wiring: warn when not served by serve.py; docs say always use it
    A plain http.server on :8001 made Save fall back to a file dialog. The page now
    shows a banner when it isn't served by serve.py, and CLAUDE.md and the
    bench-wiring README say to always serve it with serve.py.
2026-10-07 TODO: a short 12 V dip at the house can close then reopen the gate
    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
2026-10-07 Bench wiring: rig relay input wire colours (IN1 orange, IN2 yellow, IN3 green, IN4 purple)
2026-10-07 TODO: real controller power loss is done (0.10.0); full power checkable on the bench; remaining power-test scenarios
    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
2026-10-07 Bench: house relays on LiPo, sensed on the GateSim; CH2 mirrors K1 to the Shelly
    - docs/hardware.md: the Relay Proto Shield relays (3 V coils on the 3.3 V
    rail) work on the LiPo alone, with the bench results.
    - GateSim: D11/D12 read the house K2/K1 NC contacts (evt house k1|k2 on|off,
    status house_k1/house_k2); D8 (relay module CH2) follows house K1 so the
    Shelly still syncs while K1's own contacts go to the Uno; D10 (CH4, spare)
    held off. LiPo relay switching (lipo command, evt lipo) removed: the LiPos
    are plugged by hand. Suite client and READMEs updated.
    - Bench wiring: power rig renamed 4-Ch Relay Module; new sense and CH2 wires
    as labelled stubs (the page only draws wires wi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
2026-10-07 e2e: remaining power scenarios (opener moved while the gate is down, AC loss without LiPo, house cut with a command pending or mid config.save); --tx-power
2026-10-07 Full power passes on the bench supplies with LiPos in; summary shows an xfail that fails its invariant checks as xfailed
    Claude-Session: https://claude.ai/code/session_016uWCQ6Re8sZdVXcsbi9voG
2026-10-07 TODO: 17 dBm passes on the bench supplies with LiPos out too; only the install check is left
    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
2026-10-07 0.10.1: a failing input supply reads no_power, not a moment of between/external
    When the 24 V that wets the gate's inputs fails, a limit's opto can drop
    before IN3's, so the gate logged between/external and then no_power; on
    its return IN3 could come back before the limit (no_power -> between ->
    closed/external). With power_sense on, a move into between is now held
    BETWEEN_HOLD_MS (500 ms), or BOOT_SETTLE_MS out of no_power; a limit or
    no_power that follows within it is reported instead.
    e2e: test_input_supply_lost_limit_drops_before_ac[100, 300] (fails on
    0.10.0, passes on 0.10.1) and test_limit_lost_with_ac_still_reports_between;
    GateSim.relays() forces the input signals with a set gap.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
    [config.h, gatesim.py, role_gate.cpp]
2026-10-07 rftest: radio preflight for a new MKR board; the CRC errors were board …191117
    `tools/gatelink.py rftest` pings both ways between the house and gate boards
    (5 minutes by default) and passes with no CRC errors at either board and at
    most 1 % of pongs lost. docs/bench-testing.md gains a "New board preflight"
    section with the procedure and the bench results.
    With a spare MKR WAN 1310 (…0C301C) in place of board …191117 the CRC errors
    went from 7 to 0 and pong loss from 3.2 % to 0.2 % in 5 minutes, so the
    TODO item on the house missing pongs is closed: keep …191117 out of the install.
    Claude-Session: https://claude.ai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
    [gatelink.py]
2026-10-08 0.11.0: the board's own supply (charger power good) counts as controller power; ctrl_confirm_ms 0.5 s
    The house IN2 opto lags the Shelly's relay by ~1.65 s on a 12 V cut and misses 300 ms dips entirely (which
    closed then reopened the gate). The MKR WAN 1310's BQ24195L charger reports VIN power good lost ~0.2 s before
    the relay drops, on cuts and dips, independent of the buck set point (bench: 196-222 ms over 30 runs at 4.81,
    5.02 and 5.21 V). supply.cpp polls it read-only over I2C every 5 ms (status `supply`, log `supply`, both roles);
    new house param ctrl_power_pmic (id 31, default on) requires it as well as IN2. ctrl_confirm_ms default
    3000 -> 500. The dip test is no longer xfail; the e2e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
    [GateLink.ino, bench.py, config.cpp, config.h, log.cpp, log.h, role_house.cpp, supply.cpp]
2026-10-08 e2e baseline: put HA's controller state back to off when its relay is off
    After house rail cuts and dips the Shelly reboots and follows K1 off, but HA keeps showing it on and then
    ignores the next turn_on, so the controller-fault tests failed when run right after the power tests.
    Claude-Session: https://claude.ai/code/session_01VTCnJLCBq1sMnDMdLAwyk6
    [bench.py]
2026-10-08 0.11.1: console handles one request per loop pass; USB lines go out a packet at a time
    With requests sent back to back (4 status requests in flight on the house),
    consolePoll() kept handling them while bytes kept arriving, never returned to
    loop(), and the watchdog reset the board after 8 s. It now handles at most one
    request per port per call; the rest wait in the port's buffer.
    USB writes go out one 64-byte packet at a time, each only once the endpoint's
    BK1RDY says the host took the previous one. Given a longer write, the core's
    USBDevice.send() waits between packets on the endpoint's transfer-complete flag,
    which its USB interrupt also clears (the CDC IN endpoint has no handler, so the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
    [GateLink.ino, bench.py, config.h, console.cpp, console.h]
2026-10-08 TODO: what's known about the cut USB lines
    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
2026-10-08 TODO: USB cut lines closed: none in a 120-minute longsoak on 0.12.0 (usb_cut 0 on both boards)
    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
2026-10-08 flash skill: gate on COM21; upload by hand with bossac when arduino-cli finds no device
    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
2026-10-08 0.12.0: CRC-checked console requests; the suite sends everything over the UART while USB is down
    A request may end with a CRC-32 of itself ("crc" as its last member, over the
    request without it). A mismatch is refused `bad crc`, and on the UART, where
    requests arrive garbled (some still valid JSON with a number changed), a request
    without one is refused `crc required`, so a damaged request never runs.
    The suite adds the CRC to every request (with_crc) and, while a board's USB is
    down, sends any request over its UART tap, not just reads: after a power cut
    the test profile, config writes and saves no longer wait for USB, which Windows
    sometimes loses until the hub is replugged. Refused reques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
    [board.py, config.h, console.cpp]
2026-10-08 e2e: a UART request answered crc required is resent too (garbling took its crc member)
    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
2026-10-08 e2e README: measured UART garbling, crc required, identify resent
    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
2026-10-08 Docs: accuracy pass against the code
    - hardware.md: ctrl_confirm_ms stays 0.5 s by default (3 s is advice with
    ctrl_power_pmic off); no wait with both power senses off
    - web Install note: only switch-off (CLOSE) edges wait ctrl_confirm_ms
    - -m power runs LiPo-in or LiPo-out tests per state (CLAUDE.md, pytest.ini,
    e2e README)
    - UART garbling: ~1 % while busy, ~8 % back to back (console.md, CLAUDE.md)
    - ROADMAP: RAM can at best survive warm resets (matches the TODO .noinit trial)
    - README: generic release .bin name; index tools/bench-wiring
    - protocol.md: HELLO_ACK, DIAG_REQ; e2e README: needs_key marker;
    GateSim README: evt jammed/ignored, status travel/fault/polarity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
2026-10-08 0.12.1: a link silent for 2^31 ms no longer reads as up again
    lastRxAt was never refreshed while nothing was heard, so after ~24.8 days of
    silence the signed elapsed() check went negative and appLinkUp reported the
    link up: house K2 stopped failing open and sync re-armed. linkPoll now keeps
    lastRxAt at most 2^30 ms (~12.4 days) old; status age_ms tops out there.
    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
    [config.h, link.cpp]
2026-10-08 0.12.2: interlock gap also after the other relay's pulse ended by itself
    interlockedPulse waited INTERLOCK_MS only when the other relay was still on.
    If its pulse had ended on its own a few ms earlier, the new pulse started at
    once, while that contact might still be breaking. Relay now remembers when its
    coil released, and the new pulse waits out what is left of the gap.
    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
2026-10-08 0.12.3: watchdog from the start of setup()
    The watchdog was enabled only at the end of setup(), after the flash config
    load, the charger's I2C read (the core's Wire waits without a timeout) and the
    radio init, so a hang in any of them left the board stuck until power was
    cycled. Enable it right after the relays are de-energised and reset it between
    the slower steps.
    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
    [GateLink.ino, config.h]
2026-10-08 0.12.4: house time stamps can't wrap after weeks unused
    elapsed() is signed, so a stamp left alone for 2^31 ms (~24.8 days) reads as
    in the future. On the house:
    - settleUntil (boot / controller power return) was never cleared: a matching
    IN1 edge then never ended a sync window early, so a real user edge in the
    window was swallowed as sync and later reverted, and a new power return
    didn't refresh it.
    - mismatchSince, kept while the link was down, would delay the resync after a
    link that came back after 25-50 days.
    - betweenSince, with the gate's last report between, would make holdingTravel
    true again.
    houseLoop now caps them (capStamps), as linkPoll does for lastRxAt.
    Co-Authored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
    [config.h, role_house.cpp]
2026-10-08 0.12.5: a command refused for no AC power puts the Shelly back at once
    A RES_NO_POWER ACK (the gate refused without pulsing) only set cmd_result, so
    the Shelly kept showing the move that wouldn't happen until mismatch_timeout_s
    (75 s by default) ran out. It now sets checkSoon, so the resync runs as soon as
    nothing else is in the way, as an overridden command already does.
    test_ac_loss_limits_trusted now expects the resync within 5 s.
    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
2026-10-09 Web: house shows the gate state as stale while the link is down
    The house keeps reporting the gate's last state after the link drops, and the
    page showed it as live: a big green "Closed" (and a "Closed" tab title) while
    the contact sensor had already failed open. With link_up false the state is
    now struck through and greyed, with "Link lost: last known state, not live"
    under it, and the tab title says "Link lost". The Link card gets a Link up/down
    row on the house.
    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
2026-10-09 0.13.0: the house holds a travel for the gate's travel_timeout_s
    The house used its own travel_timeout_s for holdingTravel, but only the gate's
    copy is remote-writable (and the web form groups it under the gate), so the two
    could differ: a gate raised to 120 s for a slow gate still had the house flip
    the controller to not-closed after 60 s, mid-travel. STATUS now ends with the
    gate's travel_timeout_s (26 bytes) and the house uses it; with a 24-byte STATUS
    from an older gate it keeps using its own. House status remote.travel_timeout_s
    reports it. MINOR: both boards need 0.13.0 for the fix (mixed versions still
    link and work as before).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
    [config.h, role_gate.cpp, role_house.cpp, roles.h]
2026-10-09 Web: confirm before a must-match radio change; import keeps the board's role
    Applying net_id, freq_hz, sf, bw_hz, cr or sync_word takes effect at once and
    takes the link down until the other board matches, with no warning. Apply now
    asks first and says to change the other board next. Importing a config exported
    from the other board also set its role on this one (a dirty edit that turned
    the house into a second gate on Apply): the board's role is kept unless it has
    none yet, and the toast says so.
    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
2026-10-09 Web: Apply recovers when the board stops answering part-way
    applyConfig sends changes 8 at a time. If a later chunk timed out, the
    rejection skipped the reload and the unsaved mark: the board ran the earlier
    chunks while the form still showed everything as unapplied edits and Save had
    no unsaved dot. Now it stops sending, reloads what the board has, marks Save
    unsaved if anything was applied (including a chunk whose reply was lost), puts
    the edits the board doesn't have back in the form, and says which is which.
    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
2026-10-09 Releases: publish a .sha256, never replace a binary silently, Pages checks it
    release.yml uploaded the binary with --clobber, so re-running it by hand could
    quietly swap a published binary, and nothing published its checksum: pages.yml
    hashed whatever it downloaded, so latest.json's sha256 anchored nothing. The
    release now gets GateLink-vX.Y.Z.bin.sha256 too, an attached binary is replaced
    only when the manual run ticks `replace`, and the Pages deploy checks the
    binary against the published .sha256 (releases before it get a warning).
    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
2026-10-09 CI: lint the Python with ruff and collect the e2e suite
    CI only byte-compiled the suite and tools/gatelink.py, so an import or fixture
    error (or a bench-wiring serve.py typo) surfaced only on the bench. It now
    byte-compiles all of tests/ and tools/, runs ruff (bug-finding rules only:
    pyflakes, E4/E7/E9, bugbear; ruff.toml; version pinned) and
    `pytest --collect-only` over every marker. Fixes what ruff found: an unused
    variable in test_ac_loss_limits_trusted, an unused loop variable, a
    loop-variable closure in test_remote_diag (bound explicitly; it was called in
    the same iteration), and zip(strict=True) for hist.get rows.
    Cl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
    [board.py]
2026-10-09 CI: check that firmware, suite and docs agree on shared names and numbers
    tools/check_contract.py compares the roles.h/link.h enums (gate states, causes,
    actions, ACK results) with gatelink/bench.py, log.cpp's event names with the
    log table in docs/console.md, every log or event name the suite waits for with
    what the firmware emits, and console.cpp's commands with the docs table. CI
    runs it. It found bench.py missing RES_NOT_SAVED (5) and still listing
    RES_BUSY (3, removed from the firmware): fixed.
    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
    [bench.py, check_contract.py]
2026-10-09 README: parts list, pinned library versions, clearer first-time setup
    - "What you need": the parts for one install in one table (boards, shields,
    antennas, opto board, bucks, optional LiPos, Shelly, contact sensor, opener),
    instead of scattered through docs/hardware.md.
    - Build: install the core and libraries at the versions CI uses, so a newer
    ArduinoJson or core can't break a newcomer's build while CI stays green.
    - First-time setup: the power-sense caveats are their own step, and a final
    step checks the whole loop with the gate watched (switch on/off, sensor,
    a local move followed without a command back) and exports each config.
    - e2e README: COM10 is this bench's simulator port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
2026-10-09 gatelink.py: snapshot/restore find boards by USB serial number
    snapshot keyed each board by COM port and restore opened that port, so a board
    that came back on another COM number after an upload (it happens on the bench)
    was restored to the wrong place or not at all. Snapshots are now keyed by the
    board's USB serial number (the SAMD21 chip id, which stays with the board) and
    also record the port; restore finds the board by serial, says when it moved,
    skips one that isn't connected, and still reads the old port-keyed snapshots.
    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
    [gatelink.py]
2026-10-09 TODO: GateSim AC relay doesn't pull in with the gate open
    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
2026-10-09 Web: robustness and UX fixes from review item 30
    - disconnect() bounds each stream await to 1 s and aborts the writer when the
    device is gone, so a vanished board can't hang it.
    - Reconnect checks the returning board's role and fw against the one that went
    away (allowing a pending role change or a firmware update) and warns if it's
    the other board.
    - renderConfig escapes board-supplied param names in id/aria attributes.
    - Pong peer SNR is formatted; drawRssi skips missing values instead of NaN.
    - Export saves the board's running settings, not unapplied form edits.
    - Board card shows settling (gate), config at boot + flash id, free RAM and
    USB lines lost.
    - Unsupported-browser banner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
2026-10-09 Link: hold, don't drop, a command on a replayed HELLO; per-boot session entropy (0.13.1)
    Review items 17 and 18.
    - A HELLO from an unverified session holds a pending CMD (log cmd_hold a=1)
    instead of dropping it. It's dropped when that session verifies (the gate
    restarted, a=2) and sent when the verified session answers the re-challenge
    or sends a fresh frame (a replay, a=0). A new command replaces a held one.
    - HELLOs are answered at most once a second from the verified session and once
    from all others, so a replayed flood can't hog the channel or keep
    renumbering (postponing) pending messages.
    - A deferred re-challenge stays pending until the HELLO interval lets it out,
    instea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
    [GateLink.ino, app.h, config.cpp, config.h, console.cpp, link.cpp, link.h, log.cpp]
2026-10-09 Bench: separate 5 V supply for the GateSim Uno fixes the AC relay pull-in
    With the gate open, a third GateSim coil (AC) often failed to pull in on the
    PC's USB supply. A separate 5 V supply now feeds the Uno's VIN: 25 of 25 AC
    returns with the gate open took ~0.24 s (was 21 of 25 failing), and
    test_ac_loss_mid_travel passed 6 of 6 (was failing about one run in three).
    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
2026-10-09 Bench wiring: the Uno's VIN supply is 5.1 V
    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
2026-10-09 Bench: GateSim Uno VIN at 7.55 V (above the ~6.6 V USB switch-over)
    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
2026-10-09 Gate: no flash save or radio restart while a relay pulses (0.13.2)
    A save blocks the loop for ~1 s (sector erase, then radioRestart), and
    Relay::update doesn't run meanwhile, so a pulse whose end fell inside a
    save was held on until the save was done (REVIEW #19).
    - Remote config writes that reach the gate during a pulse are accepted at
    once (linkAckLater: a pending ACK memo entry, so the house's retries are
    held quietly, not counted as replays) and applied, saved and ACKed once
    no pulse is running or waiting for its interlock start.
    - The console holds config.set, config.save, config.reset and key.set in
    the port's buffer until the pulse is over.
    - paramValid is public (CFG_SET is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
    [GateLink.ino, app.h, config.cpp, config.h, console.cpp, link.cpp, link.h, role_gate.cpp]
2026-10-09 Host unit tests for link.cpp and config.cpp (tests/native)
    REVIEW #16. The real link.cpp and config.cpp built with g++ against fakes,
    covering paths the bench can't reach. CI runs them in the firmware job.
    - Two link nodes in one process: link.cpp is compiled into a namespace per
    node (its state is file-scope statics); Node::Ctx swaps each node's
    Config into the globals per call. A simulated channel models LoRa
    airtime, half duplex, LBT detection, drops and injected (replayed)
    frames; a fake NOR flash models power cuts mid-program and garbled reads.
    - 22 link tests: handshake, wrong key/net_id, reliable delivery, the ACK
    memo and linkAckLater, replays within and across sessions an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
    [link_types.h, sim.cpp, sim.h, test_config.cpp]
2026-10-09 Config saves: refuse on a bad read-back, keep unknown settings (0.13.3)
    configSaveParam/configSaveKey re-read the record to save on top of. A
    garbled read used to reset the cached sector, so the save started over at
    seq 1 in sector 0 and lost to the older record at the next boot; a newer
    record gone bad made the older one the base and dropped its change. Now
    the read is retried once and the save is refused (RES_NOT_SAVED / flash
    write failed) if it still finds no record, or one older than the cached
    seq. configLoad resets the cache when it finds nothing.
    Settings this firmware doesn't know (from a newer one) are kept from the
    loaded record and written back by every save (as many as fit the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
    [config.cpp, config.h, test_config.cpp]
2026-10-09 Link: keep the newest response in a full queue, count bad-CRC frames as air activity (0.13.4)
    REVIEW #24, small link-layer items:
    - A full TX queue dropped its head, where the newest response sits, so an
    ACK the peer waited for could go while stale HELLO/PING frames survived.
    Now the tail goes: the newest new frame, or with only responses waiting
    the oldest response.
    - lastAirAt was stamped only for frames radioReceive returned. Any RX_DONE
    (radioRxDoneCount) now restarts the turnaround and backoff, so frames
    with a bad CRC or oversize count as air activity too.
    - A HELLO_ACK is accepted only within CHALLENGE_LIFE_MS of the last HELLO
    that carried the challenge (defence in depth: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
2026-10-09 Small firmware items: relay.test range, shared CRC-32, named STATUS/DIAG layout, loop_max_us (0.13.5)
    REVIEW #25:
    - relay.test reads k and ms as int32 and range-checks before narrowing:
    k 257 or -255 pulsed K1 as a uint8_t. Bench test added.
    - remote.set validates with paramValid instead of repeating the range
    check by hand (so special cases such as the bw_hz set apply).
    - One CRC-32 (crc32.h, the console's 4-bit table version, chainable)
    for the config record and the console request check; same values.
    - STATUS input bits named (STI_*), DIAG layout named (DIAG_*,
    DiagCounter, DIAG_HDR static_assert'ed to 19) in roles.h.
    - sendDiag parses fwVersion() by hand: no sscanf (-2.3 KB flash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
2026-10-09 relay.test: refuse an ms that isn't an int32 instead of taking the default
    ArduinoJson's `| 500` returns the default for a value that doesn't fit, so
    ms 2^32 + 500 pulsed for 500 ms. Found by the new bench test.
    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
    [console.cpp]
2026-10-09 debug.replay reports whether it sent; the replayed-HELLO test replays until held
    debug.replay sends without listen-before-talk and silently sent nothing while
    the radio was busy, so test_replayed_hello_holds_command failed once (1 in 8
    runs) waiting 3 s on a single replayed HELLO. The reply now carries `sent`,
    and the test replays up to 4 times until the house holds the command.
    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
    [console.cpp, link.cpp, link.h]
2026-10-10 Share one console client between tools/gatelink.py and the e2e suite
    The client (board.py, timeline.py) moves from tests/e2e/gatelink/ to tools/gatelink_client/, with the firmware's
    enum values in wire.py (were in bench.py). gatelink.py imports it without the sys.path hack; the suite gets tools/
    on its path from pytest.ini. open_board, board_ports and find_boards live in the client, replacing conftest's and
    the CLI's copies and the CLI's two role-lookup loops. check_contract.py reads the values from wire.py. No firmware
    change.
    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
2026-10-10 Web console: ES modules, ESLint, unit and browser tests, decoded log lines
    web/app.js (2100 lines) split into ES modules under web/js/ with shared state in
    state.js; no build step. Log events show as readable text (logdecode.js), the
    downloaded log keeps the raw form. Install latest checks the image's size and
    marker version; flashing firmware before 0.5.0 warns that config and key go.
    Tooling (package.json, Node 22): ESLint, node --test unit tests for the pure
    modules (with checks against log.cpp and roles.h), Playwright tests of the real
    page against fake boards (tests/web/fake-serial.js). CI job web runs them.
    Claude-S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
2026-10-10 Web review fixes: file:// notice, reachable pre-0.5.0 warning, stricter fake board, more tests
    - Opened from a file the page explains how to open it (ES modules don't load
    from file://) instead of showing a dead page.
    - The pre-0.5.0 config-loss warning moves to the marker-less image prompt: any
    image with a version marker is 0.5.1 or later, so the old check never fired.
    - The fake board's close() refuses while streams are locked, as Chrome does;
    its status follows its own state; it records opens (no 1200-baud touch).
    - New tests: Install latest's size/checksum/version checks, reconnect after a
    cable drop and a different board coming back, the key, reload/reset,
    identify, auto-ping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
2026-10-10 Release criteria, with the evidence recorded and checked for every release
    docs/release-criteria.md sets what a release must pass on the bench, by kind
    (PATCH: CI, full suite with the wrong-key test, soak 20; MINOR adds power runs
    with LiPos out and in, a 60-minute long soak and a 17 dBm full suite; MAJOR a
    24-hour soak and the install checks), on which hardware, and what counts.
    The e2e suite now writes results/<run>/summary.json (boards, firmware, git
    tree, options, outcomes, facts). tools/release_evidence.py collects the runs
    of a version into docs/releases/vX.Y.Z.md and checks it; release.yml refuses
    to build a tag without passing evidence and attaches the file. The /release
    skill follo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
    [gatelink.py, release_evidence.py]
2026-10-10 Agent tooling: hooks, /bench, /doc-audit, /pr-followup skills, nightly routines
    Hooks in .claude/settings.json run tools/agent/hooks.py (through hook.sh, which finds
    a Python 3 on Linux and in Windows' Git Bash):
    - PostToolUse: fast checks for the file just written (node --check and ESLint, Python
    compile and ruff, JSON/YAML, Markdown links, skill/routine front matter and paths,
    tools/check_contract.py for console contract files); failures go back to Claude.
    - Stop: a change checklist over the branch since it left main (FW_VERSION, host
    tests, docs/console.md, wiring, PARAMS help text, web tests, hook tests, skills
    naming a changed tool, TODO/ROADMAP), each item asked once per sessio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
2026-10-10 CI hardening: pinned actions and runners, size budget, FW_VERSION gate, actionlint, Dependabot
    - Every action pinned to a full commit SHA (tag in a comment), runners to
    ubuntu-24.04 (ubuntu-latest moves to a new image on its own), timeouts on
    every job, superseded pull request runs cancelled (never main's).
    - Arduino cores and libraries cached (key = the pinned versions); pip cached.
    - tools/fw_size.py: CI fails a firmware build over 160 KB flash or 24 KB static
    RAM (the stack and heap keep 8 KB; config.get alone takes ~5 KB) and writes the
    sizes to the job summary. Tests in tests/tools/test_fw_size.py.
    - Pull requests that change firmware/GateLink without bumping FW_VERSION fail
    (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
    [fw_size.py]
2026-10-10 tools/flash.py: bench uploads with every wait bounded, checked against the .bin
    arduino-cli upload hung in bossac on the bench (2026-10-10) and left the house
    board wedged in its bootloader, off USB until replugged. tools/flash.py does the
    same sequence with bounds: the 1200-baud touch, waiting for the bootloader's own
    port, bossac with a timeout, then the board back by its USB serial number,
    answering info with the version in the .bin's GATELINK_FW= marker. Targets are
    roles, app ports or a bootloader port (written directly). Failures say what to do
    (double-tap reset, replug) instead of hanging.
    Tested on the bench gate (COM21 -> bootloader COM18 -> COM21, fw 0.13.7, config
    and key kept);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
    [flash.py]
2026-10-10 Reference docs from source: tools/docgen.py generates or checks every table
    tools/docgen.py (standard library, plus node to read the web modules) exits 1
    listing every drift between the docs and the source, with its fix; --write
    regenerates the generated sections. CI runs it.
    Generated: docs/config.md (every setting by Config-tab group: id, range,
    default, when a change applies, help text), and the "Wire formats" section of
    docs/protocol.md (message types, ACK results, STATUS and DIAG layouts, input
    bits and enums from link.h and roles.h).
    Checked: status fields per part against docs/console.md (including helper
    functions that add fields), console commands' arguments and replies and the on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
    [docgen.py]
2026-10-10 Agent hooks run docgen: after a doc edit, and in the stop checklist
    tools/docgen.py takes under a second, so the post-edit hook runs it after any
    Markdown edit, and the stop checklist asks once when the docs or a source it
    reads (firmware, web/js, tests/e2e, the bench wiring) changed and it fails.
    docgen also knows the tools' own function names (docs/agent-tooling.md names the
    hooks') and Claude Code's run_in_background; /doc-audit runs it first.
    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
    [docgen.py]
2026-10-10 Host simulation of both boards, with tests for every behavioural invariant (0.13.6)
    Firmware (no behaviour change; byte-identical to the 0.13.6 build benched 64/64
    plus a power run): app.cpp (boot, loop, dispatch, LED, status) out of
    GateLink.ino, board.h for what needs the chip (watchdog kick, reset, free RAM),
    console_io.cpp for the console transport (USB packets, UART).
    tests/native systests: both boards' whole firmware, one dlopen'd copy of node.so
    per board, in a simulated site on one clock: the opener (limits, travel, AC and
    battery, jams, other controllers, a siren), the controller (Shelly) and its 12 V
    rail, the house charger's power good, LiPos, each board's SPI flash, and a radio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
    [GateLink.ino, app.cpp, app.h, board.h, config.h, console.cpp]
2026-10-10 Fuzz the frame, console and config parsers with libFuzzer
    tests/native/fuzz: three libFuzzer targets over the whole firmware (both roles,
    link, console, config) under ASan/UBSan, with fresh firmware state per input
    (RAM sections snapshotted and restored, checked by check_sections.sh):
    - fuzz_frames plays the peer (real HELLO handshake and HMAC tags), so it gets
    past the MAC and replay window: authenticated frames of any type, replays,
    peer restarts, pins, supply, console requests, radio faults and time near the
    millis() wrap; relay invariants checked every ms (interlock, pulse length).
    - fuzz_console: console lines on USB and UART, with and without CRC; every
    output line must be one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
2026-10-10 Link: frames heard often can't starve ours; resends spread over the TTL (0.13.7)
    - Listen-before-talk: every frame heard restarts the turnaround and backoff, so
    frames arriving more often than the backoff (a neighbour's LoRa on our channel,
    or replays) held new frames off until their TTL ran out (TODO.md). A frame held
    back past waitCapMs() now goes as soon as a frame heard ends, or once the
    channel has been quiet for its backoff; a busy channel still holds it.
    Counted in lbt_forced.
    - Retries: the gaps double from TTL/32 but never beyond an even share of what's
    left, and the default retries is 8 (was 5): a command keeps 4 sends after a
    5 s outage (was 1). With retries 5 the sc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
2026-10-10 Link: stamps idle for 25 days no longer read as recent
    After ~24.9 days of a steady link the HELLO answer stamps read as in the future
    with the signed elapsed(), so a restarted peer's HELLOs were ignored for weeks
    (link down, sensor open); after 25 quiet days the last air activity did the
    same and listen-before-talk held every frame; and a HELLO_ACK to a challenge
    sent 25 days earlier passed the age check. Ages are now unsigned there, and
    lastAirAt is capped like lastRxAt. Found by the threat model review.
    The test fakes' transmit-busy check had the same flaw (sim.cpp, world.cpp).
    Claude-Session: https://claude.ai/code/se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
    [link.cpp, test_link.cpp]
2026-10-10 Link: docgen follows the new retry spacing; web fixture retries 8
    docgen's model of the command retry schedule now mirrors retryDelay() (gaps
    doubling from a 32nd of the TTL, capped at an even share of what's left), and
    docs/protocol.md lists the 8-retry schedule it checks (0.3, 0.9, 2.2, 3.7, 5.2,
    6.7, 8.2 and 9.7 s at 10 s). config.md regenerated for retries 8; the web
    console's fake board defaults to retries 8 like configDefaults().
    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
    [docgen.py]
2026-10-10 Link: the busy-channel cap restarts when the channel reads clear
    clearToSend() kept busySince from an earlier busy reading after the channel had
    read clear again, so the next busy reading counted that old wait and forced the
    frame at once, straight into the frame being heard. Found when the host
    simulation's radio start-up became realistic (470 ms) and shifted the gate's
    STATUS against a neighbour sending every 135 ms: every STATUS went into a
    neighbour frame and the house lost the link. The cap is now for a channel busy
    without a break (noise read as a signal); a clear reading restarts it, and
    lbt_defers still counts each held frame once.
    The busy-channel system test now runs at three phas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
    [link.cpp, test_system_link.cpp, test_system_robustness.cpp]
2026-10-10 e2e: the HELLO flood test allows an ACK for each STATUS the gate resent
    The house's frame count during a replayed-HELLO flood included ACKs of the
    gate's STATUS resends; since 0.13.7 the first resend comes after TTL/32, and
    the gate, busy sending the replays, can miss the house's ACK. One bench run
    counted 7 against the limit of 6 (a rerun passed). The bound now adds the gate's
    resends during the flood; unlimited HELLO answers would still be about one per
    replay.
    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
2026-10-10 Link: a held message's wait for the channel starts over when it may go
    A command held on a replayed HELLO (cmd_hold), or a reliable message waiting for
    the peer to verify, kept the listen-before-talk wait it had begun before the
    hold. Released seconds later, it read as held back past waitCapMs(), skipped its
    backoff, went within a few ms of the frame that released it, and was counted as
    lbt_forced (seen on the bench: a 1.8 s hold). Such a slot now resets its Lbt.
    Host test link_command_held_on_a_replayed_hello_keeps_its_backoff (fails
    without the fix: lbt_forced on release) and mutation link_m3. The web log
    decoder and the bench's anomaly line no longer call lbt_forced's value the time
    a ch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
    [bench.py, link.cpp, test_system_link.cpp]
2026-10-10 Key lifecycle: key ids, weak-key refusal, encrypted key backups, key docs
    Firmware (0.13.8): info and config.get report key_id, the first 4 bytes of
    HMAC-SHA256(key, "GateLink key id v1") as 8 hex digits (null without a key), so
    two boards' keys can be compared without reading them back. key.set refuses weak
    keys: all bytes equal, counting up or down by one, or 8 or fewer distinct bytes.
    Host tests check both against shared vectors.
    Web console: a Security tab (key id, generate, write, encrypted backup and
    restore in GLKB v1: PBKDF2-SHA256 600k + AES-256-GCM bound to the key id), the
    key id in the board picker; weak keys flagged before writing. web/js/keys.js
    holds the format; unit and brow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
2026-10-11 Fix the bugs the host simulation and fuzzing found (0.13.9)
    Every XFAIL system test and fuzz reproducer from #82 and #83 now passes; each
    fix has a test that fails without it.
    Gate relays and loop:
    - A command for a relay already pulsing (or waiting out the interlock) is the
    same press: ACKed, the pulse isn't restarted. A gate relay test then is
    refused `busy`.
    - The radio is never restarted during a pulse: radio.cpp marks it down and
    appLoop calls radioRecover() once no relay pulses (LoRa.begin() stops the
    loop ~0.5 s).
    - A console `reboot` is held while a relay pulses, like config.save.
    - A fifth remote config write during one pulse is refused (linkRefuse: not
    ACKed and its seq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
    [app.cpp, app.h, config.cpp, config.h, console.cpp, console_io.cpp, docgen.py, fuzz_config.cpp]
2026-10-11 Threat model: what GateLink protects, from whom, and what is open
    docs/threat-model.md from a review of 0.13.6: five surfaces analysed, every
    high and medium threat checked against the code. Threats by stable id with
    severity and status, accepted risks, and an install security checklist.
    ROADMAP gets the open design items (protocol hardening, a missed-move latch,
    console lock, tamper input, plausibility checks, the AC-close policy, image
    verification, a dedicated origin); TODO the open fixes and the repository
    settings for the owner. protocol.md no longer claims frames can't be replayed
    at all: withheld frames still can.
    C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
2026-10-11 Fault output on D5 and persistent link history (0.14.0)
    Fault output (fault_out, id 32, off by default; fault_hold_s, id 33, 10 s):
    with it on, D5 is HIGH while the board is healthy and LOW otherwise, so a dead
    board, a cut wire or a reset reads as a fault too. Problems (health.cpp):
    starting (until the role has decided), radio, link, AC lost, gate no_power,
    gate fault, on the board where they apply. A problem must last fault_hold_s
    before D5 drops; recovery raises it at once. D5 drives nothing else and nothing
    reads it. Status fault_out and health, log event health. The gate's link now
    times out after max(link_timeout_s, 2.5 x its heartbeat), like the house's, so a
    long heartbeat doesn't re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
    [app.cpp, app.h, board.py, config.cpp, config.h, console.cpp, crc32.h, docgen.py]
2026-10-11 Threat model: statuses after the link, key and firmware fixes
    withheld-gate-frames-replayed, old-key-in-older-record and boot-counter-torn-slot
    are fixed in 0.13.9 (#86); session-id-repeat is partly (ids unique by
    construction, per-session MAC keys still open); hello-answer-stamp-deadlock
    names #84. Their TODO items go; the key backup ROADMAP item went with #85.
    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
2026-10-11 CI, part 2: cppcheck, clang-tidy and coverage of the firmware
    tests/native/Makefile gains three targets, with the host build's flags:
    - cppcheck: warning, performance and portability on every firmware file;
    - tidy: clang-tidy's bug-finding families on the host-built files, configured
    in firmware/GateLink/.clang-tidy (the checks turned off flag deliberate idioms,
    each named with its reason; ArduinoJson's pool reads as a leak inside the
    library);
    - coverage: a --coverage build in build-cov, the host tests, then gcovr on the
    firmware (MIN_LINES=n fails below n %). The host tests cover 90.0 % of the
    firmware's lines and 67.2 % of its branches today.
    CI: a static job (Ubuntu 24.04's cp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
2026-10-11 config.get and hist.get link their names instead of copying them
    On the bench, 0.14.0 left the house 795 B between the heap's high-water mark and
    the stack once it had sent a full hist.get page and then config.get (1475 B
    after config.get alone; 0.13.9: 1983 B). The setting names in config.get (twice:
    params and meta) and the field names in hist.get were copied into the reply's
    heap, though they live in flash for good: they're now linked (JsonString
    static). The same sequence leaves the house 1771 B.
    The bench preflight checks it: after every hist.get page and config.get, each
    board keeps at least 1 KB (test_free_ram_after_the_largest_replies).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
2026-10-11 CLAUDE.md stays short: layer detail moves to docs/architecture.md
    CLAUDE.md is loaded into every session and had grown to 32 KB; it is now 15 KB.
    The firmware and web console design (per layer: the design, measured numbers,
    and every approach tried and abandoned) moves as written to a new
    docs/architecture.md, one section per layer. CLAUDE.md keeps a one-line summary
    per layer with its key contract and says to read the layer's section before
    changing it; every behavioural invariant, the naming rule and the bench rules
    that prevent damage stay. Less routine commands and the test-suite narrative
    move to docs/development.md, bench detail to docs/bench-testing.md.
    docgen points 28 quoted facts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
    [docgen.py]
2026-10-11 RF site survey: gatelink.py survey, a Tools-tab card, docs/install.md
    One board's console is enough (at the install often only one is on USB): each
    radio.ping's pong carries both directions' levels. The survey pings for a set time,
    one ping outstanding (the firmware reports a pong only for its latest ping; a late
    pong is told apart by its ping_id), and per direction works out the link margin
    above the SX1276 demodulation floor for the SF: SNR minus the floor, or RSSI minus
    the noise floor minus the floor once the SNR reading saturates (from 5 dB). The
    verdict comes from the weaker direction's 10th-percentile margin: good from 15 dB,
    fair from 10, marginal below; poor when more than 5 % of pi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
    [gatelink.py, survey.py]
2026-10-11 Power test: the link history survives a real power cut
    test_gate_power_cut_keeps_history (-m power, gate LiPo out): two 60 s buckets, the gate's supply cut, and after
    the boot bucket 0 reads back unchanged, the period goes on and the bucket in progress starts over under the new
    boot. TODO: the history's power-cut and cut-mid-erase checks are done on the bench; the full-log boot time is left.
    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
2026-10-11 Release evidence for v0.14.0
    MINOR release (previous v0.13.5): CI, full suite (5 and 17 dBm), soak, power with LiPos out and in, and a 60-minute
    long soak, all on 0.14.0 from main's firmware tree, with notes on the anomalies and the runs re-made.
    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
2026-10-11 TODO: D5 checked with a meter on both bench boards
    The fault output read 0.01 V off, 3.31 V healthy and 0.01 V after the hold on a link loss, an AC loss and through a
    reboot, as status fault_out reported. What a meter can't show (the pull-down, the reset float, a relay module, the
    alarm side) stays open. The wiring record had the gate on its old COM6.
    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
2026-10-12 ROADMAP: CLOSE without AC decided (Next); own console origin deferred
    Allow CLOSE without AC while a limit reads (ac-cut-refuses-close) moves to
    Next with its scope: OPEN stays refused, no_power refuses both, a PATCH on
    the gate, and the docs and tests it touches. Serving the console from its
    own origin (shared-github-io-origin) stays an idea: maybe eventually. The
    threat model records both decisions.
    Claude-Session: https://claude.ai/code/session_01DvCDd9Kr7xtwfmH5hDrU2d
2026-10-12 ROADMAP: growth ideas for hardware, firmware and the bench; no setting for CLOSE without AC
    Records the decision that allowing CLOSE without AC gets no setting to keep
    the old behaviour, and adds ideas from a review of the project at large:
    an independent closed sensor, opener battery voltage, a travel-time record,
    pulse-type controllers, several gates per house, signed updates over LoRa;
    a Hardware section (carrier board, latching house relays, surge protection,
    a later ESP32-S3/SX1262 target) under the ~$120-per-location budget; and a
    Bench and development section (uv, the bench in CI, an RF rig, fault hooks,
    GateSim senses, replaying field logs in the simulation).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
2026-10-12 ROADMAP, TODO: drop latching relays (they hold a stale state)
    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
2026-10-12 ROADMAP: merge the new ideas list, number items by area, rank them
    Merges the second ideas list into the roadmap: related items combined (journal
    with replay-flood evidence, gate read-out with longer history, trouble reporting,
    opener and supply telemetry with travel times, protocol hardening with
    encryption and command freshness, signed updates over LoRa, carrier board with
    surge protection, the RF rig, uv, bench CI), the rest kept as their own items.
    Items are numbered by area (N, F, C, H, B, D) with stable ids, and a priority
    ranking orders them by benefit, then effort.
    Dropped: fixing command retry spacing and LBT starvation, shipped in 0.13.7
    (#84). Decided 2026-10-12: radio changes wi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
2026-10-12 Logic analyzer captures for the bench (B4)
    tools/logic.py drives the bench's fx2lafw logic analyzer through sigrok-cli:
    it captures named channels, runs gatelink.py actions at set times during the
    capture (e.g. a reboot), and reports each channel's edges and any pulse
    shorter than --glitch-ms. docs/bench-testing.md covers the setup (Zadig,
    WinUSB) and the pitfalls found on the way: CHn vs Dn numbering, role lookup
    smearing --at timing (use the port), config.set being RAM-only.
    First use: house D5 through a reboot shows a 1 us HIGH spike 3 us after
    the reset, then LOW until armed and a clean rise (TODO.md). The analyzer
    and its wires are in the bench wiring record. B4 is removed from the
    roa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
2026-10-12 Bench suite: power tests need a UART tap on both boards
    The lipo check read a board's reboot only from its `boot` event, which reaches
    the timeline only through the board's UART tap. Without a tap a LiPo-out board
    read as LiPo in, so the ride-through tests ran and their no_reboot checks
    (power_cut allows the reset, so the uptime check is off) could never fail.
    The check moves to Bench.find_lipos(), which refuses an untapped board; the
    fixture then skips the power tests.
    Claude-Session: https://claude.ai/code/session_01VneCZNHaumas2NqyFbZP6y
2026-10-12 Trackers: SPI flash check down to the install boards, routines item to what's left, ROADMAP pointers
    The bench boards' SPI flash is confirmed by the v0.14.0 release evidence;
    the routines exist and run (#102, #103) but the cloud still can't reach
    downloads.arduino.cc. The bench tasks behind ROADMAP B3 and B5 now name them.
    Claude-Session: https://claude.ai/code/session_01X7F6s3PpSx6CTSaPVRGcma
2026-10-12 Web console: say what differs from the other board (F10)
    The settings that must match (net_id, freq_hz, sf, bw_hz, cr, sync_word) are
    the ones that stop the link verifying when they differ, so the boards can't
    compare them over the air. The console now remembers each board it connects,
    by role (localStorage: firmware, key id, the must-match settings), and shows on
    the Status tab's Link card what differs from the other board: "the link can't
    verify, these differ: ..." while the peer isn't verified, a MAJOR.MINOR
    firmware difference ("update both"), or "matches". Connected to the house with
    the link up, it asks the gate for its firmware once (remote.diag), so a
    house-only visit still sees the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
2026-10-12 Other board: fixes from review
    - Remember the board again after key.set, and read info before config on a
    factory reset, so the stored key id is never the one just replaced.
    - A board with no key (key_id null) differs from one with a key.
    - Ask the gate's firmware again (3 tries, 30 s apart) while no answer has come:
    DIAG_REQ isn't retried by the link.
    - Compare only once the connected board's own info and config are in, not
    while S still holds the previous board's.
    - Parse the store once, not on every status render.
    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
2026-10-12 Web console: one-line health verdict for the installer (C1)
    A line at the top of the Status tab says the most important thing wrong with
    the site as the connected board sees it, and what to do next: setup (role,
    key, radio), a reboot loop (this board's or the gate's), a link that can't
    verify (naming what differs from the other board) or is missing, the gate's
    power, limits and AC, the controller's power, start-up, then firmware or
    settings differing, a weak latest-frame margin, the supply, a past watchdog
    hang; else "All good". The raw link and board counters move under Details.
    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
2026-10-12 Health line: fixes from review
    - A fresh board with its role saved says the reboot is missing, not the role.
    - With the link down, a MAJOR.MINOR firmware difference is named instead of the
    power-and-antenna advice.
    - The line clears on disconnect and when the board stops answering.
    - The weak-link check uses the median of the last ten polls, so one frame near
    the line doesn't flip the verdict.
    - The house's start-up text covers the controller's settle window too.
    - peerDiffs() once per render; no stray divider above Details.
    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
2026-10-12 Know why a board reset, and catch reboot loops (F9, 0.15.0)
    - The watchdog's early warning (4 s into a pass that hasn't kicked it, 4 s
    before the reset) notes the interrupted program counter and the loop's
    stage in RAM that resets keep (an orphan .noinit section, CRC-checked).
    After a watchdog reset the board reports them: status hang_stage /
    hang_pc, log `hang`.
    - Reboot loops: crash_resets counts watchdog and brown-out resets in a row,
    each within an hour of the boot before. Three or more, until a boot has
    run an hour, is health `reboots`, so D5 stays low through the loop
    instead of flickering with each boot.
    - The gate reports its loop in STATUS (ST_INPUTS bit 7, compatible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
2026-10-12 Reboot loops: fixes from review
    - crash_resets saturates at 255 instead of wrapping back below the loop
    threshold (new host test).
    - The gate sends a STATUS as soon as its reboot loop ends, so the house's
    D5 doesn't wait a heartbeat.
    - A `core` stage between loop passes, so a hang in loop()'s kick or the
    core isn't blamed on updateLed.
    - Docs: four libraries in the README, STI_REBOOTS described in the
    generated table (and checked where quoted), comments on the CRC's users
    and the simulation's kick.
    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
2026-10-13 CI: host tests about 4x faster (status polling, coverage without sanitizers, a shared test queue)
    CI took ~17 min, set by the coverage job (17 min) and the firmware job's host
    tests (7.7 min). Profiling a trivial system test (7 s locally) put nearly all
    of its time in World::commission(), which read both boards' status (the
    firmware's JSON status, serialized and parsed, under ASan) every simulated
    millisecond for up to ~20 simulated seconds.
    - commission() checks its status conditions every 10 ms, through the poll()
    helper three test files each had a copy of (now one, in world.h). So do
    the reboot-loop, link and history waits that read the status.
    - Coverage builds without the sanitizer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
2026-10-13 Without AC, CLOSE still runs while a limit reads (F20)
    Cutting the AC (or the IN3 sense) could keep an open gate open: the gate refused every command
    on battery. CLOSE is the secure direction, so it now runs while a limit reads; OPEN stays
    refused, and with no limit reading (no_power) so does CLOSE. Threat ac-cut-refuses-close
    mitigated. 0.15.1.
    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
2026-10-13 Docs: a frame past the LBT wait cap still waits for a frame's end, not just a busy channel
    clearToSend (link.cpp) lets a capped frame go only within CAPPED_SLOT_MS of a heard frame's end or once its
    backoff has passed; protocol.md and architecture.md said it skipped the gaps outright.
    Claude-Session: https://claude.ai/code/session_01N4fZt4Mko71fDHc9aXcwTY
2026-10-13 Host tests: a simulated reset starts the radio's counters over
    radio.cpp's faults, crc and rx-done counters and its retry timer are RAM statics,
    so a reset clears them. The simulated radio kept them on the Board across resets:
    status radio_faults and link.crc_err carried over, history.cpp added the old counts
    to the new boot's first bucket, and a radio that failed to start again after a
    reset didn't log radio_fail a=0. dropOutputs now clears them with the rest of the
    radio's state; retryAt becomes a Board member.
    New test reset_starts_the_radio_counters_over fails without the fix.
    Claude-Session: https://claude.ai/code/session_01GKVN9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
2026-10-13 Without AC, OPEN runs while a limit reads, like CLOSE (0.15.2)
    Goal 2 names an AC outage as a case to serve, and availability outranks caution about whether a command
    is wise: refusing OPEN to save the opener's battery (about 146 cycles on the stock pair) was that caution.
    Without AC a command of either direction now runs while one limit reads, or to reverse our own pulse while
    its target is still set (no limit reads mid-travel on battery); with none reading and no pulse of ours
    under way (no_power), or both (fault), it's still refused RES_NO_POWER. Gate only: PATCH.
    Host tests, the site's invariant monitor, the mutation catalog (A1-A1d), the bench scenarios, the console
    labels (a refusal n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
2026-10-13 Host tests: monitor every refused command for a reason the gate could see
    The site's monitors only checked the safety side (no pulse that shouldn't happen), so a command refused
    when it should have run passed silently: the reversal on battery that #115 fixed was found by review, not
    by the chaos seeds that exercised it. Every cmd_refused now needs power_sense on, AC off past the debounce,
    no single limit steadily reading, and no pulse of ours under way in no_power. The chaos seeds now kill
    mutations A1, A1b (5/5) and A1d (3/5). The README's monitor list was still on the pre-0.15.2 rule.
    Claude-Session: https://claude.ai/co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
2026-10-13 Host tests: check refusals outside the gate's loop, allowing for a loop stall
    Review of #116: log lines reach World::onLog from conIoLineEnd, inside the gate's own loop, so the refusal
    monitor's gate.status() made a nested Board::call that reset the board's simulated clock mid-pass. Refusals
    are now queued and checked in World::monitor(), after both boards' ticks. The input lag it allows grows from
    debounce + 105 ms to debounce + 1.2 s: the gate handles a CMD (linkPoll) before re-reading its inputs, so a
    loop stall (a flash save or radio restart, up to ~1 s) delays its view by that much. Same kills: chaos
    seeds still catch A1 and A1b 5/5, A1d 3/5; 206/206 systests pass.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
2026-10-14 Web console: each card's module wires its own controls (C6 step 0)
    The first step of reorganizing the web console (ROADMAP C6): no visible change,
    so later steps can move cards between tabs by moving their markup.
    - Each module wires its own controls in an init function; app.js only starts
    the page and runs the connection (open, close, board events).
    - board.js holds the board's info reply, role, header line and title; cards
    showing info register onInfo (they import refreshInfo, so it can't call them).
    - tools.js split per card: ping.js, surveycard.js, remote.js, relay.js; the
    replay self-test moves to security.js. The survey pauses the ping card through
    pausePing (a disabled fields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
2026-10-14 Web console: split Tools into Link and Board tabs (C6)
    Tabs now follow the installer's jobs: Status, Link, Log, Config, Board, Install.
    - Link: link history (first), site survey, ping, and from the house the gate's
    diagnostics and remote settings.
    - Board: the link key card (was the Security tab), firmware update, and a
    Maintenance card with factory reset and, under Developer, the replay test.
    Reboot and Export stay on Config, next to Apply and Save.
    - Install: a "Check the wiring" card with the connected board's inputs and the
    relay test, next to the diagram; hidden without a board.
    - Old #tools and #security links open Link and Board.
    - Phones: the tab bar tightens and wraps, so e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
2026-10-14 Web console: health line above every tab (C6)
    - The health line (the site's one-line verdict) moves from the Status tab to
    above every tab, so a link that can't verify or a missing key shows while
    working in Config, Link or Board. Empty, it takes no room but stays the live
    region; an unchanged verdict isn't rewritten each poll (no re-announcing).
    - The no-key banner goes: the health line says it, and now also adds it to the
    setup lines (role not set, reboot pending) that outrank it.
    - A key write and a factory reset refresh the status at once, so the verdict
    doesn't lag the toast by a poll; a status pushed while polls fail doesn't
    bring the verdict back next to "not responding".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
2026-10-14 Web console: Config labels each setting and folds what this board doesn't use (C6)
    - Each setting shows a readable label with its unit, the setting's name under
    it (the docs, help texts and tools use the names).
    - The other role's group (Gate node or House node) folds away below the rest,
    by the role in the board's settings (one applied for the next reboot folds at
    once); with no role, everything shows.
    - Advanced folds the input inversions (which must stay off) and the bench UART
    console; it opens while any of them is on.
    - A fold opens when an edit lands in it (an import), and one closed over an edit
    says how many on its summary.
    - power_sense moves to Gate node (it is the gate's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
2026-10-14 Web console: setup checklist on Install, which opens first without Web Serial (C6)
    - The Install tab gets a Setup card for the connected board: role set (and
    running), link key written, the other board seen here with a matching key,
    firmware and radio settings, link up, and a site survey run to the end at
    the current radio settings judged fair or better. Each step names the tab
    where it's done; each ticks only what this board can see. Pure
    (checklist.js), unit-tested; rewritten only when it changes; cleared with the
    board; ticks read out as done / to do.
    - Without Web Serial (a phone) the page opens on Install, the tab that works.
    - README, install.md and architecture.md describe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
2026-10-14 ROADMAP F8: the addressing needs no wire change; wait on H1 and a second gate
    The frame header's src and dst bytes already address up to 255 nodes and each gate
    sends its own STATUS, so serving several gates is per-peer link and role state plus
    house I/O (H1), not a frame-format decision to make with F6. F8 moves to tier 4 and
    F6 no longer waits on it.
    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
2026-10-14 Link: encrypted payloads, 128-bit challenges, deadlines on commands (F6, 0.16.0)
    Frame format 2. Payloads are AES-128-CTR encrypted under a key derived from the
    link key, then tagged (encrypt-then-MAC). HELLO challenges are 16 bytes, so a
    library of recorded answers never matches one. Every CMD carries a deadline in
    the gate's 64-bit clock, which STATUS now carries: the gate refuses a command
    more than 2 s past it (RES_LATE, log cmd_late), so a command jammed at the gate
    and played back later never moves it. Both boards need 0.16.0 to link.
    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
2026-10-14 F6 review fixes: dated commands wait for the gate's clock; slack covers airtime
    Code and security review found:
    - the house aged its clock reading unsigned, but the STATUS handler stamps it
    with a millis() later than the loop's now: the reading was thrown away at
    once and commands went undated (signed ages now; a sim knob reproduces it);
    - a resent STATUS carries a clock seconds behind; a reading now replaces the
    one in use only if it is no further behind than 100 ppm of drift;
    - at SF12/125 kHz a STATUS and a command take seconds on the air, past a fixed
    2 s slack: the slack now adds both airtimes;
    - a press with no clock for the gate's session was dropped at once; it now
    waits up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
2026-10-14 TODO: decide whether CI pins arduino-cli (doc audit finding)
    Claude-Session: https://claude.ai/code/session_01UvwhS8x8decvkcZtj3r1Zu
2026-10-14 Show the alarm a move it missed (F17, 0.17.0)
    STATUS counts the gate's departures from closed (ST_LEFT_CLOSED, one byte). A
    house that takes a STATUS reading closed, from the same gate session, with its
    contact sensor still closed and the count past what it was when the sensor last
    went closed opens the sensor for 5 s (log missed_move), so a move hidden by
    jamming its reports is recorded by the alarm late rather than never
    (link-loss-concealment-window). Not after a link loss that already opened the
    sensor, a move it heard, or a gate reboot. A 0.17 house still takes a 0.16
    gate's 32-byte STATUS.
    Claude-Session: https://cla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
2026-10-14 Bench: a move hidden by an outage is shown on the contact sensor late (F17)
    test_move_hidden_by_an_outage_shown_late: with house linkloss_open 0, an
    open-and-close cycle during an outage leaves K2 closed; when frames return
    the house logs missed_move (a = 1) and opens K2 for 5 s, once. Passed on
    0.17.0 (run 20261014-074709: shown 4.7 s after the outage, K2 open 5.2 s
    polled). docgen checks the test's 5 s against MISSED_OPEN_MS.
    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
2026-10-15 CI: pin arduino-cli 1.5.1 in every workflow (unpinned, it built with 1.5.2-rc.1)
    setup-arduino-cli without a version takes "1.x", which it resolves to the
    highest tag starting with it, release candidates included: since 2026-07-23
    that is v1.5.2-rc.1, so CI and the release workflow built with a release
    candidate while the bench builds with 1.5.1. Every setup-arduino-cli step
    now gives version '1.5.1' (in full: the match is by prefix), development.md
    lists it, and a test checks every workflow against cloud_setup.sh's pin.
    The deps-check routine no longer bumps arduino-cli: it runs the build
    (prototypes, library discovery, linking), so like the cores it gets a TODO
    item and a bench run. TODO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
2026-10-15 Release from a draft: attach the files, then publish (immutable releases)
    Releases are immutable once published (repository setting, 2026-10-14):
    files can't be attached afterwards, so the old flow (publish, then the
    workflow uploads on release: published) would leave a release with no
    binary and its version burned. Now /release creates a draft on the
    evidence merge commit and runs the workflow by hand; it checks the draft
    (target a full SHA on main, tag free), FW_VERSION and the evidence,
    builds, attaches the .bin, .sha256 and evidence, and publishes, which
    creates the tag. A failure leaves a private draft to fix and rerun.
    The write token is only in the jobs that run GitHub's own API and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
2026-10-15 Release evidence for v0.17.0
    MINOR release after v0.15.2; every required criterion met on the release
    bench boards with 0.17.0 (firmware tree 430bcbeca7): full suite 67 passed,
    soak, power with LiPos out (24 passed, 6 skipped) and in (6 passed, 24
    skipped), 60-minute long soak, and the full suite at 17 dBm (66 passed,
    test_history_outage failed and passed its one rerun). TODO.md names it as
    flaky with the cause (the baseline after a gate reboot), and records the
    slow session verification at 17 dBm it exposed (on 0.15.2 too).
    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
2026-10-15 Trackers: B2 points at bench-testing.md for the rejected board, not TODO.md
    TODO.md no longer mentions board …191117; docs/bench-testing.md (new-board
    preflight) and docs/release-criteria.md hold it.
    Claude-Session: https://claude.ai/code/session_01E6NBXZKMeUnGZTRLVth4wE
2026-10-15 Bench baseline: wait for a STATUS from the gate's current boot
    After a gate reboot the house keeps link_up from the old session's last
    STATUS until it times out, and verifying the new session can take seconds
    at 17 dBm. test_history_outage started in that gap and cut a link that
    wasn't up (gate down_s 0, run 20261014-231116). The baseline now also
    requires the house's remote.uptime_s to be no more than the gate's own
    uptime: a STATUS from the boot before reports more, unless that boot was
    shorter than the time since the reboot.
    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
2026-10-15 Bench baseline: prove the session with a ping, not uptimes
    Review: the uptime comparison missed a session the gate restarts without
    rebooting (a radio or key change, which apply_profile itself makes at
    --tx-power 17), passed after a short previous boot, and broke once the
    gate's 32-bit millis() wrapped. The house drops every frame that isn't from
    the gate session it has verified, so a pong proves that session is the
    gate's current one. The gate is asked only once the house has the link up.
    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
2026-10-15 Gate: hold fault after both limits read until the open limit reads alone (F14)
    A closed limit stuck on (the AUX2 relay's NC contact with the relay not
    energizing) read fault only at the open limit and closed everywhere else.
    Both limits reading now holds fault until the open limit reads alone, so
    it reads not closed from the first full opening on. F14 narrowed to what
    is left; the other proposed checks recorded as not built. 0.17.1.
    Claude-Session: https://claude.ai/code/session_01HrwL8qRC5127RQodwvyTgR
2026-10-15 F14: hold only after both limits read 500 ms; review fixes
    A shorter overlap (a glitch, the relays switching over) is a moment's
    fault, not one held until the gate next opens. World monitor waits for the
    gate's lag and compares its stamps signed; health line and docs say how a
    held fault clears and that it refuses commands without AC.
    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
2026-10-16 Gate: a closed limit with no travel before it isn't trusted
    No gate goes from one limit to the other without reading between, but the
    opener's controller restarting drops its AUX relays: the open limit
    releases and the closed one's NC contact reads, for as long as the restart
    takes. Both ways of seeing that now go to not closed:
    - closed straight from open (neither limit read for BETWEEN_HOLD_MS in
    between) sets closedUnproven, so it reads fault until the open limit
    reads alone;
    - out of no_power with AC back, a move into closed waits BOOT_SETTLE_MS
    like a move into between (the restarting opener's 24 V wets the NC
    contact before it energizes AUX2). Without AC the opener's 24 V never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
2026-10-16 Gate: review fixes for the closed-limit holds
    - Out of no_power a move into closed is held whatever IN3 reads (IN3 can
    settle after the limit, and AC can flicker), and the hold starts over
    when the held reading changes, so a closed limit that reads late in a
    between hold gets the full BOOT_SETTLE_MS.
    - Closed straight from open reads fault through readState (fromOpen)
    instead of latching closedUnproven: a real move afterwards is trusted.
    - The hold condition is written positively; the neither-limit tracking is
    one branch.
    - World monitor: closed may not be reported while the open limit has read
    alone with no neither since (fromOpenSure), so the check covers
    power_sense off too.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
2026-10-16 Web: the ping card shows each pong's margin, for aiming an antenna (C3)
    The ping card already pings every 3 s and shows both ends' RSSI/SNR; it now also
    shows the margin above the SF's floor both ways (sampleMargin, with the noise
    floors from the last status), coloured by the survey's good/fair thresholds.
    The survey card and install.md point at it. Removes C3 from the roadmap.
    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
2026-10-17 House: a dead IN2 opto is a health problem, ctrl_sense (F14)
    IN2 and the house board's supply share the controller's 12 V, and a real cut
    takes the supply down ~0.2 s before the relay and ~1.9 s before the opto. So
    IN2 off for 30 s while the charger reads the supply good is a dead opto or a
    cut wire: health `ctrl_sense` (bit 128), which drops D5 after fault_hold_s.
    Diagnostics only: the controller still counts as unpowered. Needs both power
    senses on and the charger answering.
    Host tests (dark IN2 across the millis() wraps, a long 12 V cut, each sense
    off and a silent charger), five mutations (H16-H20, all killed), a bench
    scenario, the web console's decoder and health line, docs. FW 0.17.3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
2026-10-17 Review fixes: a dead IN2 comes before the gate on its battery in the health line; comment timing
    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
2026-10-17 Bench suite: pin pulse_ms 500 in the gate's test profile
    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
2026-10-17 Web and bench hygiene: a CSP, numeric hist.get values, verified HA TLS, a localhost-only wiring server
    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
2026-10-18 Host tests: the stuck-limit tests wait out the sync window, not the mismatch timeout
    Going into fault turns K1 on, which opens a sync_window_ms window; a switch change inside it is taken as the
    controller's echo (by design, house_sync_window_boundary_inside_is_sync_outside_is_a_command). The two tests waited
    mismatch_timeout_s + 3 s for it, and one said the house was settling.
    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
2026-10-19 Fix: boot counter stuck at 0 after an erase cut short left zeros
    A power cut while the boot counter erased its other sector (every 1024
    boots) can leave that sector at zeros. configCountBoot took any zero
    slot for a read garbled on the bus and gave no count, writing nothing,
    so nothing ever erased the zeros: from then on every boot returned 0
    and session ids lost their counter-based uniqueness for good.
    Read a page with a zero slot again and, if it still reads zeros, ask
    the chip for its id (extFlashAnswers), as histlog.cpp's readSlot does:
    only a garbled id means a garbled bus; otherwise the zeros are slots
    without a count, the sector is erased again and the count goes on.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
2026-10-19 Docs: the CSW24UL's AUX relay switch settings, and why closed can't come from an energized relay
    The opener's only close-limit mode energizes the relay when not at the close limit, so 'closed' always rests on
    the relay releasing: no wiring of AUX 2 (NO, or a relay of our own) removes that, only an independent sensor (F12).
    Name the switch positions (relay 1 OFF OFF ON, relay 2 OFF ON OFF) in the hardware notes, the install checklist and
    the console's wiring help, which said 'relay A/B' and 'the opener's menu'; check relay 2 isn't left 'always off'.
    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
2026-10-20 Console: hist.clear refuses a period_s that isn't a whole number (0.17.5)
    `req["period_s"] | histPeriod()` took the default for any value that isn't a
    uint32_t, so period_s -60, 2^32+60, "120" or 120.5 cleared the history at the
    old period instead of answering "period_s must be 60..3600". One given must now
    be a uint32_t, as relay.test's ms must be an int32; none given (or null) still
    keeps the period. Host test: history_clear_refuses_a_period_that_is_not_an_integer.
    Claude-Session: https://claude.ai/code/session_013Mziv5JaGJ1JaHomDG1M4h
2026-10-20 House: a K1 relay test during a resync runs its full length (0.17.4)
    The end of a resync set K1 straight to the gate's level, cutting short a
    console relay.test of K1 started while K1 was held at the controller's
    level. It now waits for the test pulse to end, as applyOutputs already does.
    Claude-Session: https://claude.ai/code/session_01Rm5DGG7bRfsbRDuLzp47QD
2026-10-20 Health stuck: timed from the gate's latest move, never from a stale report (review)
    The gate restarts its timer on each pulse (a reversal, a move from a stop);
    the house restarts its own on a STATUS that may begin a move it didn't see
    begin (a new target, a gate restart, the first after a link outage) and says
    nothing while the link is down. STAMP_CAP_MS once, in link.h; hasProblem
    shared in world.h; hardware.md and README list the new problem.
    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
2026-10-20 TODO: the bench gate board dropping off USB on the 1200-baud touch
    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
2026-10-20 Event log kept across resets: RAM ring kept, flash journal, log.get rec (F1, 0.19.0)
    The 64-entry ring lives in the RAM every reset but power-on keeps (after the
    reset memo, CRC-checked), and is written to a journal in flash sectors 20-35
    in records of 14 (once 14 wait or the oldest has waited 10 min, at most once a
    minute, never during a pulse). Floods (mac_fail, replay, lbt_forced, input
    chatter) coalesce into one entry with a count. log.get rec=k reads the k-th
    newest record. The history log's flash code is now flashlog.cpp, shared.
    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
2026-10-20 Event log: web console Older button, docs, threat model, ROADMAP (F1 out, F21 in), mutation catalog
    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
2026-10-20 Event log: review fixes
    Coalescing looks at the newest 4 unwritten entries (two flood kinds in turn
    still coalesce) and an input's entry keeps its latest level. The kept ring's
    CRC covers all of it. logSave counts entries its own radio restart logs.
    log.get pages the journal by a cursor (before = an lseq, reply seq) instead of
    the k-th newest, reading headers only until the record it returns; the web
    console's Older button uses it, resets it per board, and says so on firmware
    without a journal. docgen checks the new quoted values.
    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
2026-10-21 Web tests: a pushed status is what the fake board answers its polls with too
    The console polls status every 2 s, and a poll answered from the fake board's own status could land between a
    test's pushed status and its checks, rendering the earlier status again: "a status from older firmware without
    link or io fields still renders" failed once that way (TODO). pushStatus sets the fake's status and pushes it, as
    firmware would report it from then on; all seven status pushes in status.spec.js use it. Forcing a poll between
    the push and the checks fails the old test and passes the new one.
    Claude-Session: https://claude.ai/code/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
2026-10-21 Link: re-ACK a memo'd seq at most 10 times, so a replay flood draws no ACKs (F21, 0.19.1)
    A copy of a frame whose seq is still in the ACK memo was re-ACKed every time. Now at most REACK_MAX (10, the
    `retries` param's maximum, so every real resend still gets its answer); copies past that are counted and logged as
    replays and draw no transmission. Replays in the history buckets: not built (an hourly count saturates at once in
    a flood, which the event log's counted entries already measure). ROADMAP F21 removed.
    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
2026-10-21 Bench: the event log test looks for the oldest unwritten entry (a record goes at once after a reset, the rest a minute apart); docs say so; TODO: both boards' USB touch failure
    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
2026-10-21 Console: stream log.get's ring reply an entry at a time, so a ring from an earlier boot fits the heap (0.19.2)
    Since 0.19.0 a ring of entries from an earlier boot (each with its `boot`) built as one JsonDocument took a slot pool
    (~1 KB) more heap than config.get: free_ram 1283 B on the bench, where the preflight (hist.get, config.get only)
    reported 2315 B. sendLogRing streams the head (any length: its closing brace held back) and then each entry from
    its own small document; send() and it share the line framing (lineBegin/lineEnd). The same ring now leaves 5339 B.
    The preflight builds log.get replies too. docgen follows a helper handed a nested object with more arguments.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
2026-10-21 Bench: baseline waits for the house to read closed before switching the controller off
    The long soak's 160th scenario (a jam) ended with the gate closed by the simulator; its STATUS reached the house
    0.84 s late, the baseline switched the controller off in between, and the house rightly took that as a user CLOSE
    (answered already, no pulse): 215 commands, 214 expected (run 20261020-233514).
    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
2026-10-23 TODO: "…" as UTF-8 (the USB-touch item had it as a cp1252 byte, which failed CI)
    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
2026-10-23 Gate: a second closed sensor on IN4 (closed_sense, F12, 0.20.0)
    With closed_sense on, the gate reads closed only while the closed limit and IN4 (a reed on the leaf) both read, and
    fault once they have disagreed for 5 s, so a failed AUX2 relay (closed-limit-nc-fail-unsafe) can't make an open gate
    read closed. Off by default; not remote-writable. The GateSim's CH4 becomes the closed sensor (relay 4), with a bench
    scenario that skips until it's wired.
    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
2026-10-23 Closed sensor: review fixes (the monitor reads closed_sense; one IN4 knob in the simulator; bench probe uses the rig's waits)
    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
2026-10-23 Closed sensor: code-review fixes (stale "limits only" wording, FACTS for the 5 s and 300 ms, battery and stop-in-zone notes, per-ms monitor, probe skips on an old GateSim)
    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
2026-10-24 Host tests: the closed-sensor monitor reads closed_sense once per spell, not each ms (coverage hit 2^32 in paramByName); TODO: the bench closed-sensor wiring and scenario still owed
    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
2026-10-24 ROADMAP F14: drop the power-on hold (the closed sensor covers it), the welded-contact check waits on H1; rank 3 -> 7
    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
2026-10-24 Web console: link history Home key with no bucket selected goes to the oldest
    With no bucket under the crosshair, any key (Home included) jumped to the newest
    bucket, so Home took two presses. Treat "none" as one past the newest, so the
    arrows still start at the newest and Home/End go where they say.
    Claude-Session: https://claude.ai/code/session_01Q9YEVwXX9ZauNSTyas96Az
2026-10-24 Web console: after flashing a board from its bootloader, don't reconnect to the board connected before
    flashFirmware only set the reconnect port (expectBack) when it reset the board
    into the bootloader itself. Started from a board already in its bootloader,
    lastPort still named the port connected last, which may be the other board:
    startReconnect reopened it within 1.5 s, before the updated board was back,
    and reportFlash judged the update by that board's info ("Updated to 0.14.0.
    Role, config and key kept." about the wrong board). Now that path clears it,
    so only the connect event finds the updated board.
    The fake boards gain a SAM-BA bootloader (spec.bootloader) so the page's side
    of an u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
2026-10-24 Docs: protocol.md: a challenge's radio noise is 32 bits, the HMAC is cut to 16 bytes
    drawChallenge (firmware/GateLink/link.cpp:309) hashes the session, a count and radioRandom32()
    and keeps CHALLENGE_LEN (16) bytes of the HMAC; "(16 bytes of it)" read as 16 bytes of noise.
    Claude-Session: https://claude.ai/code/session_019U3xtB3g8PZpeyk1qwwcvp
2026-10-24 Bench suite: poll for the 60 s bucket to close instead of sleep(62); start the opener restart from the gate's UART boot event, not sleep(0.2)
    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
2026-10-24 Bench suite: catch a reset whose new uptime outgrew the one at the test's start
    check_invariants took a board for reset only if its uptime fell (or its USB port
    dropped). A board that had just booted when the test started (after a reboot or
    a power test) and reset early in a longer test ended with more uptime than at
    the start, so with its port already down (requests over the UART) the reset
    passed. Compare the uptime's growth with the host time between the two reads.
    Claude-Session: https://claude.ai/code/session_01NryaR6AT8kWzXfrToiyj1f
2026-10-24 Bench suite: check house K1 shows the gate after every test (off only when closed; not mid-travel, in a resync or a K1 relay test, or with ctrl_sync 0); TODO: the journal miss a fourth time
    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
2026-10-24 Bench: closed sensor wired to gate IN4; its scenario times the fault on the gate's clock
    test_closed_sensor_catches_a_failed_closed_limit divided the host timestamp (already seconds) by 1000, so it read
    0.00 s; it now uses the gate's bt (ms). Wires marked connected; TODO item closed.
    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
2026-10-25 WIP: verify fixes (pass-relative invariants, house_cmds decision ghost, supply in the harness), ESBMC conditional workaround
    - gate.cpp / house.cpp: invariants stated against the pass's `now` (passT), not T.
    - house_cmds.cpp: owner-only checked where the house decides (pendingAction), a CLOSE decided before a power drop
    never goes; the rest of a gap after an outage edge bounded as a gap from there; the real supply.cpp on a stub I2C
    bus (stubs/Wire.h), a stall's waits reading power good (yield()).
    - link_window.cpp: one handleFrame call per length and the transmitter kept busy (unbounded cipher loops).
    - esbmc_run.py --log; Makefile .PHONY fixed; verify mutations name segment targets, lik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
2026-10-25 WIP: finding 3 with the install's Shelly; house_cmds judges a decision at its send; esbmc_run keeps every log
    - house_cmds.cpp: a decision is judged when its command goes (a suppressed one moves nothing).
    - Finding 3 also with the install's follow-mode Shelly: the owner switching on as K1 changes, off again, and a flash
    save delaying the Shelly's answer past ctrl_confirm_ms: CLOSE, then OPEN. Host test
    house_sync_window_survives_a_double_switch_as_k1_changes (XFAIL); the simulated Shelly's SW debounce is a field
    (swDebounceMs, 30 ms; the bench's is ~90-130 ms). The install and worst-confirm targets expect it until it's fixed.
    - esbmc_run.py writes ESBMC's whole output to BUILD/logs by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
2026-10-25 WIP: TLA command configs check through CmdView (sensor bookkeeping merged)
    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
2026-10-25 WIP: TLA bounds the gate's frames apart from the house's (MaxGateSeq)
    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
2026-10-25 WIP: Verification docs: split TLA bounds, CmdView, owner-only and I2C limits, the ESBMC conditional bug
    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
2026-10-25 WIP: TLA sensor configs check through SensorView (no commands: the command side merged)
    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
2026-10-26 WIP: finding 5's dip evidence from the e2e runs: power good drops by 150 ms, the Shelly reboots only between 200 and 300 ms
2026-10-26 WIP: link_window ends the run after each length's call, so no call's queued frames merge into the next (out of memory in reframePending)
2026-10-26 WIP: link_window proved per frame length; a HELLO_ACK for session 0 isn't taken (finding 6, 0.20.2)
    link_window ran out of memory: the transmitter kept busy queued every frame, under conditions the checker couldn't
    fix, and a HELLO's re-framing of the queue unrolled the cipher and copies to the --unwind bound. The harness now
    has the transmitter idle and the channel clear (the window never reads the sending side), and checks one frame
    length per query (LEN_MIN/LEN_MAX, the Makefile's LINK_LENGTHS): 18 queries of a few seconds each, where all
    lengths in one didn't finish in 2 hours. The cryptPayload loop bound from the last commit isn't needed: removed.
    It then found after-hello broken: a HE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
2026-10-27 WIP: TLA bounds the gate's moves off closed (MaxLeft): the departure count in every STATUS made the sensor configs infinite
2026-10-28 Gate refuses a command framed before the last one it took (finding 1, 0.20.3)
    The model checker (tools/verify/tla, CmdOrder; also CmdOnce) found that a command withheld at the gate and played
    back inside its deadline, after the owner's later command, still ran: the gate checked only the last command's id. The
    gate now keeps the seq of the last command it took from the house session (lastCmdSeq) and refuses a lower one
    (RES_LATE, log `replay`): the house frames a command only while it is in its slot, so every earlier command's frames
    have lower seqs. Host tests: link_withheld_older_command_after_a_newer_one_is_refused (was XFAIL),
    link_renumbered_resend_after_a_newer_command_is_refused. Proof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
2026-10-28 House refuses a STATUS older than any the gate still sends (finding 2, 0.20.4)
    The model checker (tools/verify/tla, SensorTruth) found that STATUS frames withheld and played back in order, one per
    link timeout, held the contact sensor closed for as long as the attacker had kept them: the house took any STATUS later
    than the last one it took. It now also dates a STATUS against its reckoning of the gate's clock (gateClockRef) and
    refuses one further behind than STATUS_TTL_MS (moved to roles.h) plus its airtime, STATUS_STALE_SLACK_MS (2 s) and the
    crystals' drift since the reading (log `replay`). CLOCK_DRIFT is 200 ppm (two +-20 ppm crystals, one outdoors, reach
    ~115 ppm); commands still aren't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
2026-10-28 A sync window ends early only once the Shelly's answer can't still come (finding 3, 0.20.5)
    The model checker (tools/verify/esbmc/house_cmds.cpp, owner-only) found that a matching IN1 edge ending K1's sync
    window at once lets the Shelly's answer to K1 become a command against the user: a user's edge begun just before K1
    moved (its debounce running), with a Shelly toggling on SW edges answering a moment later; or the install's
    follow-mode Shelly when the owner switches on just after K1 moves and off again, the Shelly following K1 back on,
    read after a loop stall (a flash save). No edge at IN1 tells the user from the Shelly there. A matching edge now only
    marks the window answered; it ends onc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
2026-10-28 Power good is read inside the loop's stalls too (finding 4, 0.20.6)
    The model checker (tools/verify/esbmc/house_cmds.cpp, owner-only, -DSTALLS_ANYWHERE) found that a 12 V dip falling
    inside a ~0.5 s loop stall (a flash save with its radio restart) was never seen by the house, yet rebooted the Shelly,
    whose relay drop then read as the owner switching off: a CLOSE. supply.cpp now reads the charger's power good from the
    stall's waits as well (supplyWait: the core's delay() calls yield(), which the firmware defines, and the flash's busy
    wait calls it), every 5 ms, and keeps a low reading for the next pass (supply a=0). It doesn't log there: it may run
    inside a flash write. The host simulator kee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
2026-10-29 tools/verify: house_cmds-stalls runs by name only, out of esbmc-house_cmds and CI, until it finishes
2026-10-29 Finding 5's dip measurement: the Shelly reboots only from ~280 ms, power good always drops first
    Dips of 200-300 ms in 10 ms steps, three rounds, house LiPo in (e2e run 20261029-045638): power good dropped in all 33
    (0.17-0.26 s in), the Shelly rebooted in 2 of 3 at 280 ms and 6 of 6 at 290-300 ms, none at 200-270 ms, its relay
    always after power good (0.37-0.43 s), no command sent. With the earlier runs (power good from 150 ms), the order the
    house command proofs rest on (BROWNOUT_AFTER_PG) holds at the install with ~130 ms of dip length to spare. Finding 5
    stays recorded for a site where it could fail; the bench task is done.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
2026-10-30 The history log never numbers a bucket UINT32_MAX: a head of UINT32_MAX - 1 isn't loaded (0.20.7)
    The nightly fuzz run (fuzz_config, 2026-10-30) loaded a log whose newest bucket was UINT32_MAX - 1: the next bucket
    appended was numbered UINT32_MAX, which histLogBegin refuses as a head (erased flash reads so), and the history came
    back empty after a reset. No board counts that far (2^32 periods), so only a corrupt record gets there; such a log now
    loads as empty and starts again from 0, as a head of UINT32_MAX did. The crash input joins the fuzz_config corpus.
2026-11-03 Web console: an emptied number field is refused by Apply, not sent as 0
    fieldValue read an empty (or unparseable) number field as Number('') = 0, so for a
    setting whose range starts at 0 (ctrl_confirm_ms, ctrl_settle_ms, fault_hold_s,
    retries, net_id, sync_word) Apply sent 0 to the board although the field was marked
    invalid. It now reads NaN, which Apply's integer check refuses.
    Claude-Session: https://claude.ai/code/session_01UKCPmTpdhXkSzf5AczZ1LS
2026-11-05 Soak: a reset in the first scenario (or soon after a flash) is caught where it happened
    test_long_soak's check after each scenario only failed when a board's uptime fell below its previous
    reading. That reading starts at 0, so a reset in the first scenario was never caught there, nor one soon
    after a flash. Compare consecutive snapshots with Bench._reset_between instead, as check_invariants does.
    The end-of-test invariant check still caught such a reset, but only after the whole soak and without naming
    the scenario.
    Claude-Session: https://claude.ai/code/session_01UKCPmW2EkUcfAgru12FR6r
2026-11-05 Fake board refuses relay.test without a role and radio.ping without a key
    As console.cpp/appPing do: the browser tests' fake board accepted both, so a
    page path showing the board's refusal was never exercised (the page said
    "K1 pulsed" where the real board says no). Adds a browser test of both
    refusals, and the fake's remaining smaller disagreements to TODO.md.
    Claude-Session: https://claude.ai/code/session_01TMNfeidvQ2uRm87Vb2ujX9
2026-11-05 Fix: cloud setup never restarts when setup.pid names a reused pid
    start_cloud_setup took any live process with the pid in ~/.cache/gatelink/setup.pid as the install still
    running. A cache kept from an earlier container named pid 203, which was this session's own Claude process: the
    install (dead in the old container, no setup.done) never restarted, and the session was told to wait on
    setup.done forever. _alive now checks /proc/<pid>/cmdline for cloud_setup.sh.
    Also records in TODO.md that `hooks.py check --base` passes when the base has no merge base.
    Claude-Session: https://claude.ai/code/session_0123KV3jMMCPVYpsXVx4HUXR
2026-11-05 Trackers: link ROADMAP F16 and TODO's unseen Shelly reboot (finding 5); F16's Today names power good
    Claude-Session: https://claude.ai/code/session_01UKCPmTzvKpUUwcND8QZCMN
2026-11-05 Docs: gate IN3 is spare with power_sense off (hardware.md)
    acPower() ignores IN3 when power_sense is 0 (role_gate.cpp:101-103), while
    updateSpareInputs() still debounces and logs it (app.cpp:269-280) and STATUS
    still carries it (role_gate.cpp, STI_IN3) - the same as gate IN4 with
    closed_sense off, which the page already called spare.
    Claude-Session: https://claude.ai/code/session_01UKCPmX62EZGkNt57uH87PM
2026-11-05 ROADMAP B5: the suite checks house K1 after each test since #177 (from the house's log, not the wire)
    Claude-Session: https://claude.ai/code/session_019kNXC19RktHdi9KH9pri28
2026-11-06 Fake board refuses a remote.set while the last one is pending
    The firmware has one config slot: a remote.set while the previous one
    still waits for its remote_set event is refused "busy" (console.cpp,
    linkPending(SLOT_CFG)). The fake board took every one and answered each
    20 ms later, so the page's Busy message was never exercised. It now holds
    one write at a time until its event (spec.remoteSetMs after it), and a
    browser test checks the page shows Busy, then the first result, then
    takes another write.
    Claude-Session: https://claude.ai/code/session_01UKCPmWkpLEQ4wf4dQP4PMw
2026-11-06 Bump uv 0.12.24 -> 0.13.5 (CI, cloud setup, required-version)
    0.13.5 rejects certificate chains with the compromised eMudhra
    intermediates (rustls-webpki 0.103.16). None of 0.13.0's breaking
    changes apply: Python is pinned to 3.12 and there are no constraints files.
    Claude-Session: https://claude.ai/code/session_01UKCPmUu2tAMFdiKnZ1jm8L
